EEVengers/ts_hardware_archive/Altium/Thunderscope_E/Schematics/FPGA.jpg

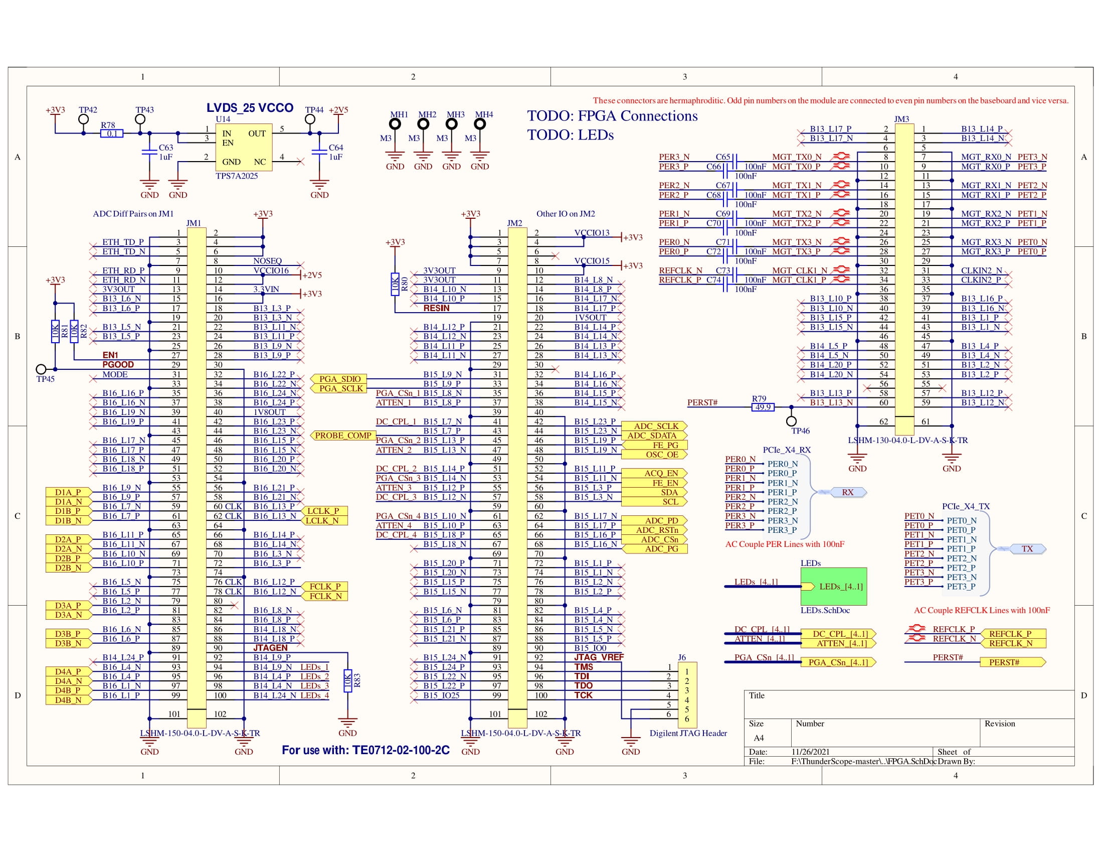
Altium/Thunderscope_E/Schematics/FPGA.jpg
