EEVengers/ts_hardware_archive/README.md

# ts_hardware_archive
Archived Hardware for ThunderScope 

All the hardware for this project is licensed under CERN-OHL-P-2.0
