EEVengers/ts_hardware_archive/Altium/Thunderscope_E/Schematics/ADC.jpg

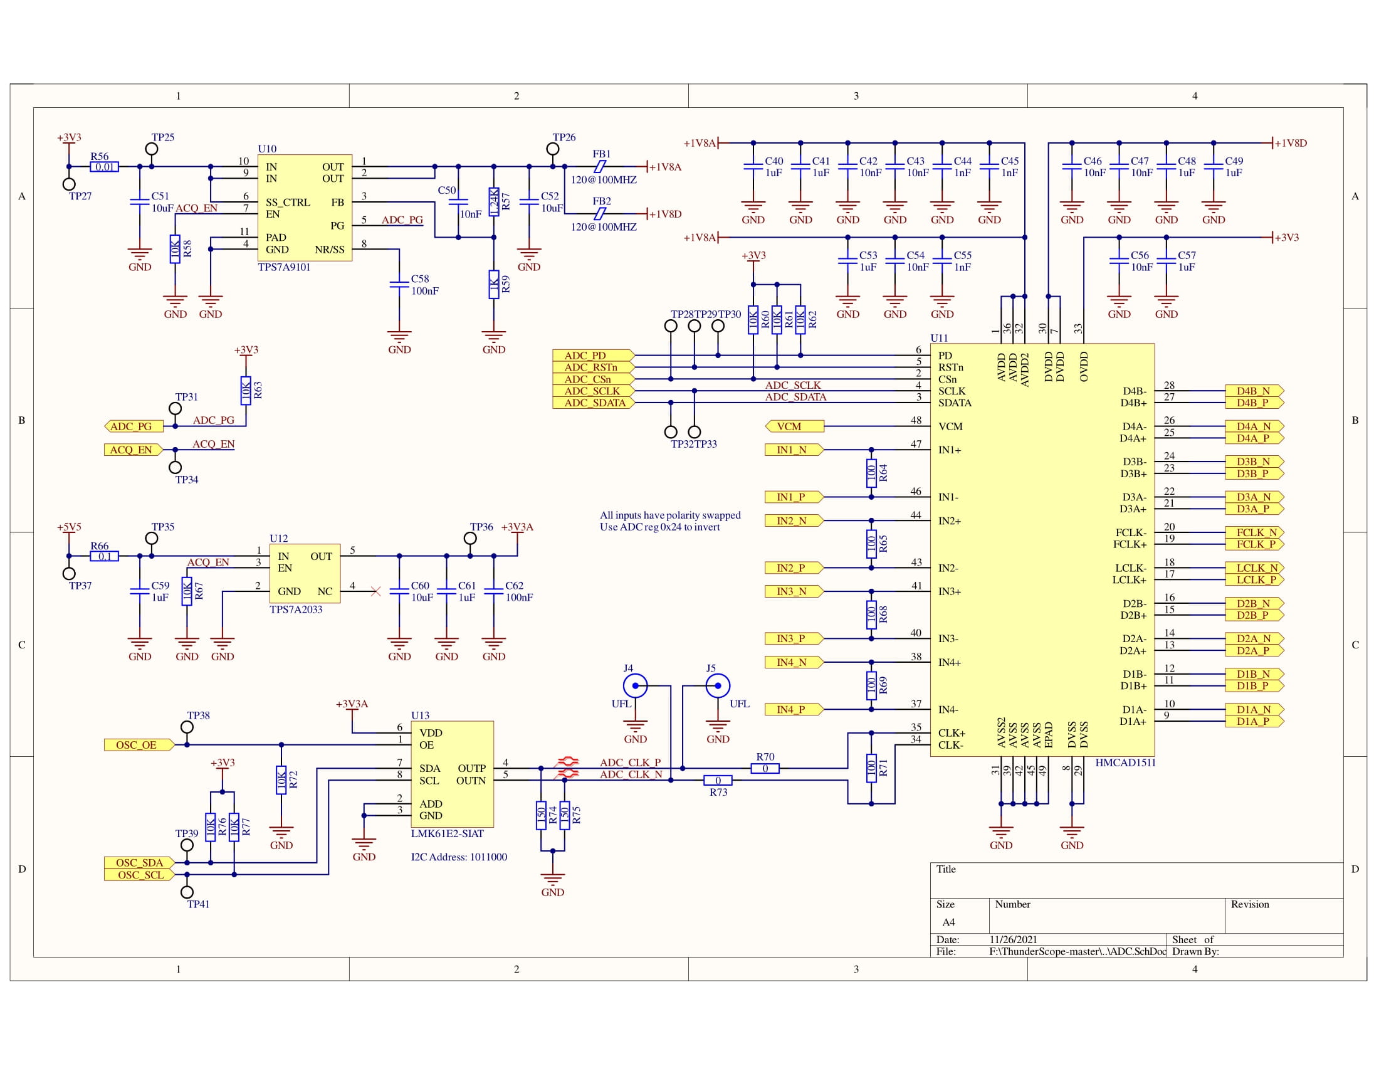
Altium/Thunderscope_E/Schematics/ADC.jpg
