EEVengers/ts_hardware_archive/Altium/Thunderscope_E/Schematics/Buffer.jpg

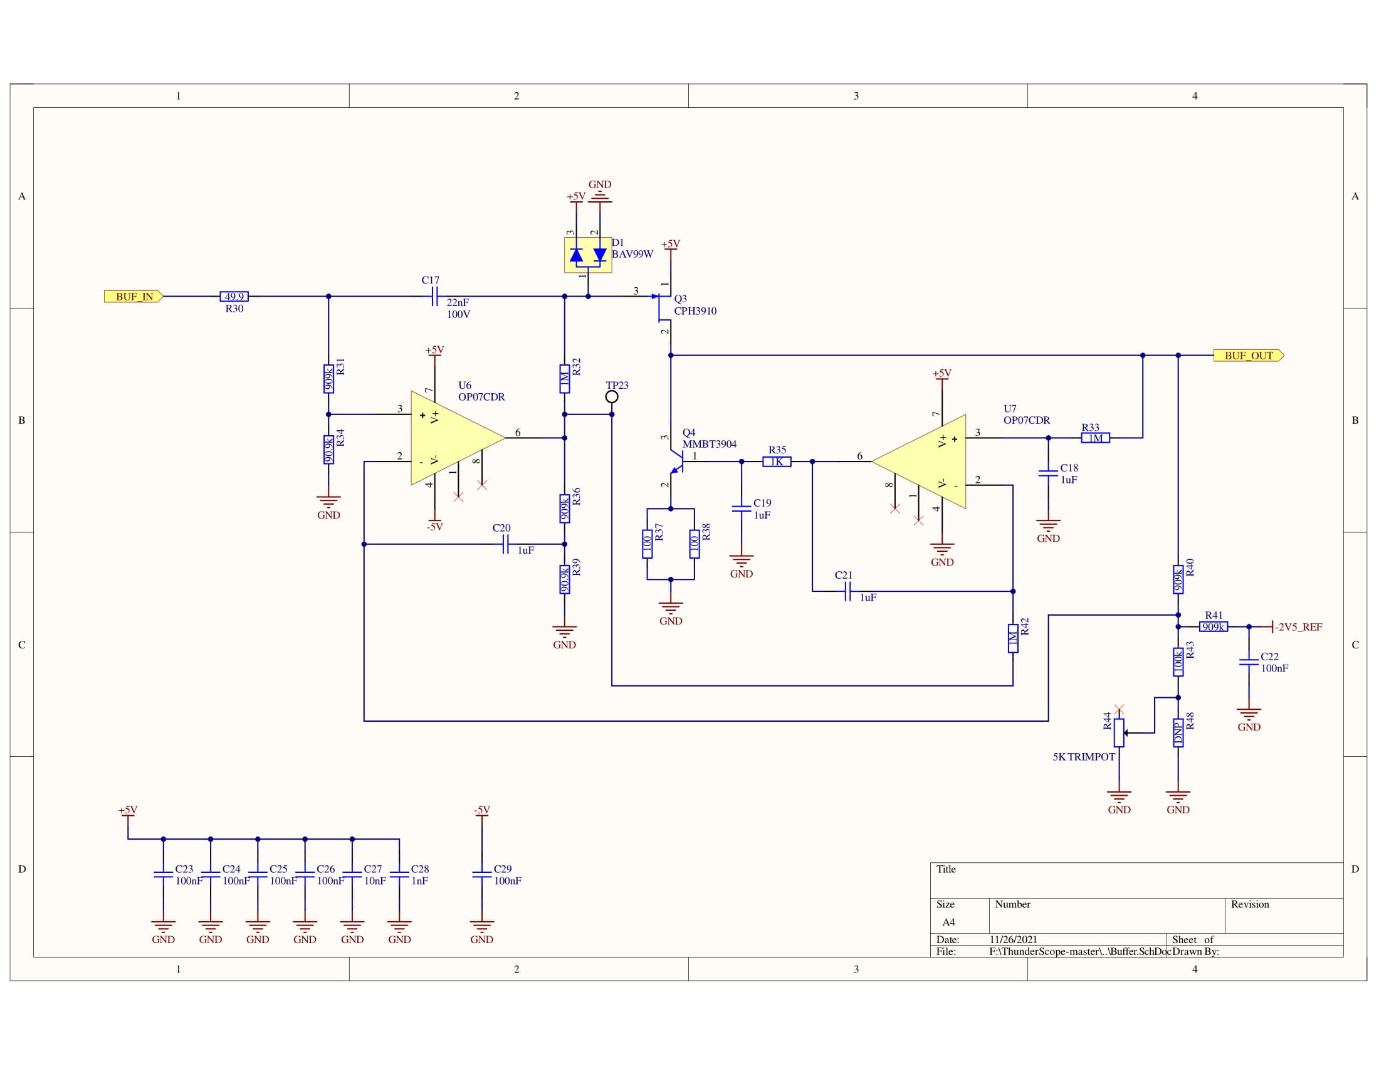
Altium/Thunderscope_E/Schematics/Buffer.jpg
