EEVengers/ts_hardware_archive/Altium/Thunderscope_E/Schematics/FE.jpg

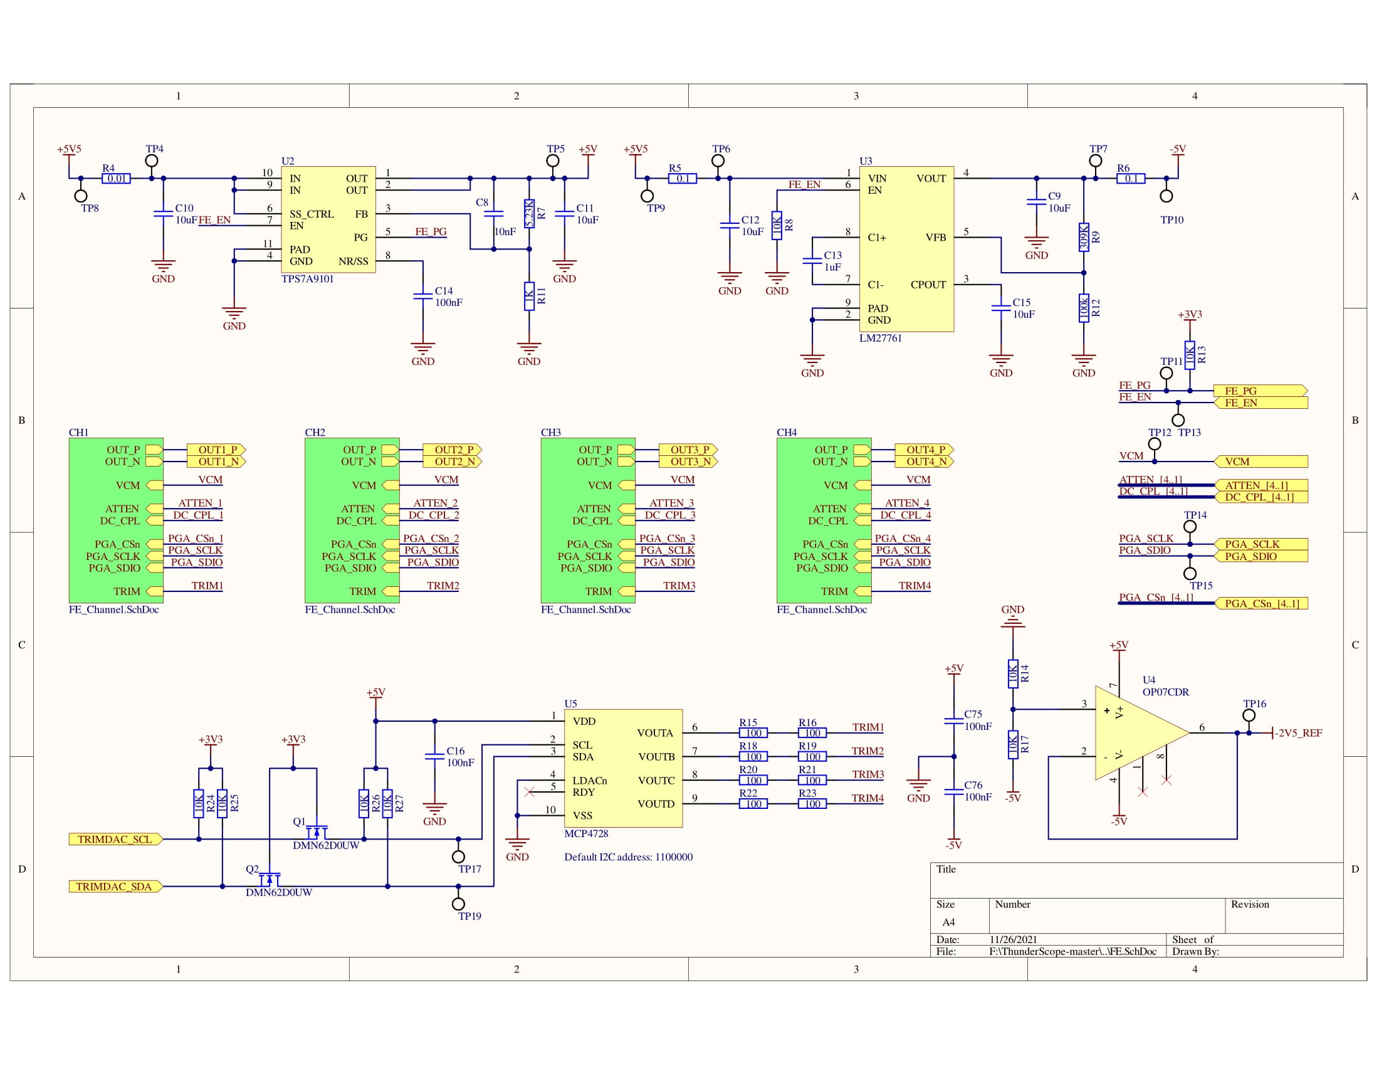
Altium/Thunderscope_E/Schematics/FE.jpg
