EEVengers/ts_hardware_archive/Altium/Thunderscope_E/Schematics/FE_Channel.jpg

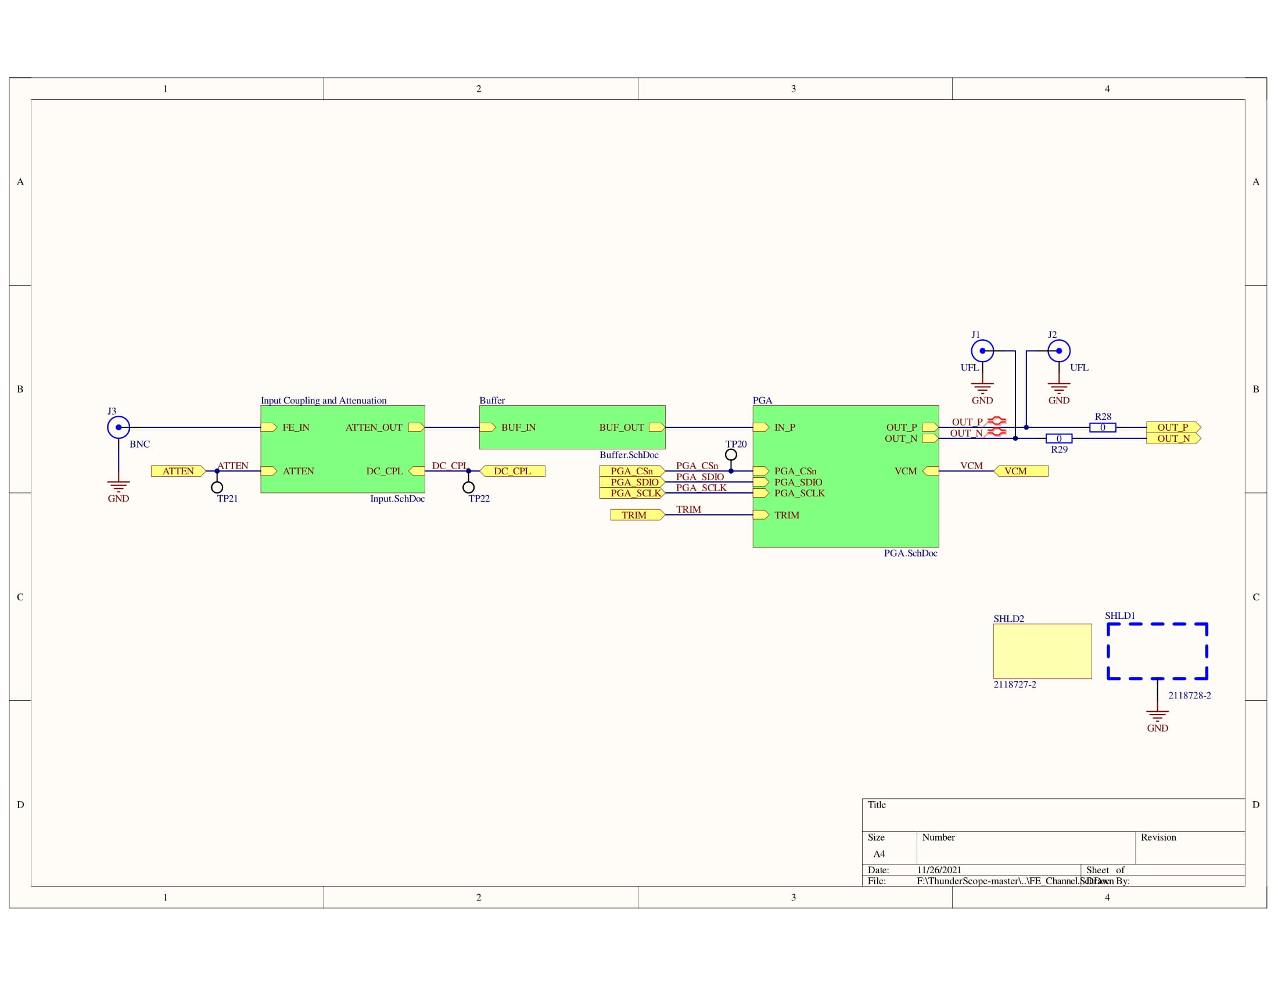
Altium/Thunderscope_E/Schematics/FE_Channel.jpg
