EEVengers/ts_hardware_archive/Altium/Thunderscope_E/Schematics/Input.jpg

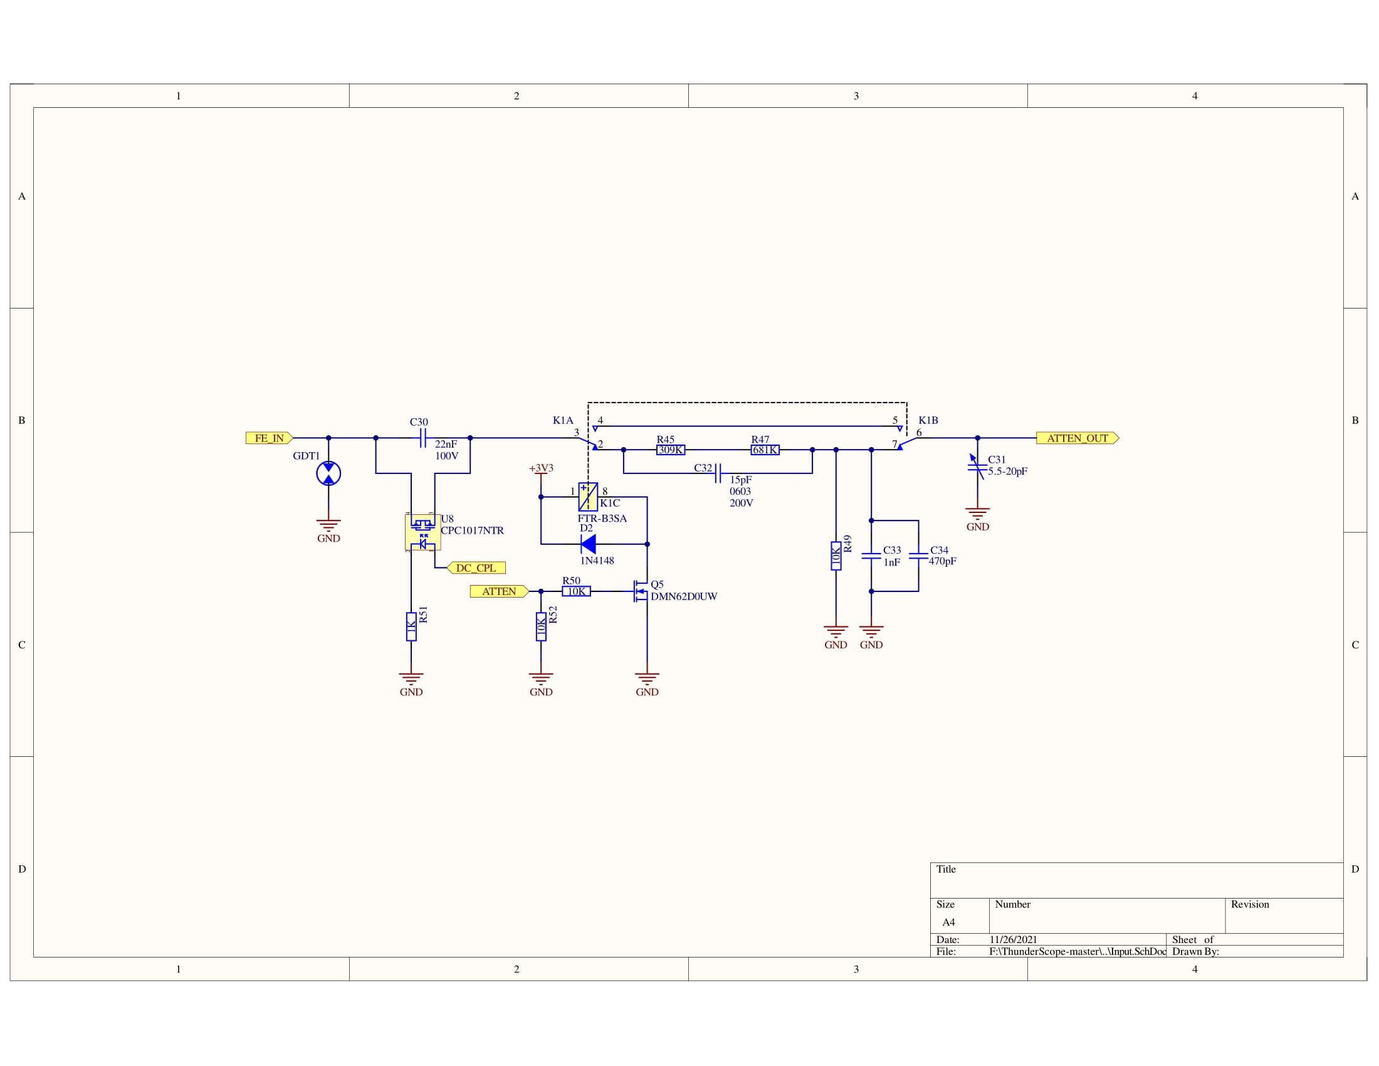
Altium/Thunderscope_E/Schematics/Input.jpg
