EEVengers/ts_hardware_archive/Altium/Thunderscope_E/Schematics/LEDs.jpg

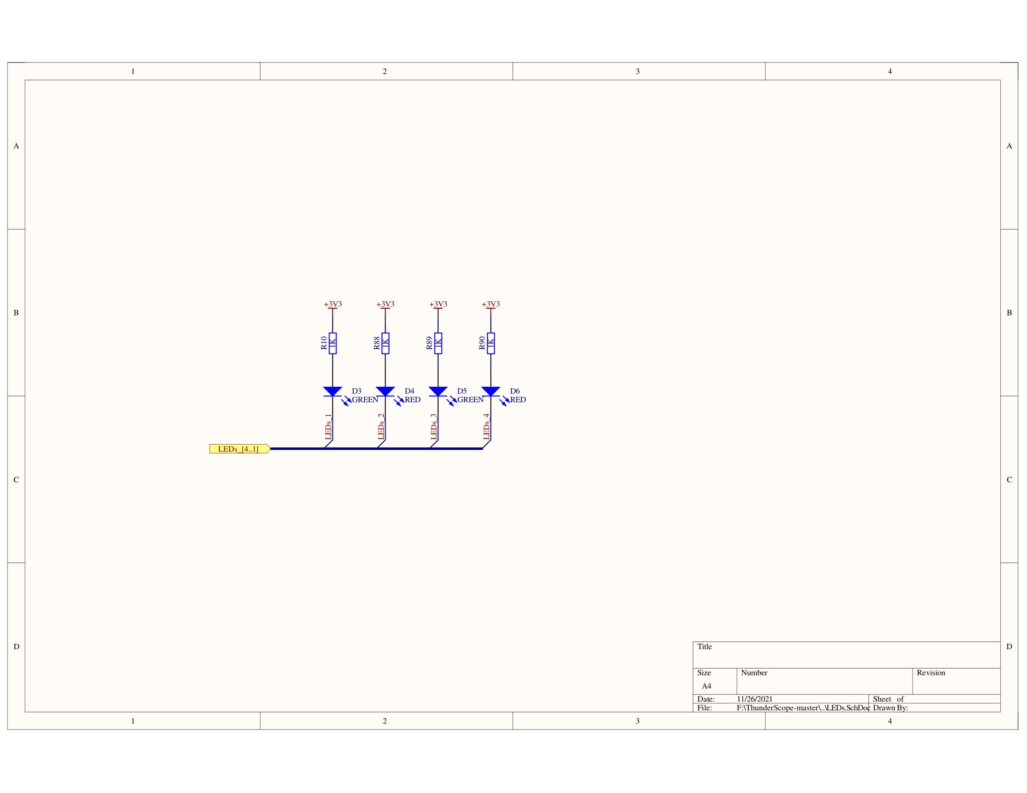
Altium/Thunderscope_E/Schematics/LEDs.jpg
