EEVengers/ts_hardware_archive/Altium/Thunderscope_E/Schematics/Main.jpg

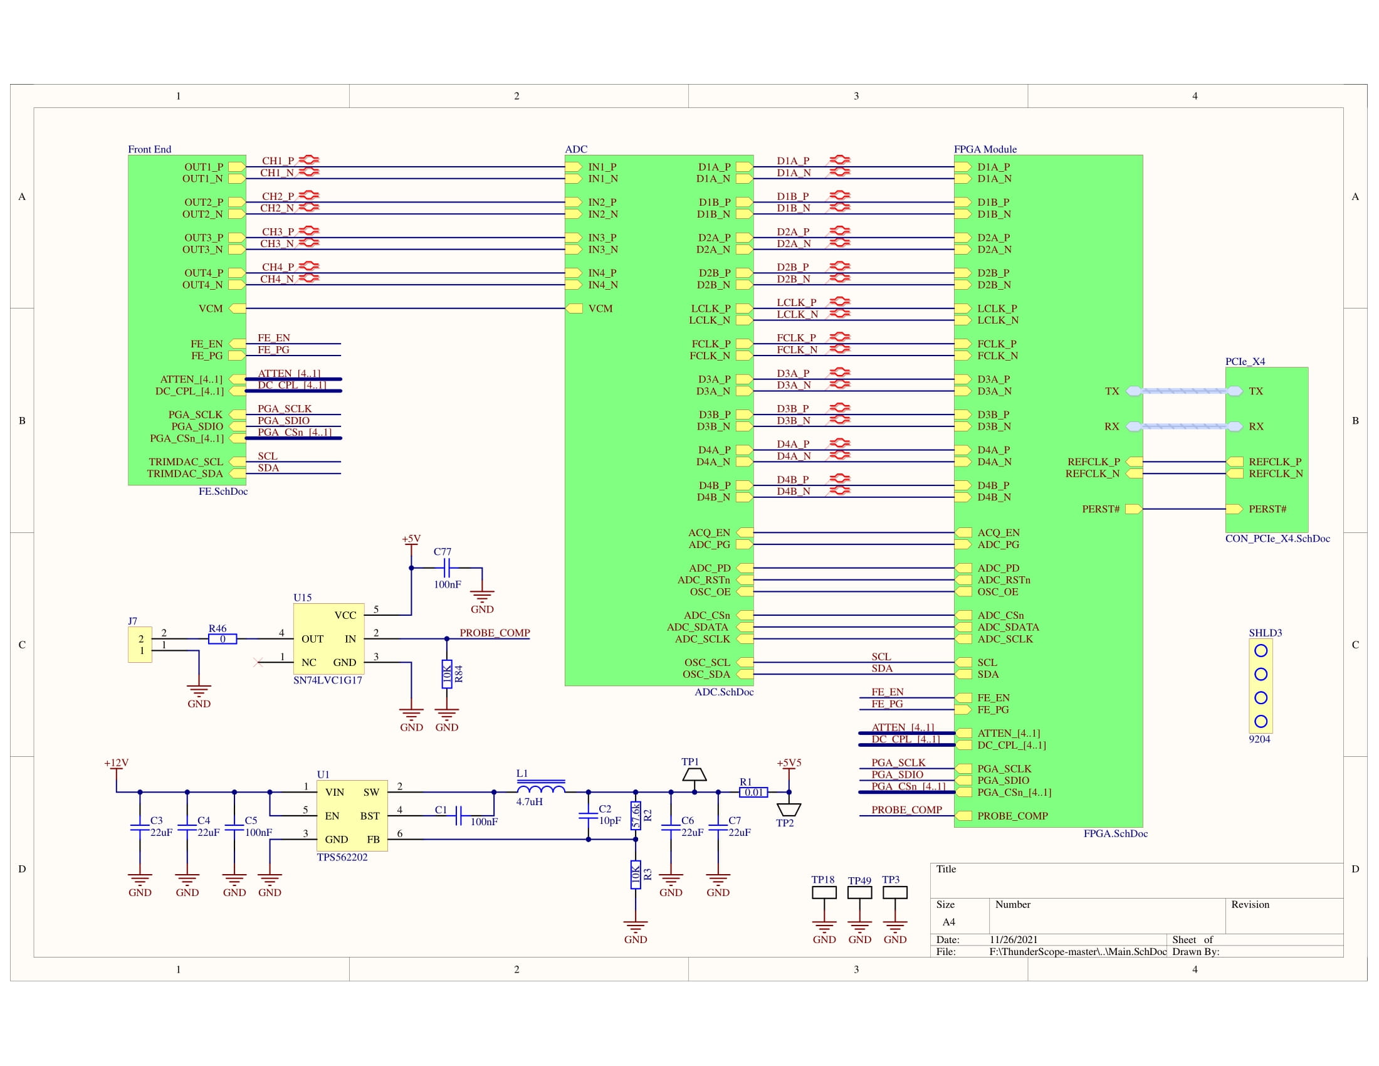
Altium/Thunderscope_E/Schematics/Main.jpg
