EEVengers/ts_hardware_archive/Altium/Thunderscope_E/Schematics/PGA.jpg

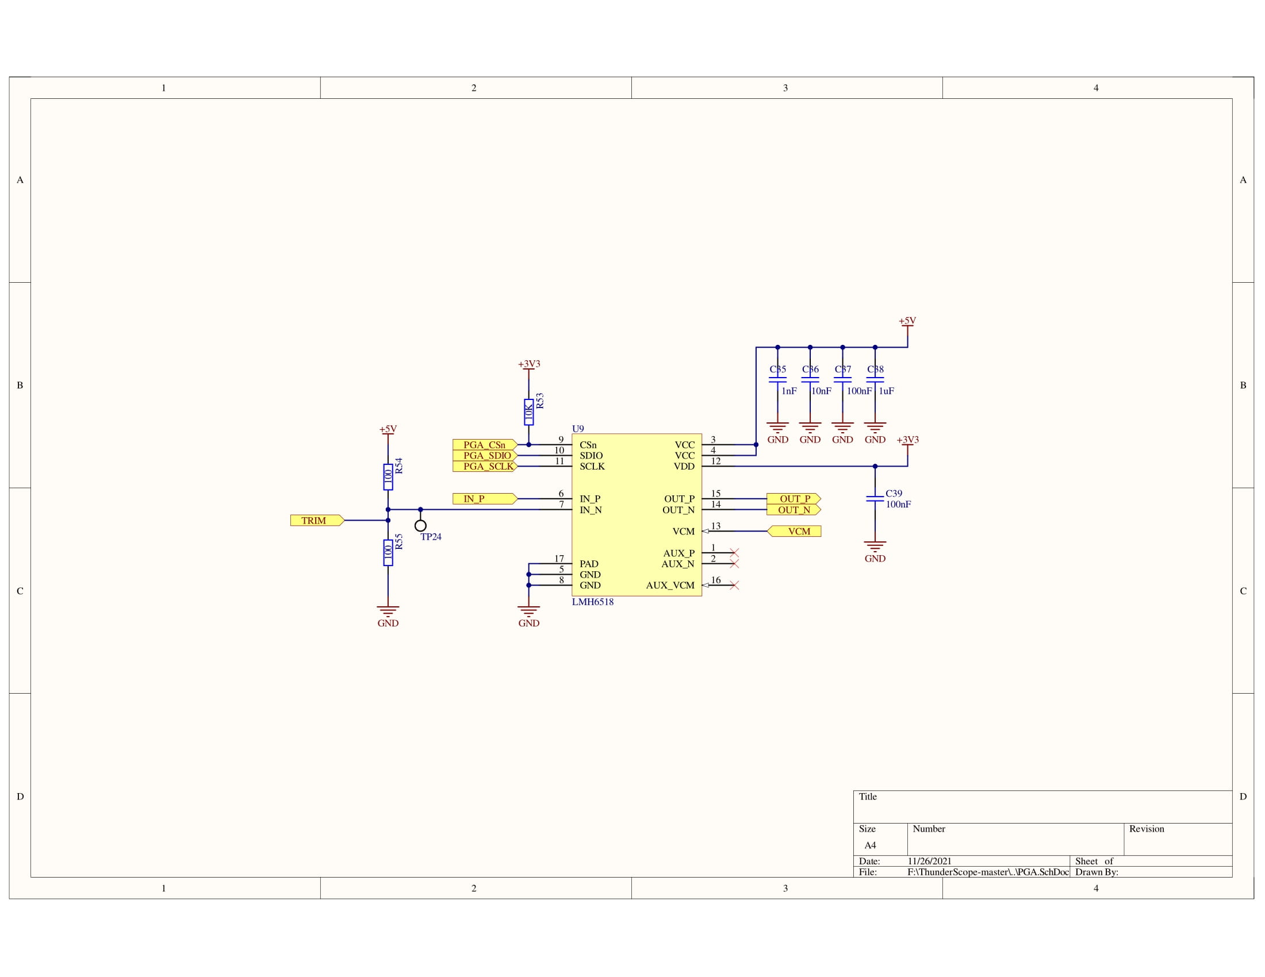
Altium/Thunderscope_E/Schematics/PGA.jpg
