EEVengers/ts_hardware_archive/Altium/FPGA_Module_Rev2/Project Outputs for FPGA_Module/BOM/Bill of Materials-FPGA_Module.xlsx

Comment | Designator | Footprint | LibRef | Quantity | Supplier Part Number 1
100nF | C1, C2, C3, C72, C78, C84 | GEN_C_0402 | CAP 100nF 16V X7R 0402 | 6 | 490-4759-1-ND
10nF | C4, C5, C16, C17 | GEN_C_0402 | CAP 10nF 50V X7R 0402 | 4 | 490-6351-1-ND
4.7uF | C6, C11, C18, C23, C28, C30, C31, C40, C41, C43, C44, C55, C56, C59, C60, C65, C70, C77, C85 | GEN_C_0402 | CAP 4.7uF 6.3V X5R 0402 | 19 | 490-5915-1-ND
470nF | C7, C8, C9, C10, C12, C13, C14, C15, C19, C20, C21, C22, C24, C25, C26, C27, C32, C33, C34, C35, C36, C37, C38, C39, C45, C46, C47, C48, C51, C52, C53, C54, C61, C62, C63, C64 | GEN_C_0201 | CAP 470nF 6.3V X5R 0201 | 36 | 490-10409-1-ND
47uF | C29, C42, C49, C50, C58 | GEN_C_0805 | CAP 47uF 6.3V X5R 0805 | 5 | 1276-1852-1-ND
100uF | C57 | GEN_C_1210 | CAP 100uF 6.3V X5R 1210 | 1 | 1276-1092-1-ND
100nF | C66, C67, C68, C69 | GEN_C_0201 | CAP 100nF 6.3V X5R 0201 | 4 | 490-3167-1-ND
10uF | C71, C79, C80, C83 | GEN_C_0603 | CAP 10uF 10V X5R 0603 | 4 | 490-10474-1-ND
39pF | C73, C81, C86 | GEN_C_0402 | CAP 39pF 50V C0G 0402 | 3 | 399-C0402C390J5GAC7867CT-ND
22uF | C75, C76, C82, C87 | GEN_C_0805 | CAP 22uF 25V X5R 0805 | 4 | 490-10749-1-ND
120@100MHZ | FB1, FB2, FB3 | GEN_R_0402 | FERRITE BEAD 120 OHM 0402 | 3 | 490-9656-1-ND
LSHM-150-04.0-L-DV-A-S-K-TR | JM1, JM2 | SAM_LSHM-150-XX.X-XX-DV-A-S | CONN LSHM-150-04.0-L-DV-A-S-K-TR | 2 | SAM9033CT-ND
LSHM-130-04.0-L-DV-A-S-K-TR | JM3 | SAM_LSHM-130-XX.X-XX-DV-A-S | CONN LSHM-130-04.0-L-DV-A-S-K-TR | 1 | SAM9034CT-ND
1uH | L1, L2, L3 | GEN_L_1210 | IND 1uH 5.5A 32 MOHM 1210 | 3 | 118-SRP3212-1R0MCT-ND
DMN62D0UW | Q1, Q2 | GEN_SOT_323 | NMOS DMN62D0UW | 2 | DMN62D0UW-7DICT-ND
100 | R1, R2, R3, R4, R5, R6, R7, R8, R9, R10, R11, R58, R62 | GEN_R_0201 | RES 100 OHM 1% 1/20W 0201 | 13 | 311-100MCT-ND
4.7K | R12, R13, R14, R15, R16, R59 | GEN_R_0201 | RES 4.7K OHM 1% 1/20W 0201 | 6 | 311-4.70KMTR-ND
240 | R17, R18 | GEN_R_0402 | RES 240 OHM 1% 1/16W 0402 | 2 | 311-240LRTR-ND
33 | R19, R20, R21, R22, R23, R24, R25, R26, R28, R29, R30, R32, R33, R34, R36, R37, R38, R39, R40, R41, R42, R43 | GEN_R_0201 | RES 33 OHM 1% 1/20W 0201 | 22 | RMCF0201FT33R0CT-ND
1K | R27, R35 | GEN_R_0402 | RES 1K OHM 1% 1/10W 0402 | 2 | 311-1.00KLRCT-ND
82 | R31 | GEN_R_0402 | RES 82 OHM 1% 1/16W 0402 | 1 | 311-82LRCT-ND
100k | R44, R45, R47, R48, R50, R52, R61 | GEN_R_0402 | RES 100K OHM 1% 1/10W 0402 | 7 | 311-100KLRCT-ND
66.5k | R46 | GEN_R_0402 | RES 66.5K OHM 1% 1/16W 0402 | 1 | YAG3209CT-ND
124k | R49 | GEN_R_0402 | RES 124K OHM 1% 1/10W 0402 | 1 | 311-124KLRCT-ND
200K | R51 | GEN_R_0402 | RES 200K OHM 1% 1/16W 0402 | 1 | 311-200KLRCT-ND
0.01 | R53, R54, R55, R56, R57 | GEN_R_0603 | RES 0.01 OHM 1% 1/4W 0603 | 5 | 408-1404-1-ND
140k | R60 | GEN_R_0402 | RES 140K OHM 1% 1/10W 0402 | 1 | YAG2978CT-ND
IC FPGA XC7A50T-2CSG325C | U1 | XILINX_XC7A50T-2CSG325C | IC FPGA XC7A50T-2CSG325C | 1
MX25U6432FZNI02 | U2 | MX_WSON8 | IC FLASH MX25U6432FZNI02 | 1 | 1092-MX25U6432FZNI02-ND
TXB0104RUTR | U3 | TI_UQFN_RUT0012A | IC TRNSLTR TXB0104RUTR | 1 | 296-25888-1-ND
IC DDR3 MT41K64M16JT-15E | U4, U5 | MICT-JT-96 | IC DDR3 MT41K64M16JT-15E | 2
SIP32508 | U6 | VISH_TSOT6 | IC SWITCH LOAD SIP32508 | 1 | SIP32508DT-T1-GE3CT-ND
LD57100JR | U7 | ST_FlipChip6 | IC LDO LD57100JR | 1 | 497-LD57100JRCT-ND
TPS62A01 | U8, U10 | TI_SOT563_DRL0006A | IC BUCK TPS62A01 | 2 | 595-TPS62A01DRLR
TPS62A02 | U9 | TI_SOT563_DRL0006A | IC BUCK TPS62A02 | 1 | 595-TPS62A02DRLR
25MHz | Y1 | ECS_TXO-2016 | OSC 25MHz ECS-TXO-2016 | 1 | XC3163CT-ND
