EEVengers/ts_hardware_archive/Altium/Thunderscope_E/Project Outputs for Thunderscope-E/BOM/Thunderscope-E.xlsx

Comment | Designator | Footprint | LibRef | Quantity | Supplier Part Number 1
100nF | C1, C5, C14, C16, C22A, C22B, C22C, C22D, C23A, C23B, C23C, C23D, C24A, C24B, C24C, C24D, C25A, C25B, C25C, C25D, C26A, C26B, C26C, C26D, C29A, C29B, C29C, C29D, C37A, C37B, C37C, C37D, C39A, C39B, C39C, C39D, C58, C62, C65, C66, C67, C68, C69, C70, C71, C72, C73, C74, C75, C76, C77 | GEN_C_0402 | CAP 100nF 16V X7R 0402 | 51 | 490-4759-1-ND
10pF | C2 | GEN_C_0402 | CAP 10pF 50V C0G 0402 | 1 | 1276-1139-1-ND
22uF | C3, C4, C6, C7 | GEN_C_0805 | CAP 22uF 25V X5R 0805 | 4 | 490-10749-1-ND
10nF | C8, C27A, C27B, C27C, C27D, C36A, C36B, C36C, C36D, C42, C43, C46, C47, C50, C54, C56 | GEN_C_0402 | CAP 10nF 50V X7R 0402 | 16 | 490-6351-1-ND
10uF | C9, C10, C11, C12, C15, C51, C52, C60 | GEN_C_0603 | CAP 10uF 10V X5R 0603 | 8 | 490-10474-1-ND
1uF | C13, C18A, C18B, C18C, C18D, C19A, C19B, C19C, C19D, C20A, C20B, C20C, C20D, C21A, C21B, C21C, C21D, C38A, C38B, C38C, C38D, C40, C41, C48, C49, C53, C57, C59, C61, C63, C64 | GEN_C_0402 | CAP 1uF 25V X5R 0402 | 31 | 490-10017-1-ND
22nF | C17A, C17B, C17C, C17D, C30A, C30B, C30C, C30D | GEN_C_0603 | CAP 22nF 100V X7R 0603 | 8 | 490-4782-1-ND
1nF | C28A, C28B, C28C, C28D, C33A, C33B, C33C, C33D, C35A, C35B, C35C, C35D, C44, C45, C55 | GEN_C_0402 | CAP 1nF 50V C0G 0402 | 15 | 490-6189-1-ND
5.5-20pF | C31A, C31B, C31C, C31D | EW_TRIMCAP | CAP TRIMMER 5.5-20PF 500V | 4 | 2447-SGC3S200NMCT-ND
15pF | C32A, C32B, C32C, C32D | GEN_C_0603 | CAP 15pF 200V C0G 0603 | 4 | 478-10254-1-ND
470pF | C34A, C34B, C34C, C34D | GEN_C_0402 | CAP 470pF 50V C0G 0402 | 4 | 490-8207-1-ND
BAV99W | D1A, D1B, D1C, D1D | GEN_SOT_323 | DIODE ARRAY BAV99W | 4 | BAV99W-FDICT-ND
1N4148 | D2A, D2B, D2C, D2D | GEN_SOD_323 | DIODE 1N4148 | 4 | 1N4148WS-FDICT-ND
GREEN | D3, D5 | LED_0603_APT1608 | LED GREEN 0603 APT1608 | 2 | 754-1934-1-ND
RED | D4, D6 | LED_0603_APT1608 | LED RED 0603 APT1608 | 2 | 754-1930-1-ND
120@100MHZ | FB1, FB2 | GEN_R_0402 | FERRITE BEAD 120 OHM 0402 | 2 | 490-9656-1-ND
GDT | GDT1A, GDT1B, GDT1C, GDT1D | BOU_2051 | GDT 90V | 4 | 2051-09-SM-RPLFCT-ND
UFL | J1A, J1B, J1C, J1D, J2A, J2B, J2C, J2D, J4, J5 | TE_2334884-1 | UFL Jack SMD | 10 | A145155CT-ND
BNC | J3A, J3B, J3C, J3D | MOL_0731000105 | BNC JACK R/A | 4 | WM5524-ND
2.54mm 6 Pin TH | J6 | GEN_2.54mm_6_Pin_TH_RA | CONN 2.54mm 6 Pin TH RA | 1 | 732-5339-ND
TSW-101-08-F-D-RA | J7 | GEN_2.54mm_1x2_Pin_TH_RA | CONN 2.54mm 2 Pin TH RA | 1 | SAM12296-ND
LSHM-150-04.0-L-DV-A-S-K-TR | JM1, JM2 | SAM_LSHM-150-XX.X-XX-DV-A-S | CONN LSHM-150-04.0-L-DV-A-S-K-TR | 2 | SAM9033CT-ND
LSHM-130-04.0-L-DV-A-S-K-TR | JM3 | SAM_LSHM-130-XX.X-XX-DV-A-S | CONN LSHM-130-04.0-L-DV-A-S-K-TR | 1 | SAM9034CT-ND
FTR-B3SA | K1A, K1B, K1C, K1D | FUJ_FTR-B3SA | RELAY DPDT-NO FTR-B3SA | 4 | 817-FTR-B3SA003Z
4.7uH | L1 | TY_IND_NRS5030 | IND 4.7uH 2.6A 35 MOHM SMD | 1 | 587-3461-1-ND
DMN62D0UW | Q1, Q2, Q5A, Q5B, Q5C, Q5D | GEN_SOT_323 | NMOS DMN62D0UW | 6 | DMN62D0UW-7DICT-ND
CPH3910 | Q3A, Q3B, Q3C, Q3D | ON_SOT23_CPH3 | NJFET CPH3910 | 4 | CPH3910-TL-EOSCT-ND
MMBT3904 | Q4A, Q4B, Q4C, Q4D | MMC_SOT23 | NPN MMBT3904 | 4 | MMBT3904TPMSCT-ND
0.01 | R1, R4, R56, R86, R87 | GEN_R_0603 | RES 0.01 OHM 1% 1/4W 0603 | 5 | 408-1404-1-ND
57.6k | R2 | GEN_R_0402 | RES 57.6K OHM 1% 1/16W 0402 | 1 | YAG3190CT-ND
10K | R3, R8, R13, R14, R17, R24, R25, R26, R27, R49A, R49B, R49C, R49D, R50A, R50B, R50C, R50D, R52A, R52B, R52C, R52D, R53A, R53B, R53C, R53D, R58, R60, R61, R62, R63, R67, R72, R76, R77, R80, R81, R82, R83, R84 | GEN_R_0402 | RES 10K OHM 1% 1/10W 0402 | 39 | P10.0KLCT-ND
0.1 | R5, R6, R66, R78 | GEN_R_0402 | RES 0.1 OHM 1% 1/6W 0402 | 4 | P.10AKCT-ND
5.23K | R7 | GEN_R_0402 | RES 5.23K OHM 1% 1/16W 0402 | 1 | YAG3195CT-ND
309K | R9, R45A, R45B, R45C, R45D | GEN_R_0402 | RES 309K OHM 1% 1/16W 0402 | 5 | YAG3108CT-ND
1K | R10, R11, R35A, R35B, R35C, R35D, R51A, R51B, R51C, R51D, R59, R88, R89, R90 | GEN_R_0402 | RES 1K OHM 1% 1/10W 0402 | 14 | 311-1.00KLRCT-ND
100k | R12, R43A, R43B, R43C, R43D | GEN_R_0402 | RES 100K OHM 1% 1/10W 0402 | 5 | 311-100KLRCT-ND
100 | R15, R16, R18, R19, R20, R21, R22, R23, R37A, R37B, R37C, R37D, R38A, R38B, R38C, R38D, R54A, R54B, R54C, R54D, R55A, R55B, R55C, R55D, R64, R65, R68, R69, R71 | GEN_R_0402 | RES 100 OHM 1% 1/10W 0402 | 29 | 2019-RK73H1ETTP1000FCT-ND
0 | R28A, R28B, R28C, R28D, R29A, R29B, R29C, R29D, R46, R70, R73, R85 | GEN_R_0402 | RES 0 OHM 1/16W 0402 | 12 | 311-0.0JRCT-ND
49.9 | R30A, R30B, R30C, R30D, R79 | GEN_R_0402 | RES 49.9 OHM 1% 1/10W 0402 | 5 | 311-49.9LRCT-ND
909k | R31A, R31B, R31C, R31D, R36A, R36B, R36C, R36D, R40A, R40B, R40C, R40D, R41A, R41B, R41C, R41D | GEN_R_0402 | RES 909K OHM 1% 1/16W 0402 | 16 | YAG2377CT-ND
1M | R32A, R32B, R32C, R32D, R33A, R33B, R33C, R33D, R42A, R42B, R42C, R42D | GEN_R_0402 | RES 1M OHM 1% 1/10W 0402 | 12 | P1.00MLCT-ND
90.9k | R34A, R34B, R34C, R34D, R39A, R39B, R39C, R39D | GEN_R_0402 | RES 90.9K OHM 1% 1/16W 0402 | 8 | 311-90.9KLRCT-ND
5K TRIMPOT | R44A, R44B, R44C, R44D | BOU_3mm_POT | TRIMMER 5K OHM 0.1W J LEAD TOP | 4 | TC33X-502ECT-ND
681K | R47A, R47B, R47C, R47D | GEN_R_0402 | RES 681K OHM 1% 1/16W 0402 | 4 | YAG3212CT-ND
1.24K | R57 | GEN_R_0402 | RES 1.24K OHM 1% 1/16W 0402 | 1 | 311-1.24KLRCT-ND
150 | R74, R75 | GEN_R_0402 | RES 150 OHM 1% 1/16W 0402 | 2 | 311-150LRCT-ND
2118728-2 | SHLD1A, SHLD1B, SHLD1C, SHLD1D | TE_2118728-2 | SHIELD 2118728-2 | 4 | A126158CT-ND
2118727-2 | SHLD2A, SHLD2B, SHLD2C, SHLD2D |  | SHIELD 2118727-2 | 4 | A126132-ND
9204 | SHLD3 |  | PCIe IO Shield | 1 | 534-9204
5015 | TP1, TP2, TP47, TP48, TP50, TP51 | KEY_5015 | TP KEYSTONE 5015 | 6 | 36-5015CT-ND
5019 | TP3, TP18, TP49 | KEY_5019 | TP KEYSTONE 5019 | 3 | 36-5019CT-ND
TPS562202 | U1 | TI_SOT563_DRL0006A | IC BUCK TPS562202 | 1 | 296-TPS562202DRLRCT-ND
TPS7A9101 | U2, U10 | TI_WSON10_DSK0010A | IC LDO TPS7A9101 | 2 | 296-45298-1-ND
LM27761 | U3 | TI_WSON8_DSG0008A | IC CPUMP LM27761 | 1 | 296-44379-1-ND
OP07CDR | U4, U6A, U6B, U6C, U6D, U7A, U7B, U7C, U7D | TI_SOIC8_D0008A | IC OPAMP OP07CDR | 9 | 296-14626-1-ND
MCP4728 | U5 | MC_MSOP10_UN | IC DAC QUAD MCP4728 | 1 | MCP4728A1T-E/UNCT-ND
CPC1017NTR | U8A, U8B, U8C, U8D | IXY_CPC1017 | SSR CPC1017NTR | 4 | CLA233CT-ND
LMH6518 | U9A, U9B, U9C, U9D | TI_WQFN_RGH0016A | IC PGA LMH6518 | 4 | LMH6518SQE/NOPBCT-ND
HMCAD1511 | U11 | AD_QFN48_LP7 | IC ADC HMCAD1511 | 1 | 1127-1648-ND
TPS7A2033 | U12 | GEN_SOT23_5_950_2900X1600X1450 | IC LDO TPS7A2033 | 1 | 296-TPS7A2033PDBVRCT-ND
LMK61E2-SIAT | U13 | TI_QFM8_SIA0008B | IC PROG OSC LMK61E2-SIAT | 1 | 296-43212-1-ND
TPS7A2025 | U14 | GEN_SOT23_5_950_2900X1600X1450 | IC LDO TPS7A2025 | 1 | 296-TPS7A2025PDBVRCT-ND
SN74LVC1G17 | U15 | GEN_SC-70-5 | IC BUFFER SN74LVC1G17 | 1 | 296-11934-1-ND
