EEVengers/ts_hardware_archive/Mechanical/Thunderscope Assembly.FCStd

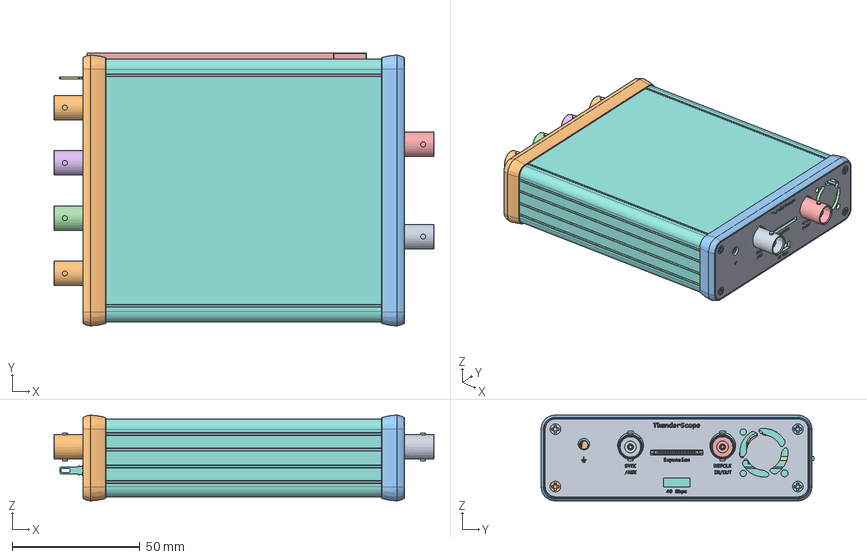
[picture p10: CAD file, 2026-06-19]
Mechanical/Thunderscope Assembly.FCStd
148.9 x 106.9 x 33.6 mm
kicad_embedded_9252BFF21049B2AECF2D3FAEF6000444
Thunderscope_Rev5_Mech_Model 1.4.1
Thunderscope_Rev5_Mech_Model 1.4.002
Thunderscope_Rev5_Mech_Model 1.4.003
Thunderscope_Rev5_Mech_Model 1.4.004
Thunderscope_Rev5_Mech_Model 1.4.005
Thunderscope_Rev5_Mech_Model 1.4.006
Thunderscope_Rev5_Mech_Model 1.4.007
Thunderscope_Rev5_Mech_Model 1.4.008
Thunderscope_Rev5_Mech_Model 1.4.009
Thunderscope_Rev5_Mech_Model 1.4.010
Thunderscope_Rev5_Mech_Model 1.4.011
Thunderscope_Rev5_Mech_Model 1.4.012
Thunderscope_Rev5_Mech_Model 1.4.013
Thunderscope_Rev5_Mech_Model 1.4.014
Thunderscope_Rev5_Mech_Model 1.4.015
Thunderscope_Rev5_Mech_Model 1.4.016
Thunderscope_Rev5_Mech_Model 1.4.017
Thunderscope_Rev5_Mech_Model 1.4.018
Thunderscope_Rev5_Mech_Model 1.4.019
Thunderscope_Rev5_Mech_Model 1.4.020
Thunderscope_Rev5_Mech_Model 1.4.021
Thunderscope_Rev5_Mech_Model 1.4.022
Thunderscope_Rev5_Mech_Model 1.4.023
Thunderscope_Rev5_Mech_Model 1.4.024
Thunderscope_Rev5_Mech_Model 1.4.025
Thunderscope_Rev5_Mech_Model 1.4.026
Thunderscope_Rev5_Mech_Model 1.4.027
Thunderscope_Rev5_Mech_Model 1.4.028
Thunderscope_Rev5_Mech_Model 1.4.029
Thunderscope_Rev5_Mech_Model 1.4.030
Thunderscope_Rev5_Mech_Model 1.4.031
00-9155-002-852-00X-STP-BM
Mid_Body
Mark
Mid_Body001
Mark001
00-9155-002-852-00X-STP-BM001
Mid_Body002
Mark002
APFA3010LSEEZGKQBKC--3DModel-STEP-56544
APFA3010LSEEZGKQBKC--3DModel-STEP-56545
APFA3010LSEEZGKQBKC--3DModel-STEP-56546
APFA3010LSEEZGKQBKC--3DModel-STEP-56547
APFA3010LSEEZGKQBKC--3DModel-STEP-56548
APFA3010LSEEZGKQBKC--3DModel-STEP-56549
APFA3010LSEEZGKQBKC--3DModel-STEP-56550
APFA3010LSEEZGKQBKC--3DModel-STEP-56551
APFA3010LSEEZGKQBKC--3DModel-STEP-56552
00-9155-002-852-00X-STP-BM002
kicad_embedded_C74989BB418CD5CD326C81C3A882AC06
6130xx11021_PIN
6130xx11021_PIN001
6130xx11021_PIN002
6130xx11021_PIN003
6130xx11021_PIN004
6130xx11021_PIN005
Thunderscope_Rev5_Mech_Model_silkscreen
Thunderscope_Rev5_Mech_Model_silkscreen001
Thunderscope_Rev5_Mech_Model_silkscreen002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
