EEVengers/ts_hardware_archive/Altium/M.2_Interposer/Adaptor_Board.step

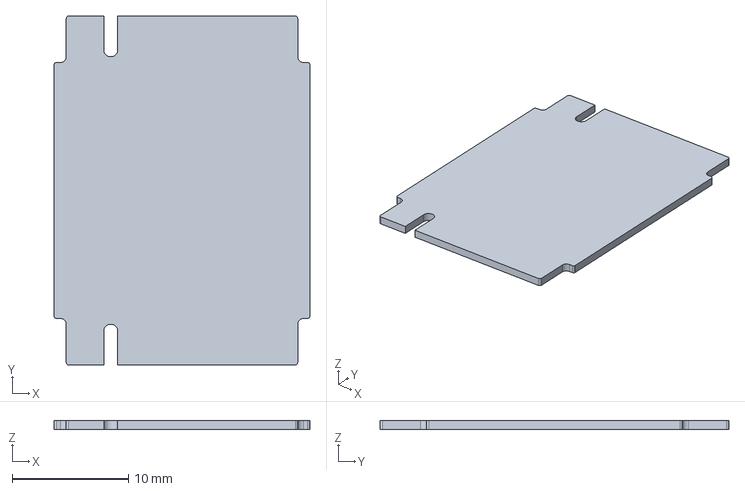
[picture p11: CAD file, 2026-06-19]
Altium/M.2_Interposer/Adaptor_Board.step
22.0 x 30.0 x 0.781 mm
