EEVengers/ts_hardware_archive/Mechanical/TB_Board.step

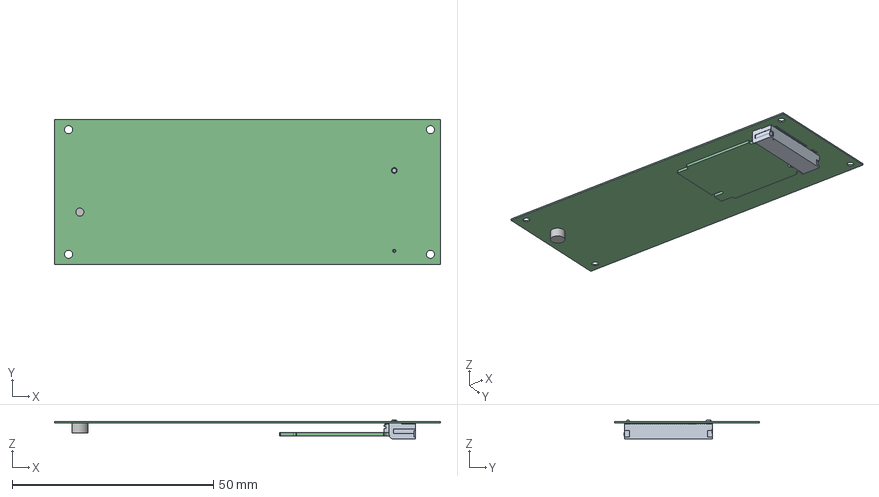
[picture p12: CAD file, 2026-06-19]
Mechanical/TB_Board.step
96.0 x 36.0 x 4.70 mm
Open_CASCADE_STEP_translator_6.8_3.1.1
c-1-2199230-5-b3-3d
