EEVengers/ts_hardware_archive/Mechanical/TS_Front_Endcap.step

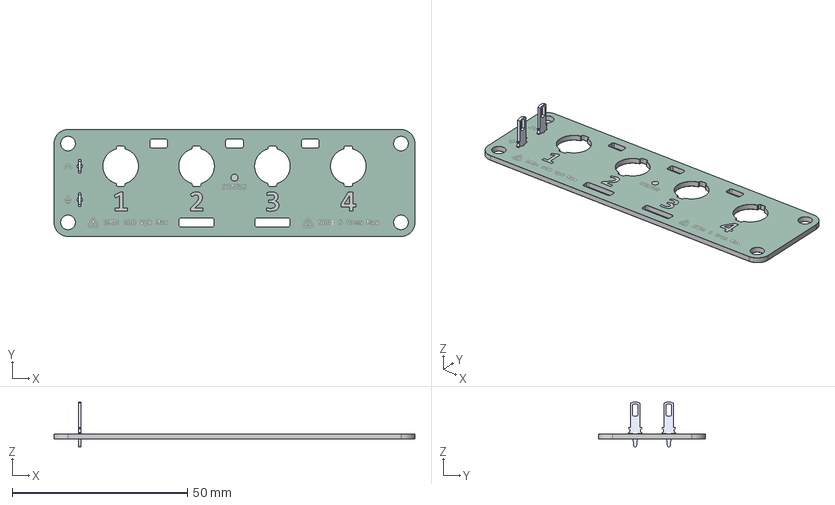
[picture p13: CAD file, 2026-06-19]
Mechanical/TS_Front_Endcap.step
103.0 x 30.5 x 12.8 mm
keystone-PN1046 x 2
TS_Front_Endcap_silkscreen
TS_Front_Endcap_soldermask
TS_Front_Endcap_PCB
