EEVengers/ts_hardware_archive/Mechanical/TS_Back_Endcap.step

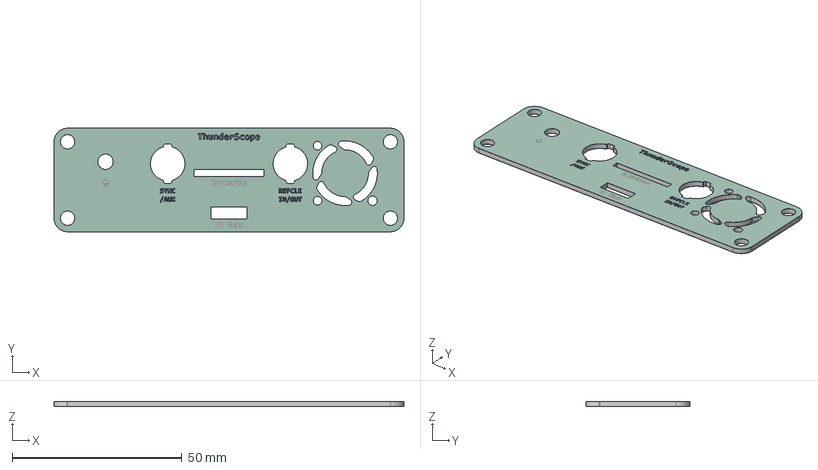
[picture p14: CAD file, 2026-06-19]
Mechanical/TS_Back_Endcap.step
103.0 x 30.5 x 1.66 mm
TS_Back_Endcap_silkscreen
TS_Back_Endcap_soldermask
TS_Back_Endcap_PCB
