EEVengers/ts_hardware_archive/Mechanical/Interposer_Board_JoneyTech.step

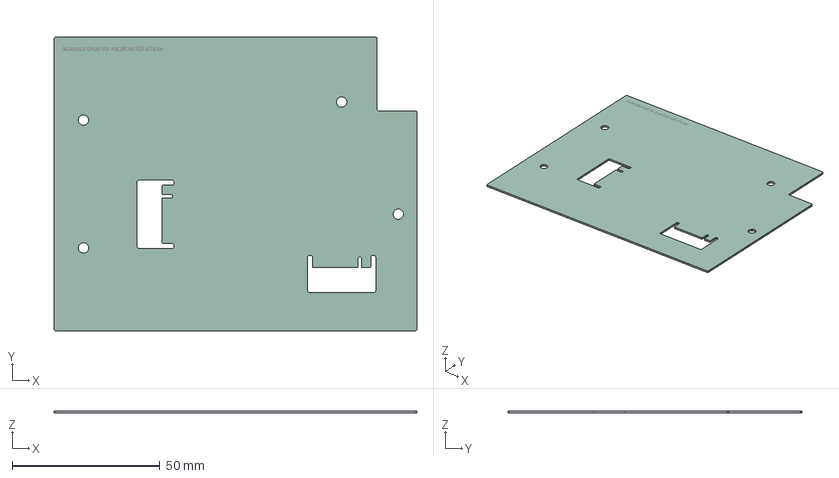
[picture p15: CAD file, 2026-06-19]
Mechanical/Interposer_Board_JoneyTech.step
123.0 x 99.5 x 0.816 mm
Interposer_Board_JoneyTech_silkscreen
Interposer_Board_JoneyTech_soldermask
Interposer_Board_JoneyTech_PCB
