EEVengers/ts_hardware_archive/Mechanical/TS PCIe Bracket.step

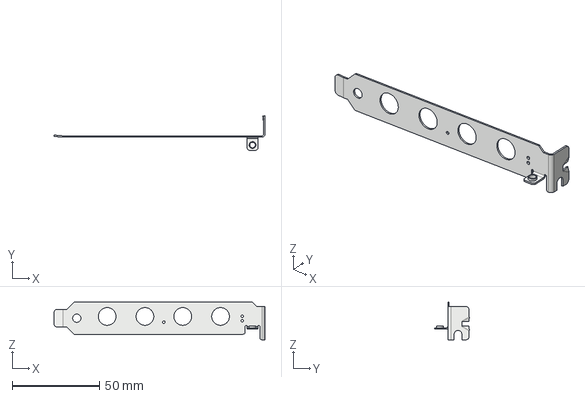
[picture p16: CAD file, 2026-06-19]
Mechanical/TS PCIe Bracket.step
120.9 x 19.8 x 21.6 mm
