EEVengers/ts_hardware_archive/Mechanical/Hammond-1455L1201BK.step

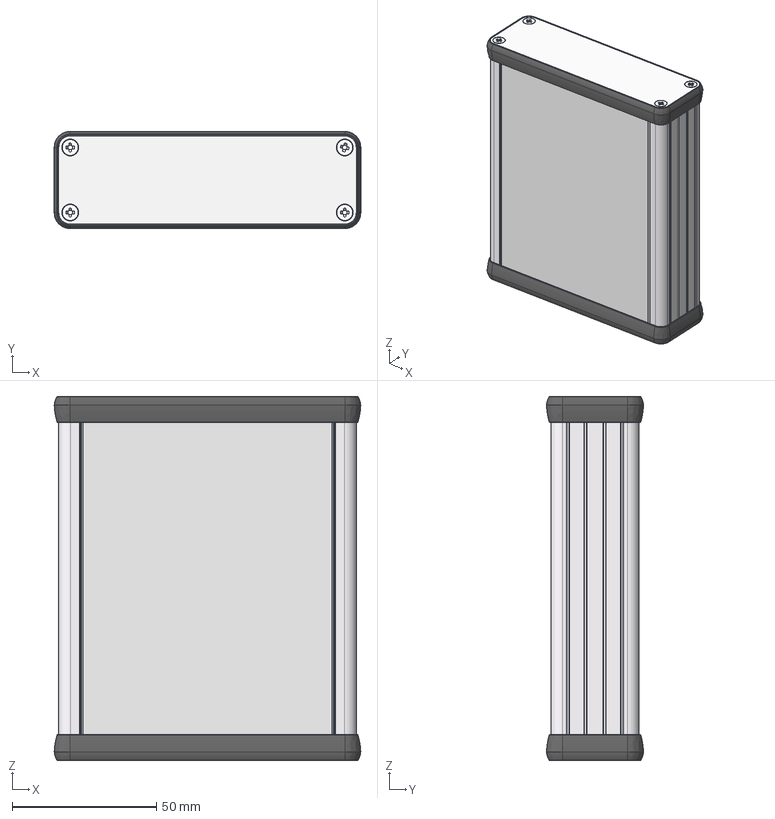
[picture p17: CAD file, 2026-06-19]
Mechanical/Hammond-1455L1201BK.step
106.1 x 33.6 x 126.0 mm
L Extrusion 120mm
L Cap Extrusion 120mm
N Bezel x 2
N1 End Panel x 2
1455 screw x 8
