EEVengers/ts_hardware_archive/Altium/Rev5_FE_Test_V2/Rev5_FE_Test_V2.pdf

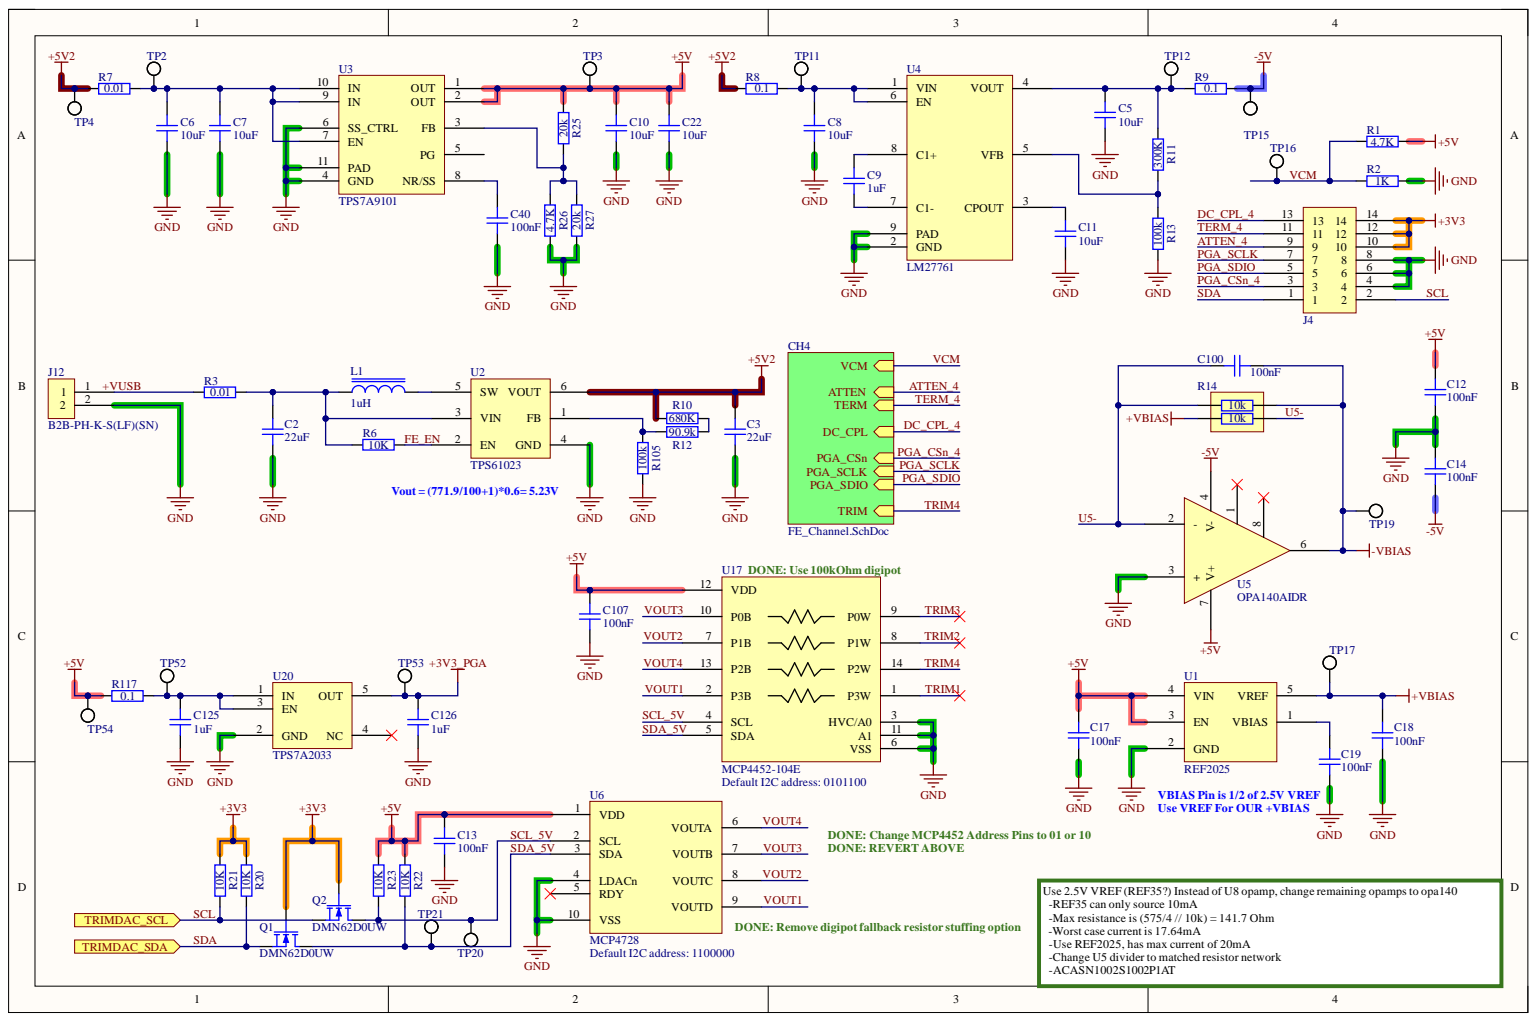
[picture p22: page 1]

VBIAS Pin is 1/2 of 2.5V VREF

DONE: Change MCP4452 Address Pins to 01 or 10
DONE: REVERT ABOVE

Title
Use 2.5V VREF (REF35?) Instead of U8 opamp, change remaining opamps to opa140
ThunderScope 1000E
-REF35 can only source 10mA
-Max resistance is (575/4 // 10k) = 141.7 Ohm
-Worst case current is 17.64mA
-Use REF2025, has max current of 20mA
-Change U5 divider to matched resistor network

DONE: Remove digipot fallback resistor stuffing option

Date: 11-09-2024 -ACASN1002S1002P1AT | Sheet of
File: C:\Users\..\FE.SchDoc | Drawn By: Aleksa Bjelogrlic

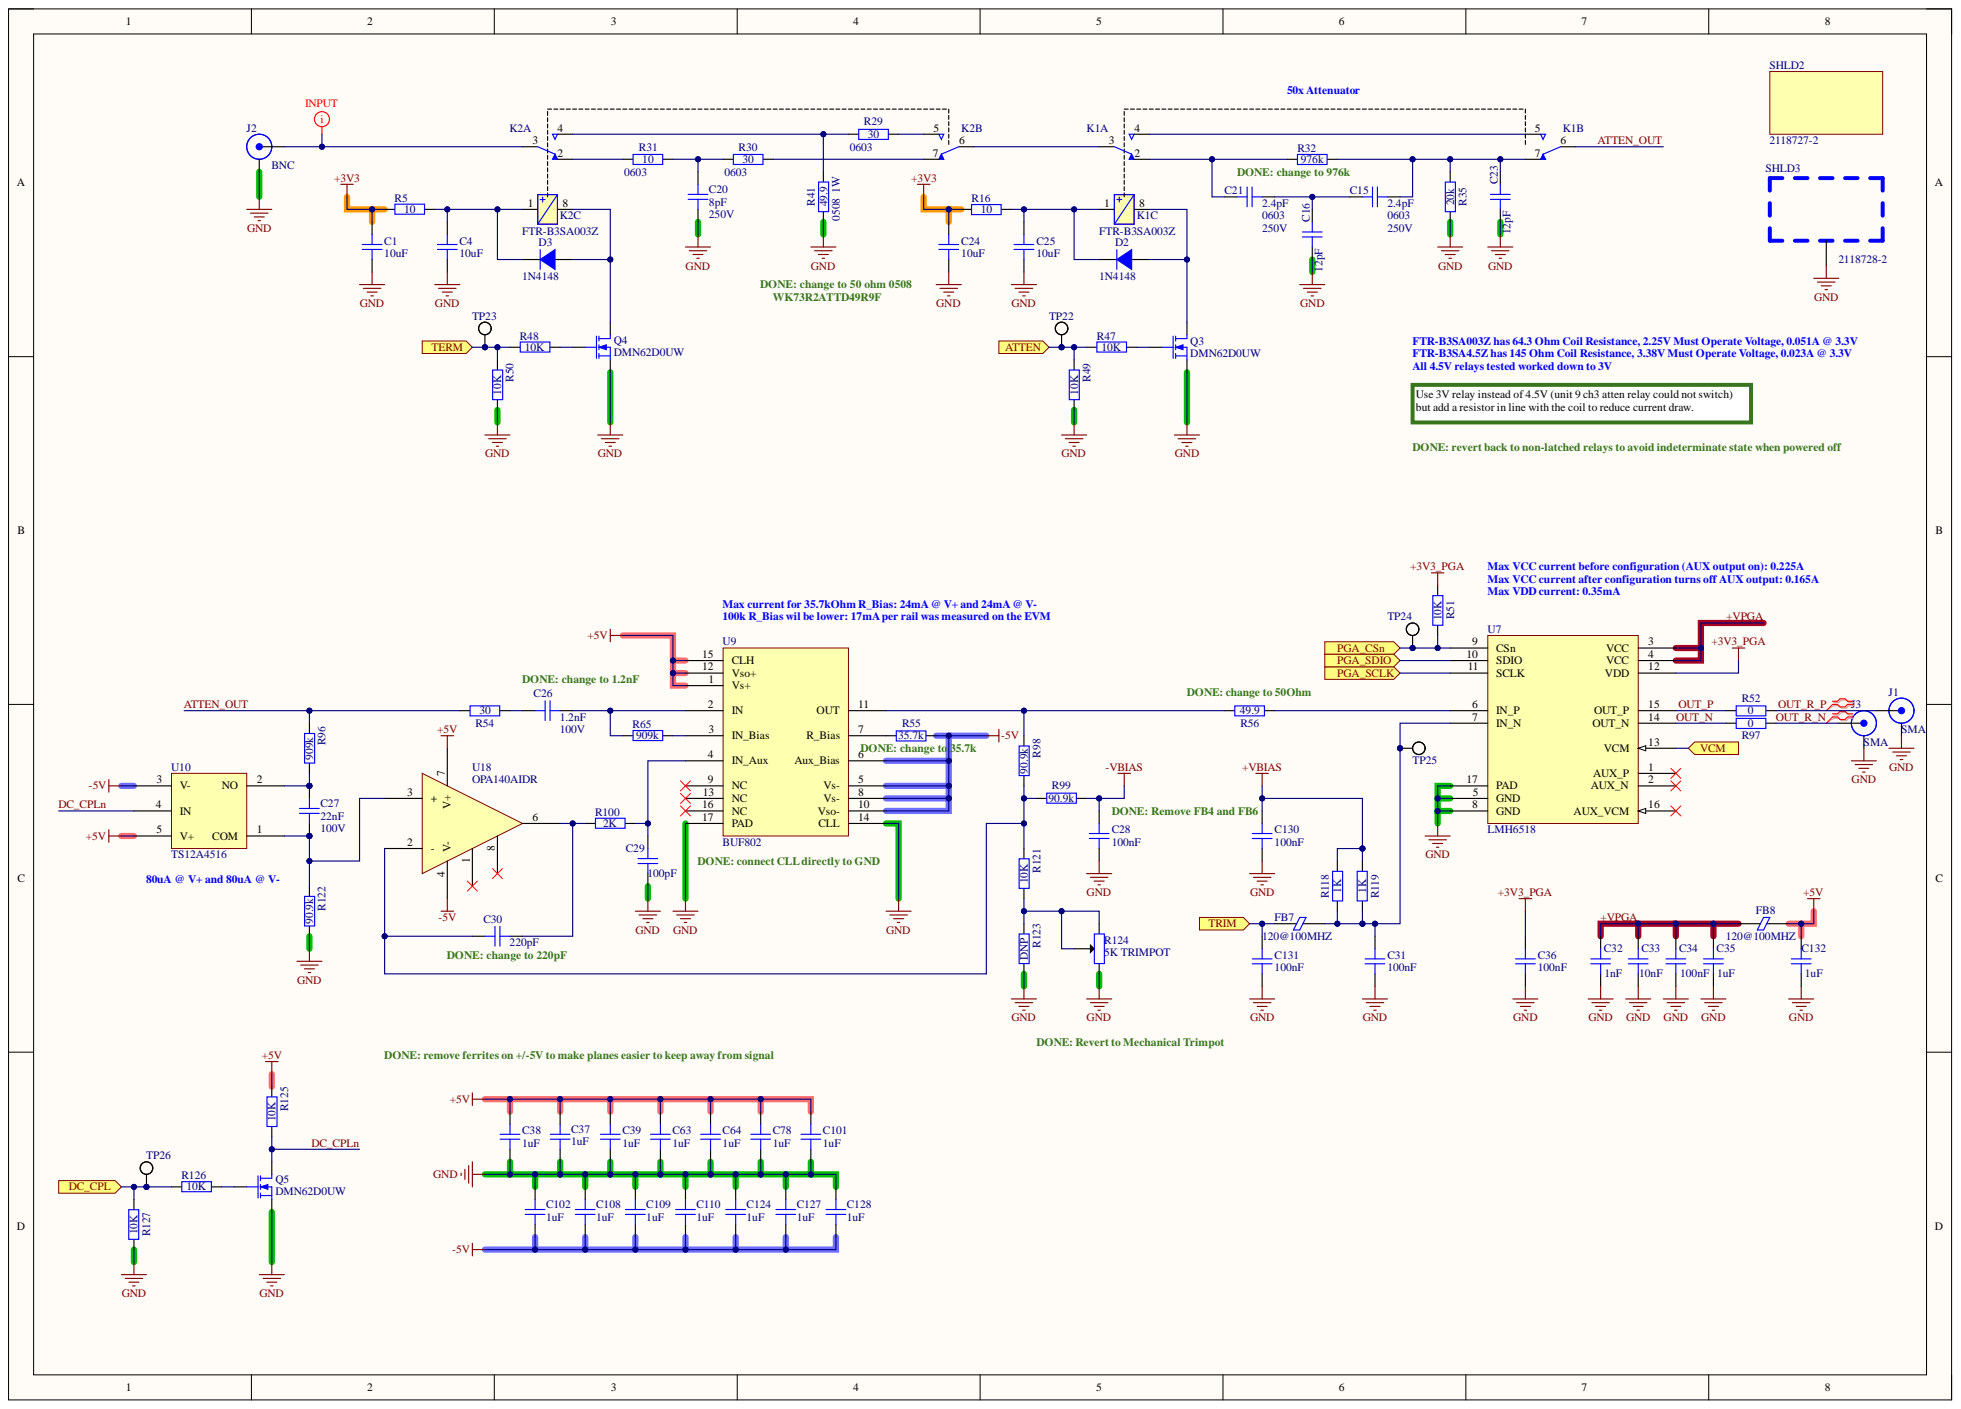
[picture p23: page 2]

DONE: change to 50 ohm 0508
WK73R2ATTD49R9F

FTR-B3SA003Z has 64.3 Ohm Coil Resistance, 2.25V Must Operate Voltage, 0.051A @ 3.3V
FTR-B3SA4.5Z has 145 Ohm Coil Resistance, 3.38V Must Operate Voltage, 0.023A @ 3.3V
All 4.5V relays tested worked down to 3V

Use 3V relay instead of 4.5V (unit 9 ch3 atten relay could not switch)
but add a resistor in line with the coil to reduce current draw.

DONE: revert back to non-latched relays to avoid indeterminate state when powered off

Max VCC current before configuration (AUX output on): 0.225A
Max VCC current after configuration turns off AUX output: 0.165A
Max VDD current: 0.35mA

Max current for 35.7kOhm R_Bias: 24mA@ V+ and 24mA@ V-
100k R_Bias wil be lower: 17mAper rail was measured on the EVM

30 | R65 | IN_Bias 3 | R55 | 49.9 | IN_N 7 | OUT_N | 0

909k | IN_Aux 4 | 35.7k

BUF802
DONE: connect CLLdirectly to GND

DONE: remove ferrites on +/-5V to make planes easier to keep away from signal

DONE: Revert to Mechanical Trimpot
