EEVengers/ts_hardware_archive/Altium/FPGA_Module_Rev2/FPGA_Module.pdf

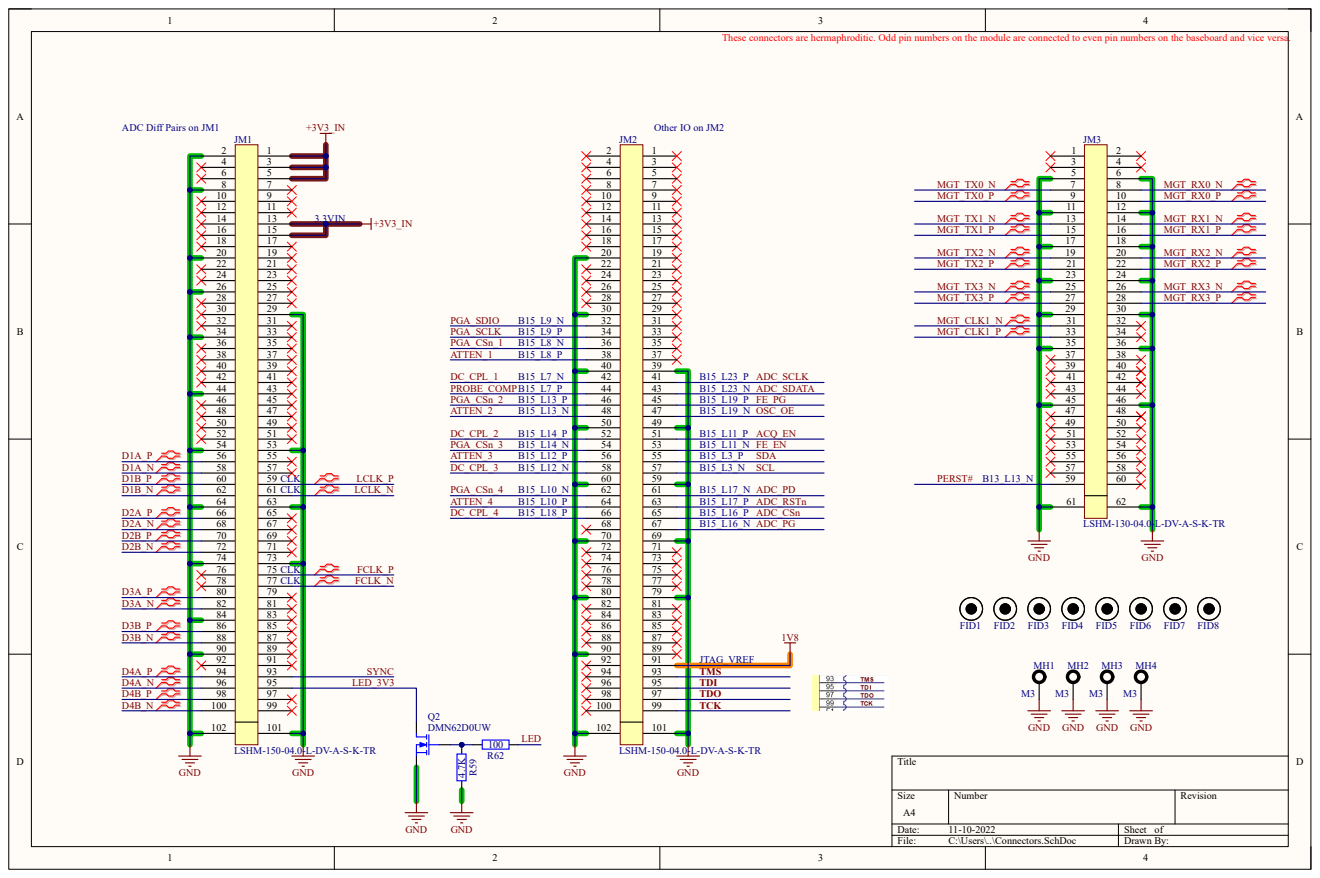
[picture p24: page 1]
Title; Size; Number; Revision; Date:; Sheet of; File:; C:\Users\..\Connectors.SchDoc; Drawn By:; GND; ADC Diff Pairs on JM1; Other IO on JM2 +3V3_IN; 3.3VIN; CLK CLK; TCK; TDO; TDI; TMS; MGT_TX0_N; MGT_TX1_N; MGT_TX2_N; MGT_TX3_N; MGT_TX0_P; MGT_TX1_P; MGT_TX2_P; MGT_TX3_P; MGT_CLK1_N MGT_CLK1_P; PGA_CSn_1; ATTEN_1; DC_CPL_1; PGA_CSn_2 ATTEN_2; DC_CPL_2 PGA_CSn_3 ATTEN_3 DC_CPL_3; PGA_CSn_4 ATTEN_4 DC_CPL_4; SYNC; MGT_RX0_N MGT_RX0_P; MGT_RX1_N MGT_RX1_P; MGT_RX2_N MGT_RX2_P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

These connectors are hermaphroditic. Odd pin numbers on the module are connected to even pin numbers on the baseboard and vice versa.

LSHM-130-04.0-L-DV-A-S-K-TR

GND GND

LSHM-150-04.0-L-DV-A-S-K-TR

# IO_25_34 R6 BANK ³⁴

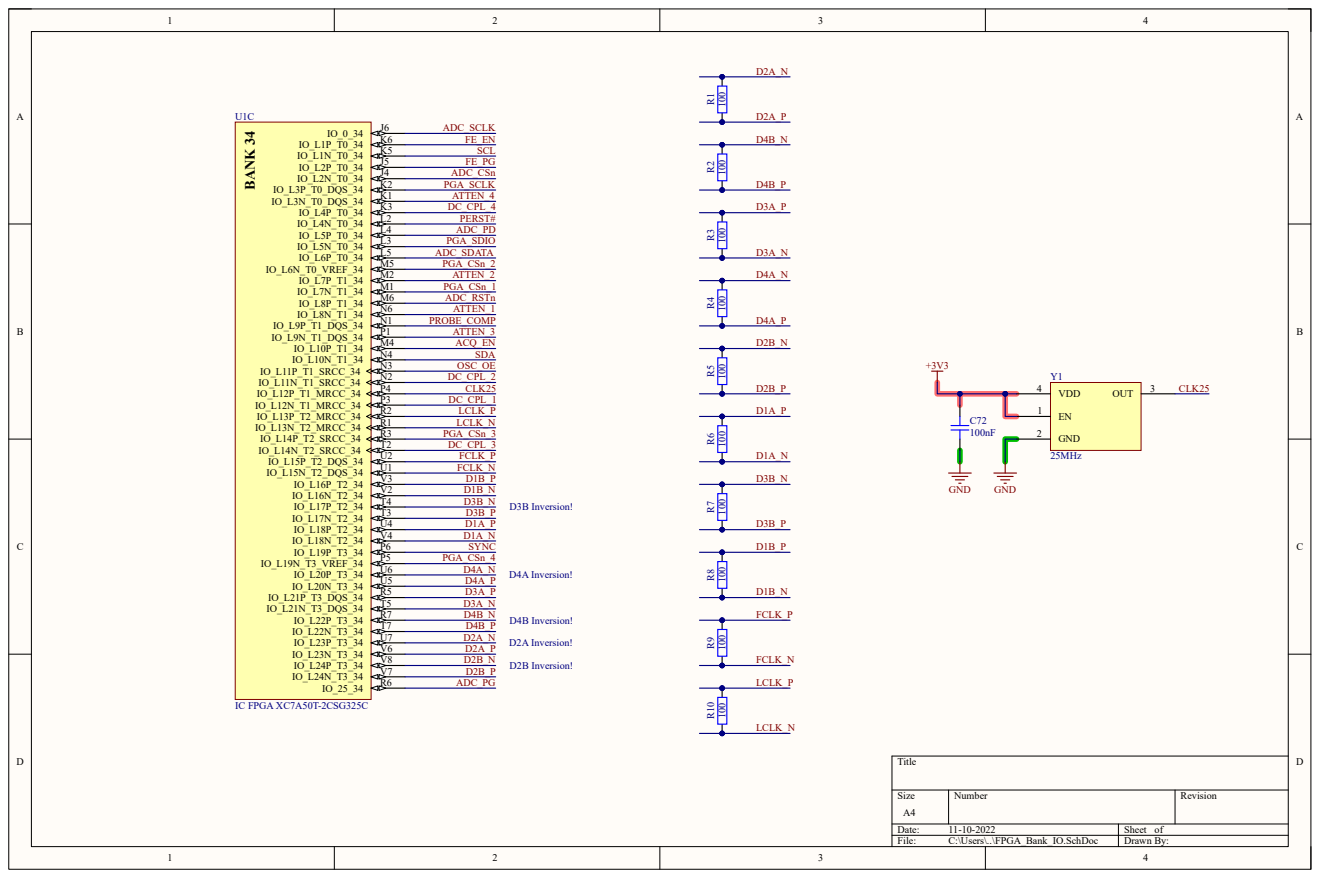
[picture p25: page 2]

IO_25_14 | U10 BANK ¹⁴
IO_25_15 | H14 BANK ¹⁵

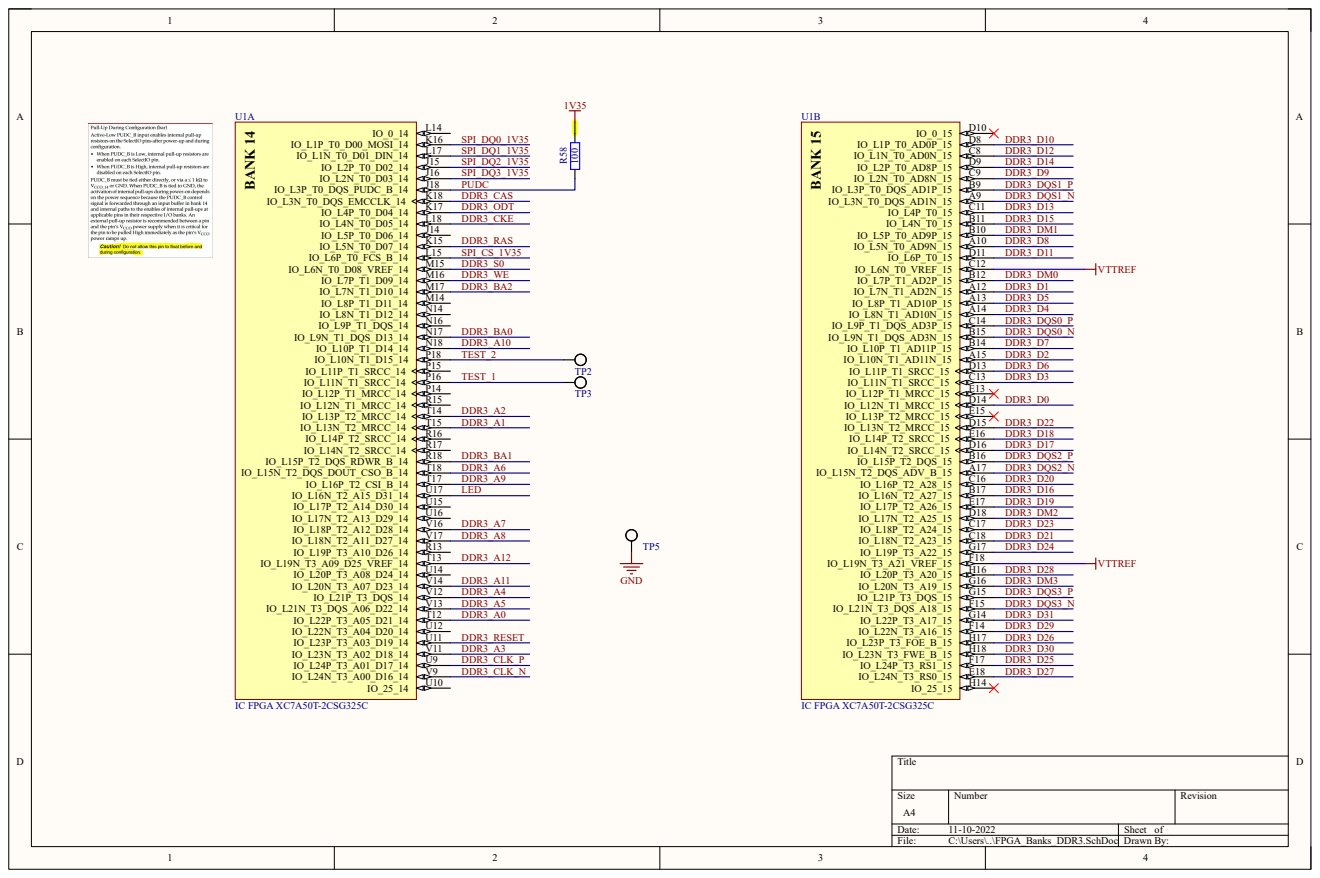
[picture p26: page 3]

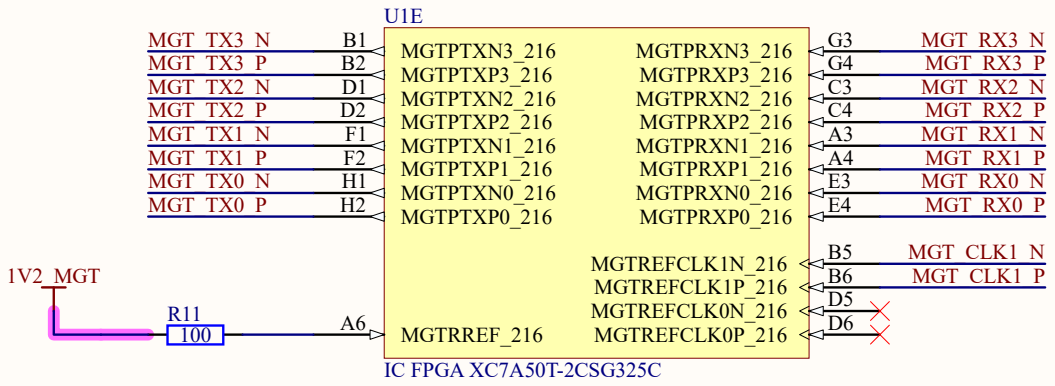
[picture p27: page 4]

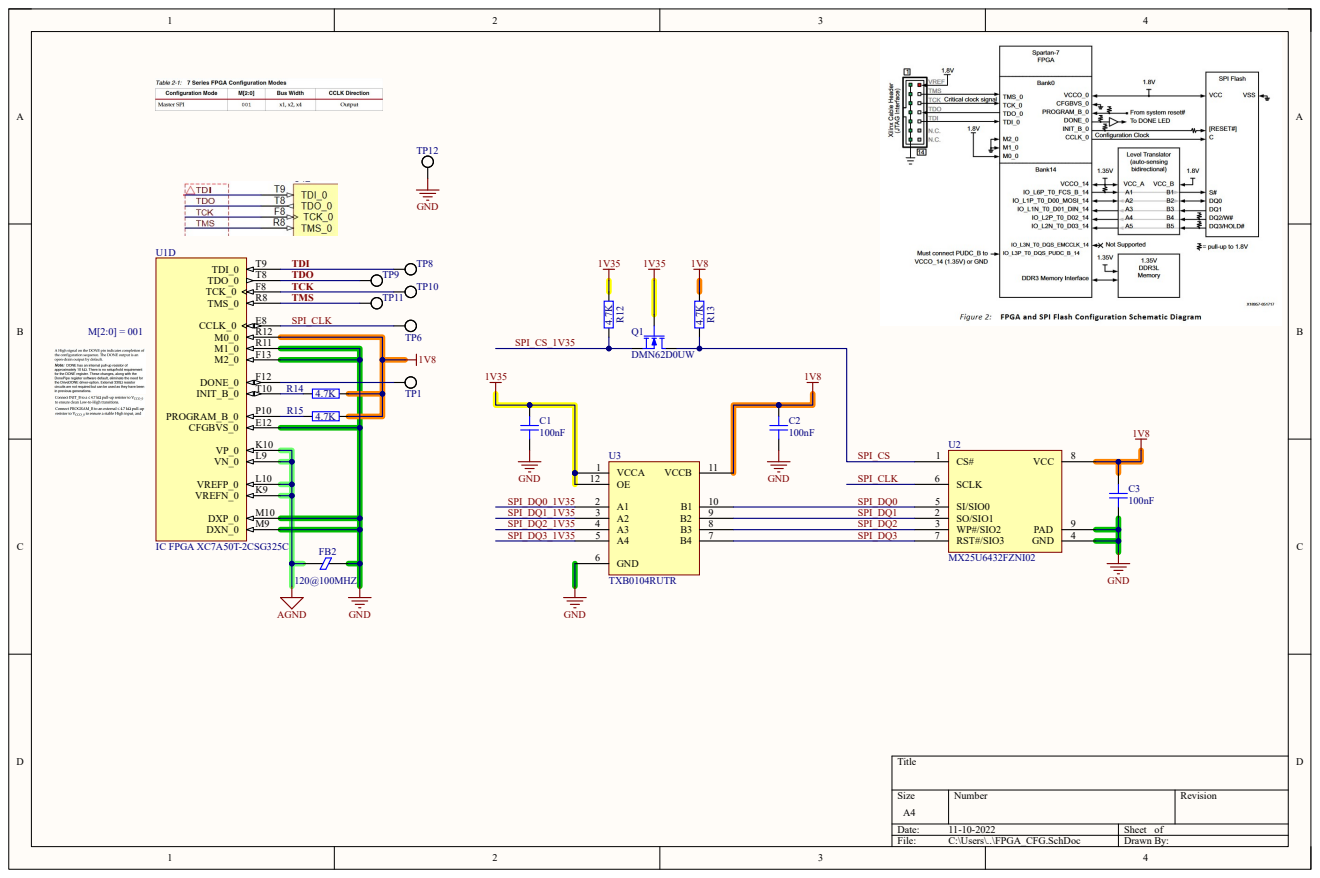
[picture p28: page 5]

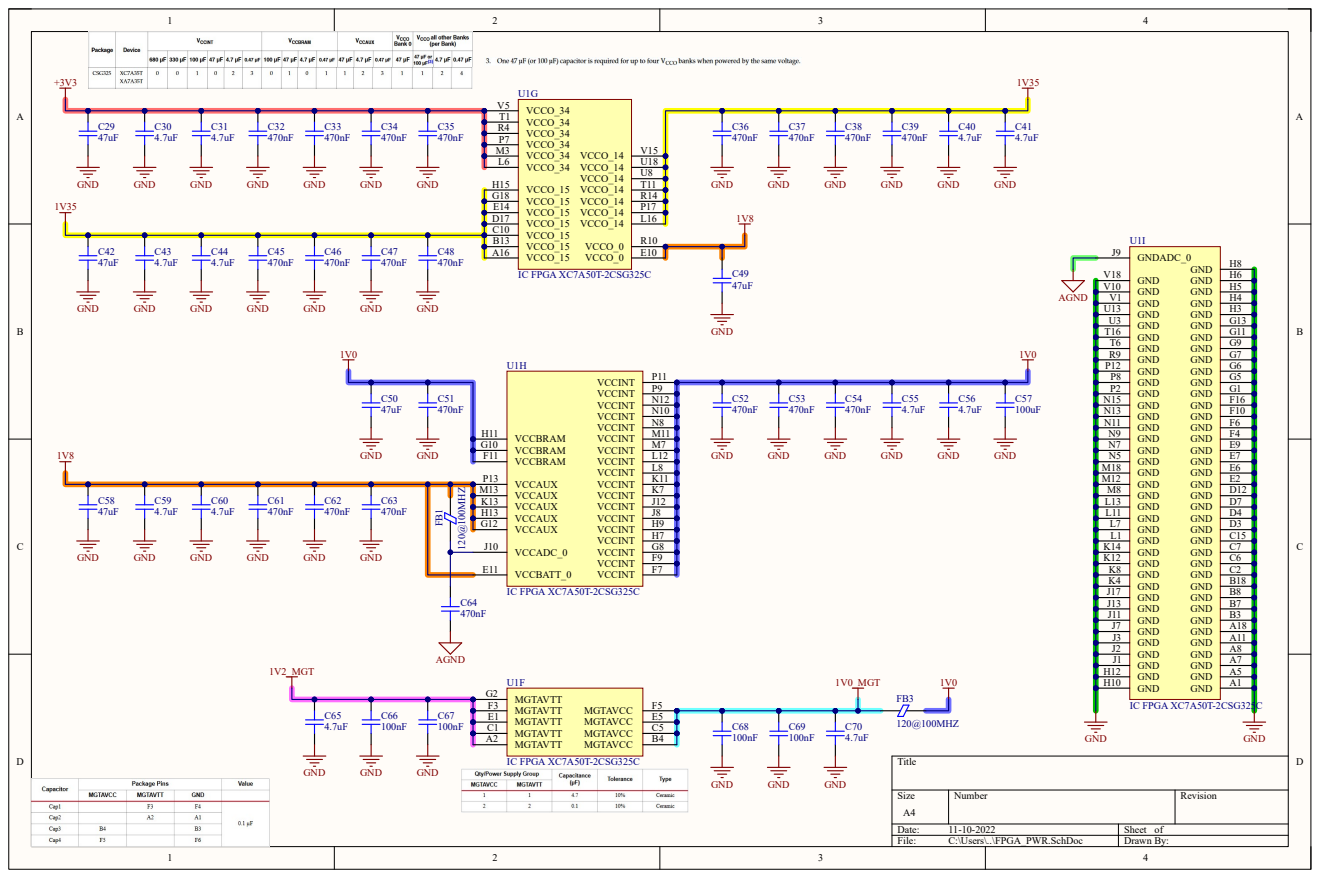
[picture p29: page 6]

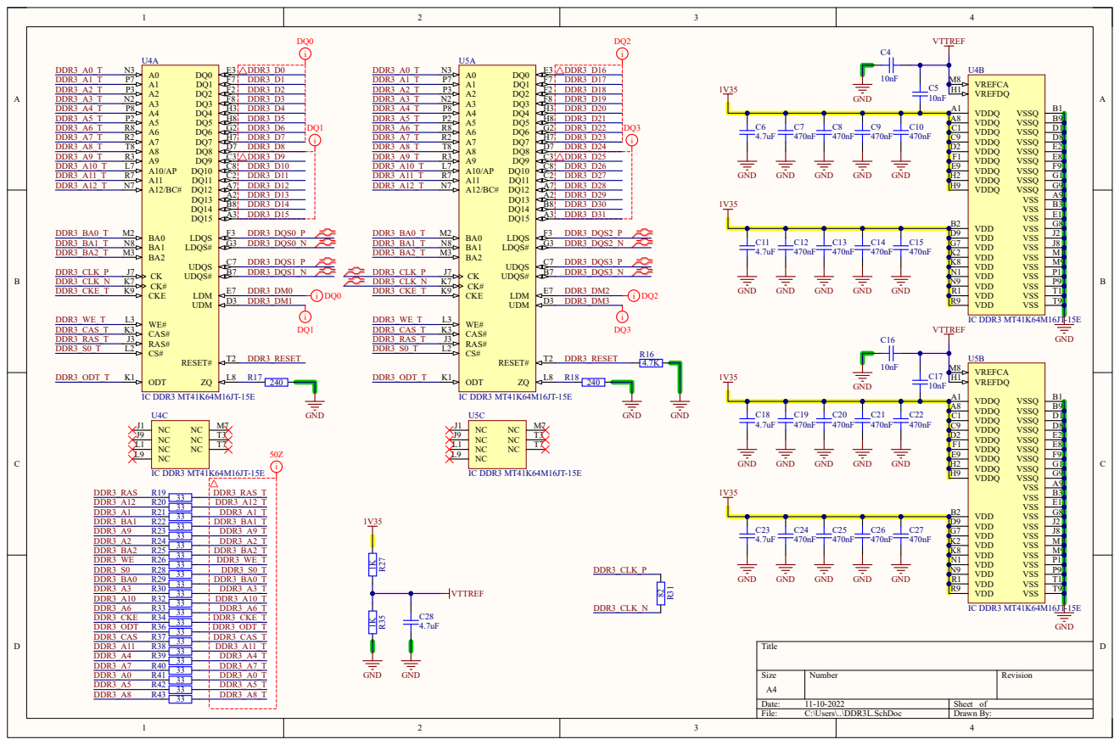
[picture p30: page 7]

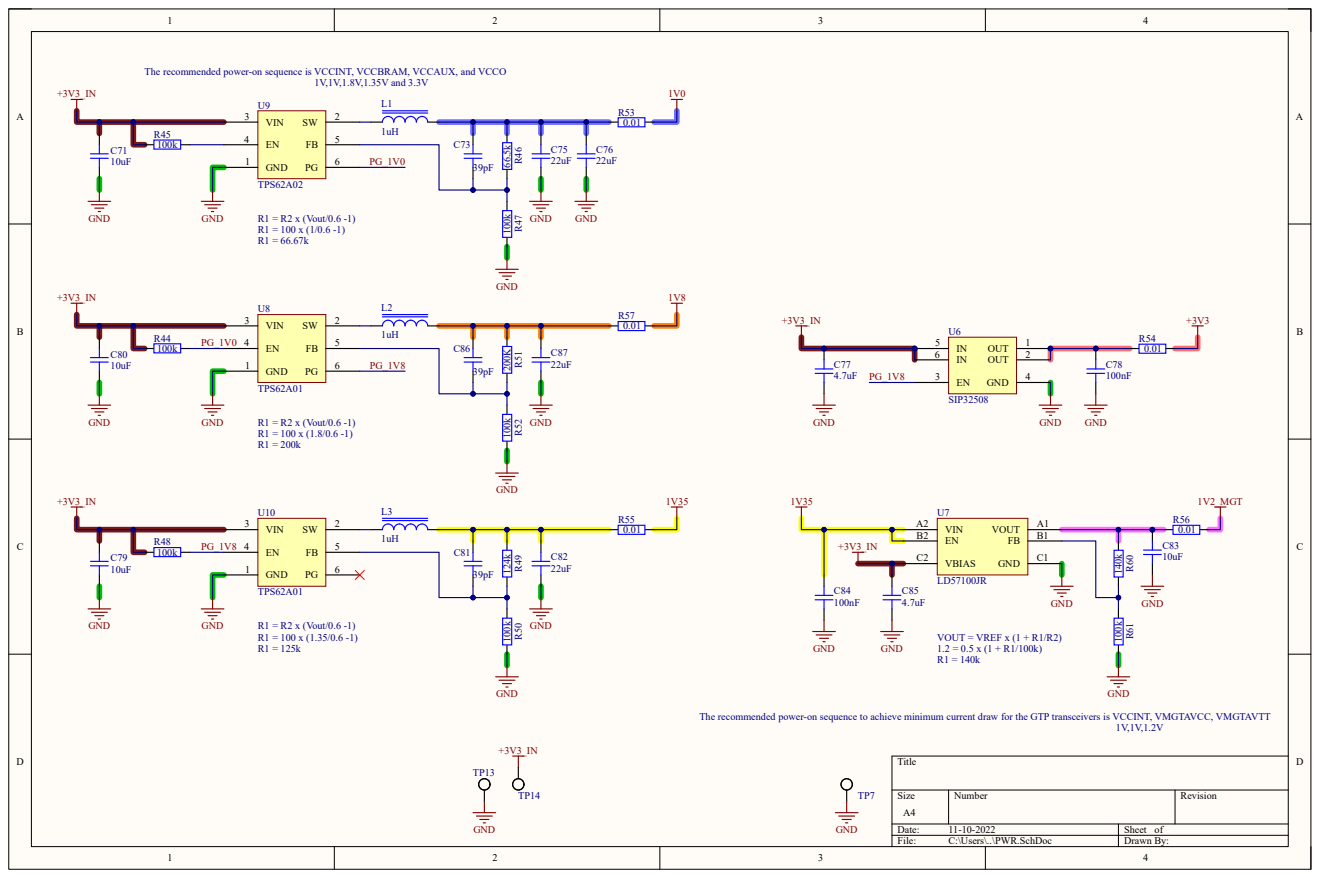
[picture p31: page 8]

The recommended power-on sequence is VCCINT, VCCBRAM, VCCAUX, and VCCO

The recommended power-on sequence to achieve minimum current draw for the GTP transceivers is VCCINT, VMGTAVCC, VMGTAVTT
