EEVengers/ts_hardware_archive/Altium/Thunderscope_E/Thunderscope-E.pdf

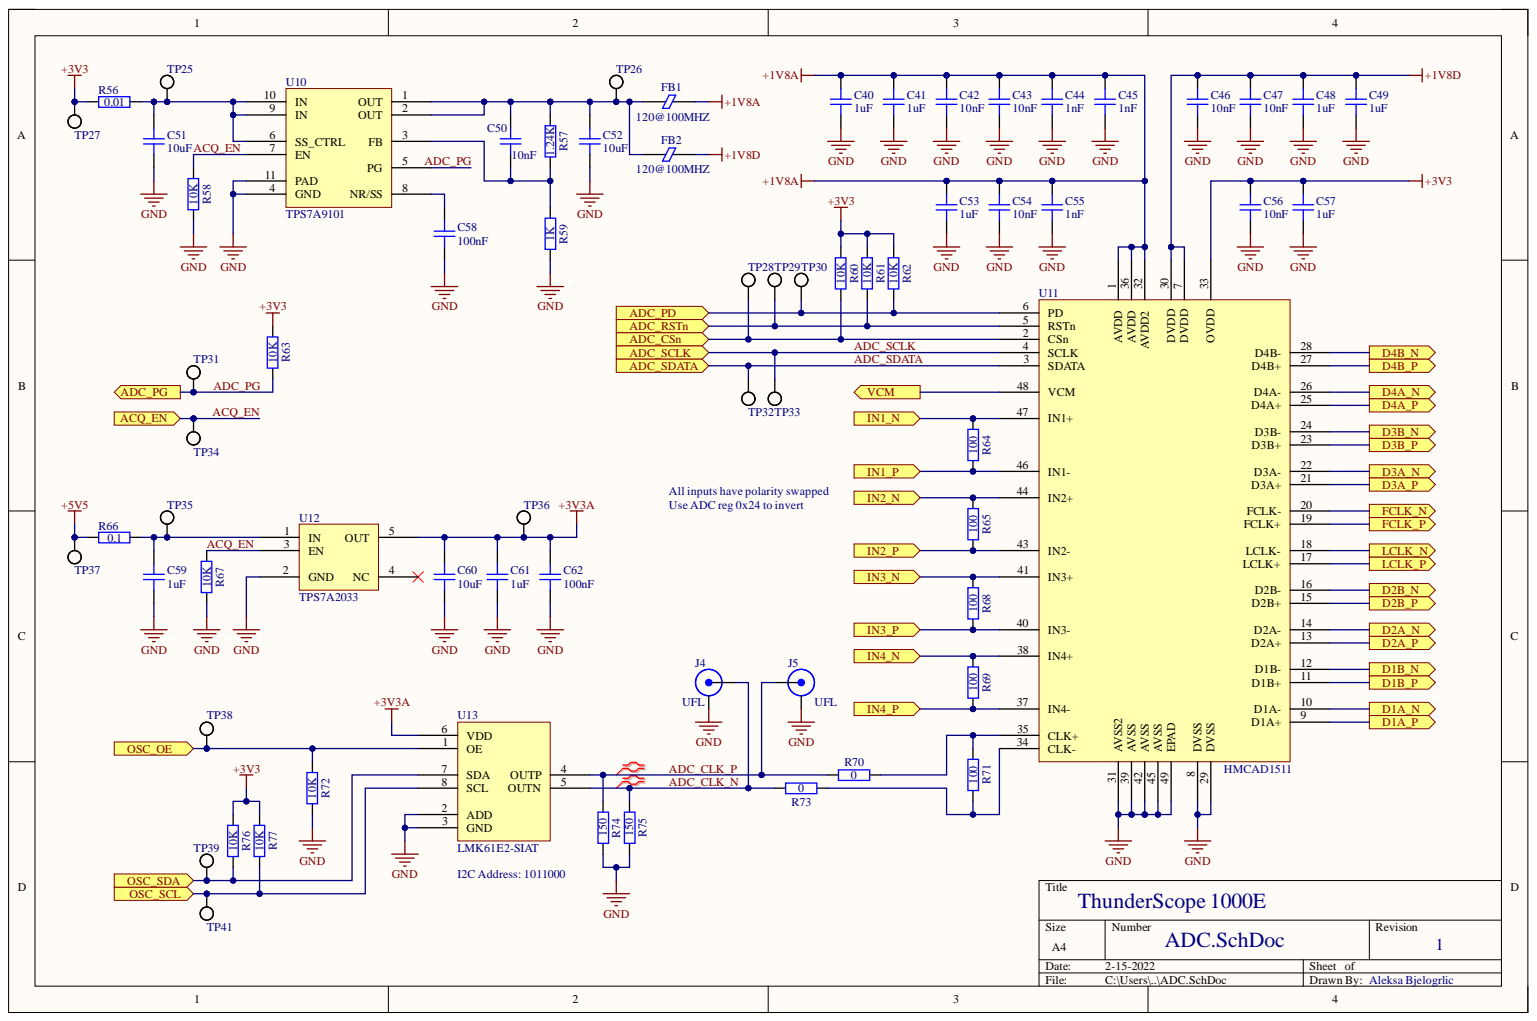
[picture p32: page 1]

8 | 5 | A DC_CL K_N

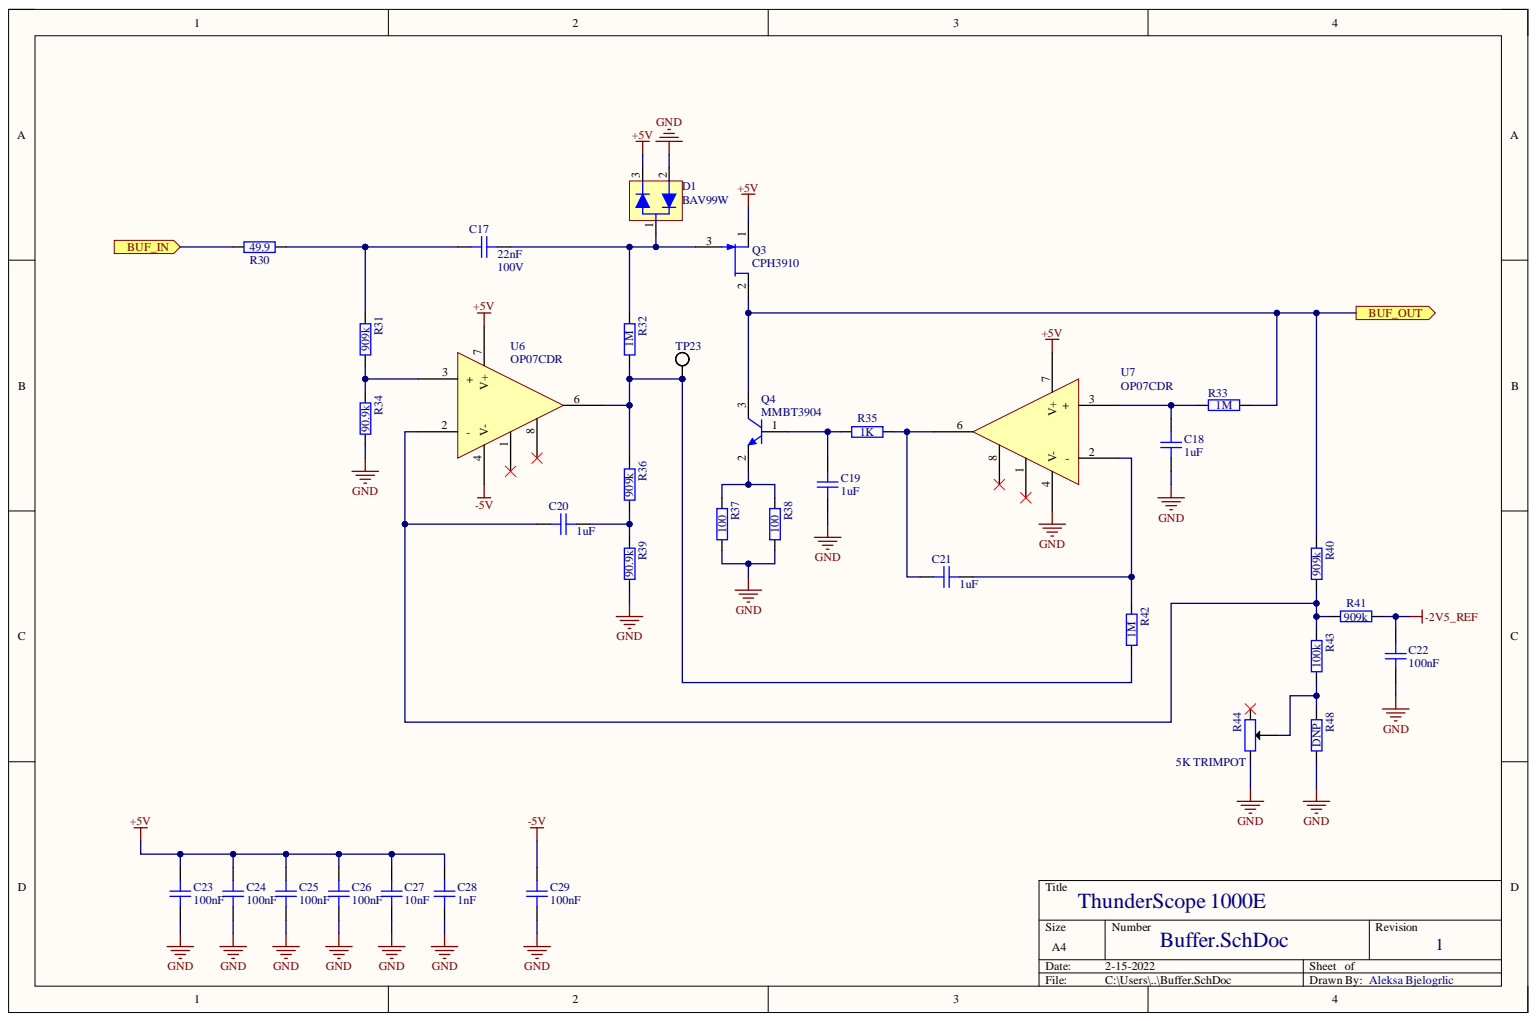
[picture p33: page 2]

GND

GND C21

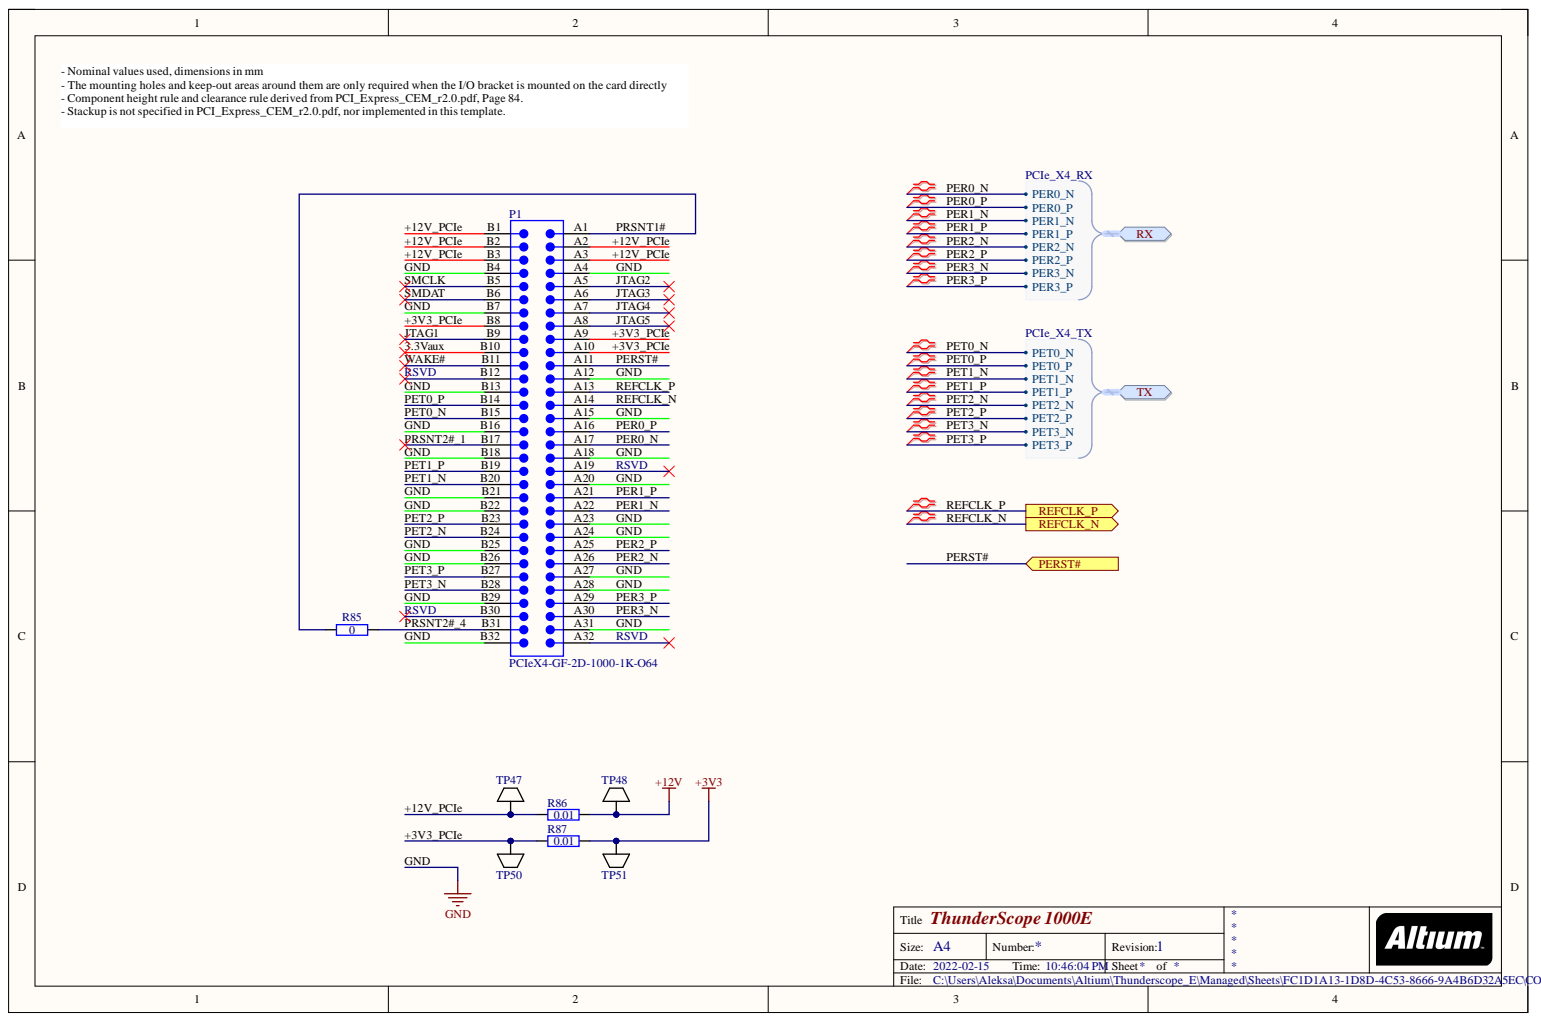
[picture p34: page 3]

- Nominal values used, dimensions in mm
- The mounting holes and keep-out areas around them are only required when the I/O bracket is mounted on the card directly
- Component height rule and clearance rule derived from PCI_Express_CEM_r2.0.pdf, Page 84.
- Stackup is not specified in PCI_Express_CEM_r2.0.pdf, nor implemented in this template.

C:\Users\Aleksa\Documents\Altium\Thunderscope_E\Managed\Sheets\FC1D1A13-1D8D-4C53-8666-9A4B6D32A5EC\CON_PCIe_X4.SchDoc

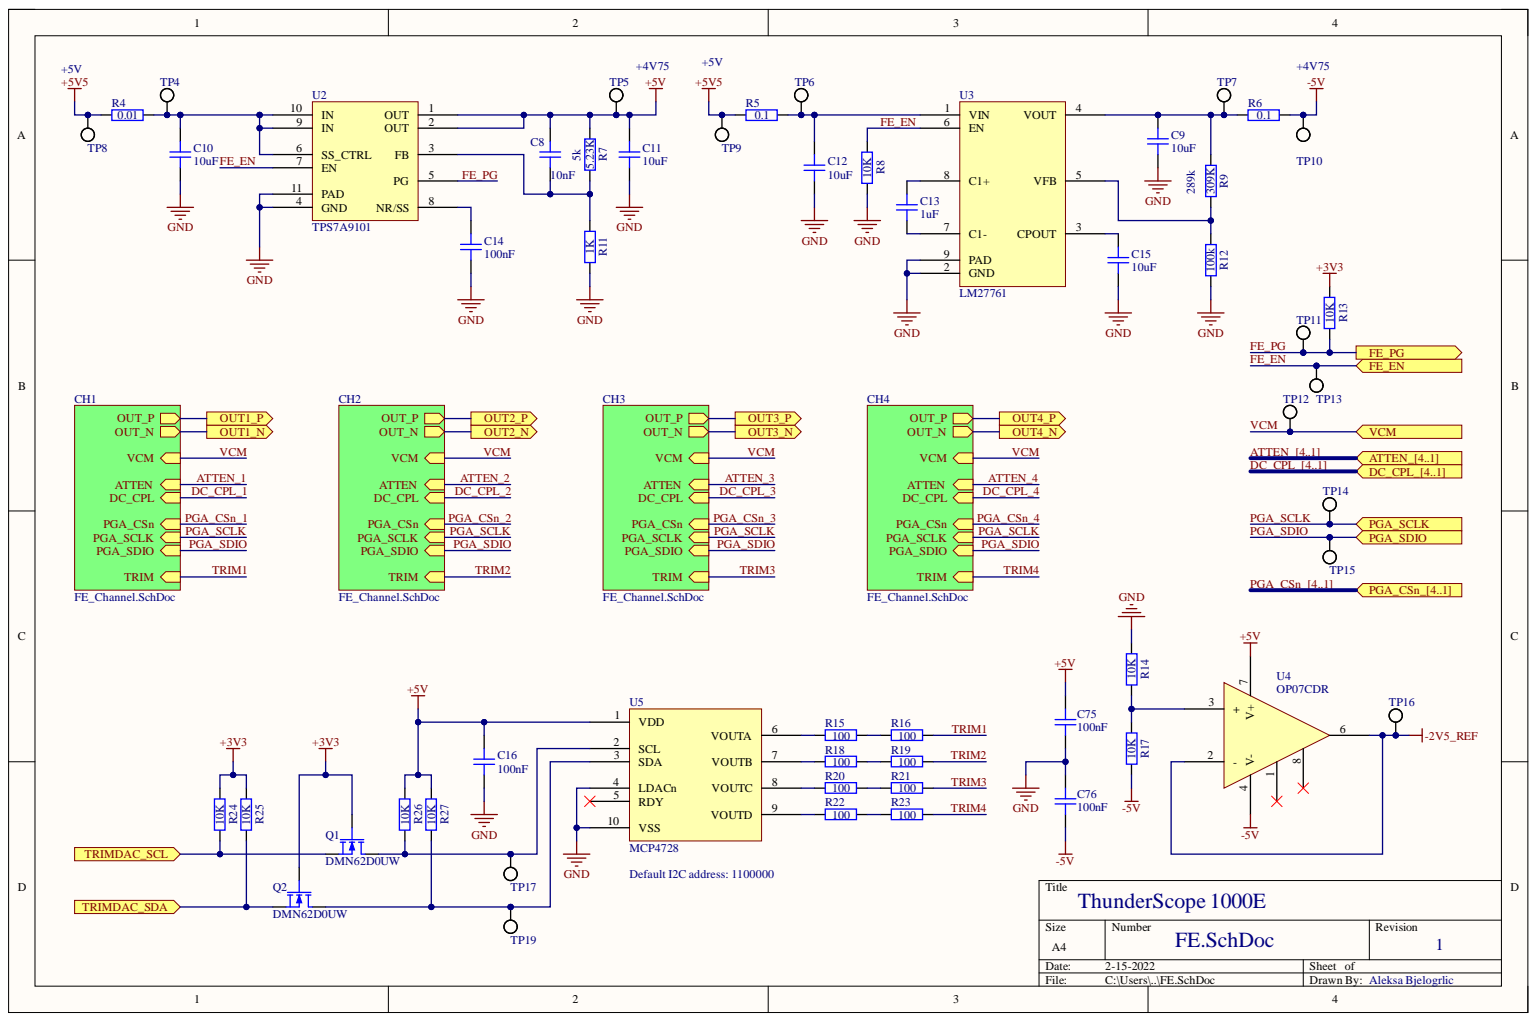
[picture p35: page 4]

SDA 3

RDY 5

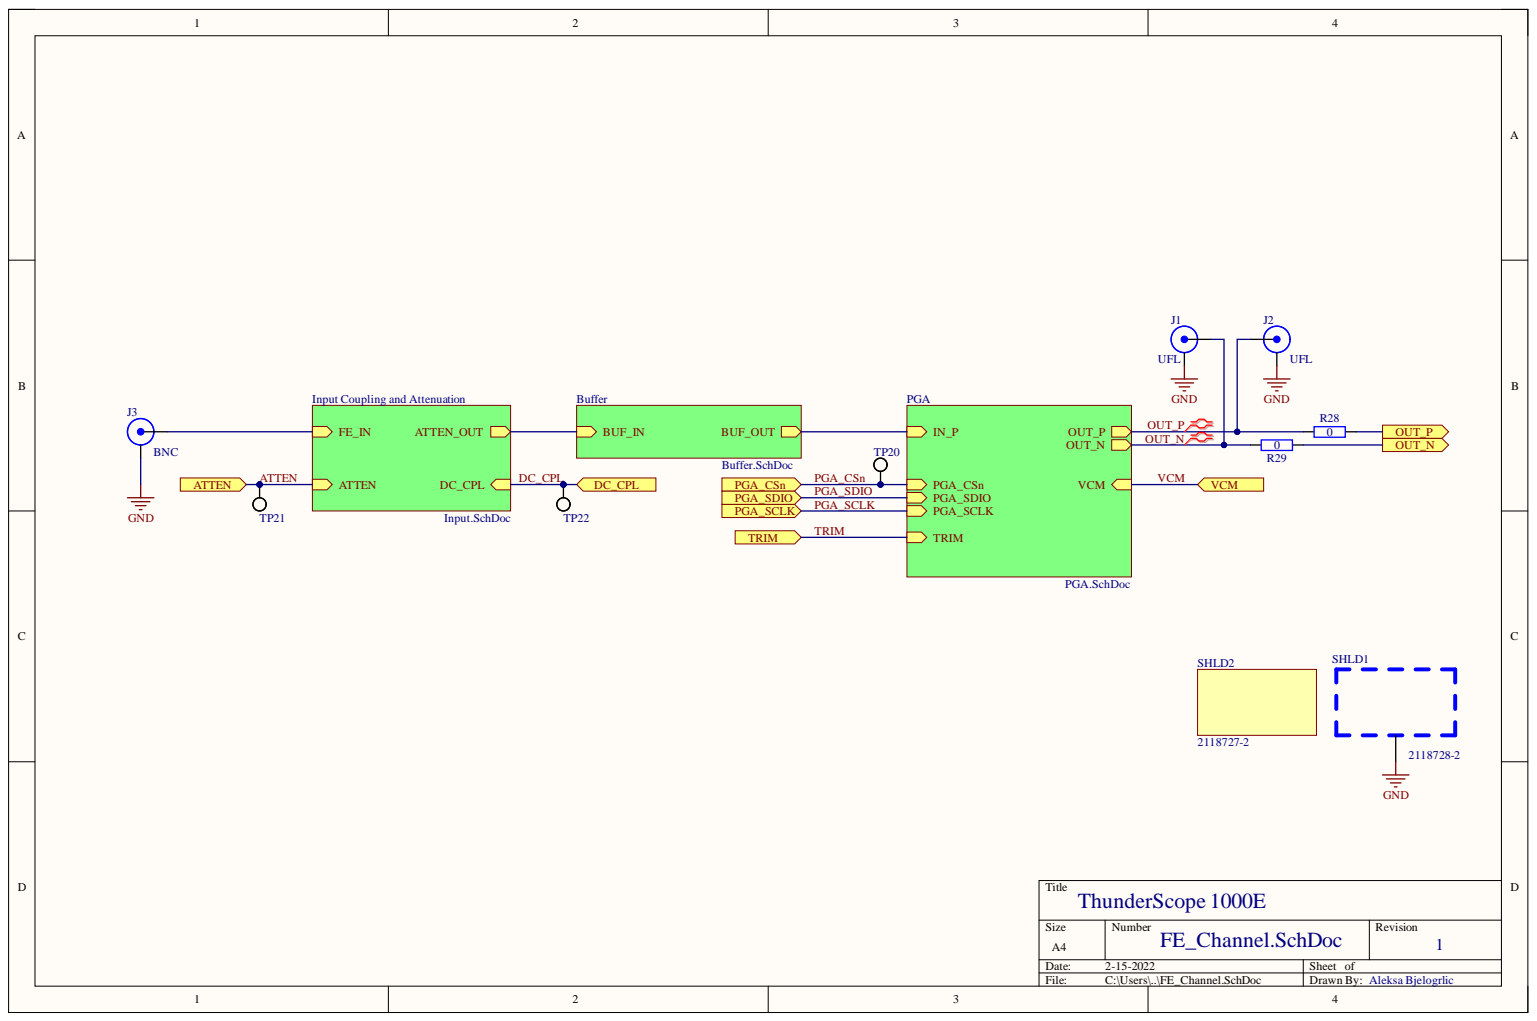
[picture p36: page 5]

Input Coupling and Attenuation

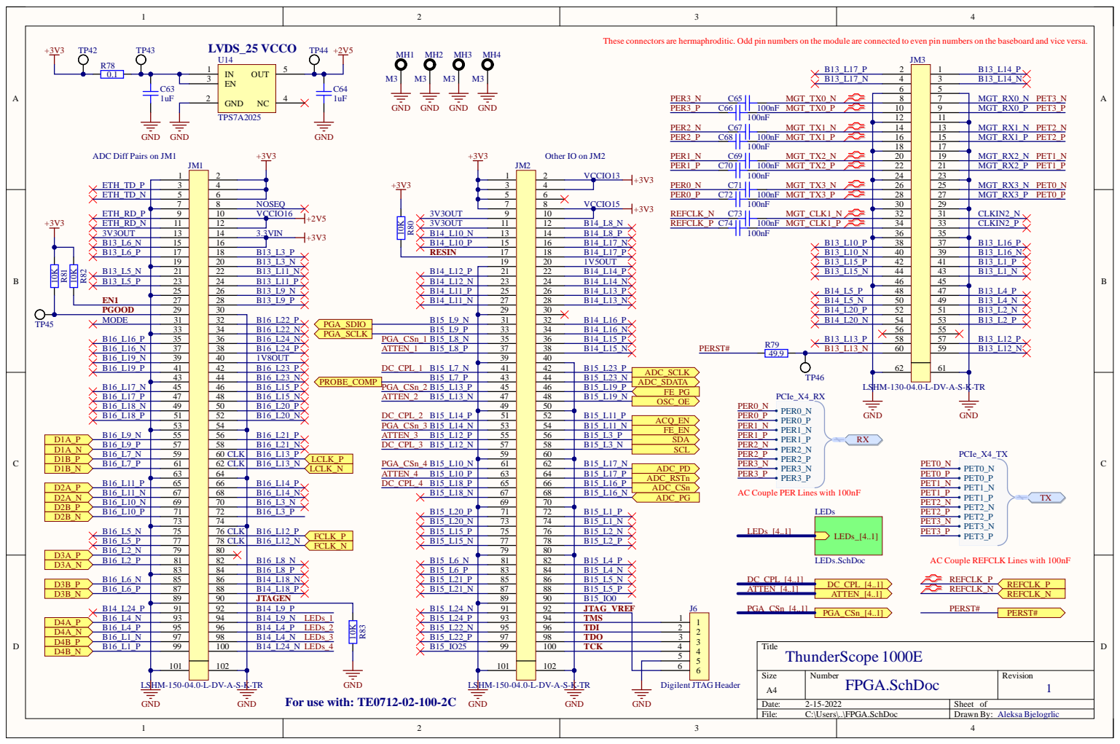
[picture p37: page 6]
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

MGT_TX0_P | 10

12
14 | | 13 15 17

MGT_TX1_P | 16

18
20 | | 19 21 23

MGT_TX2_P | 22

AC Couple PER Lines with 100nF

AC Couple REFCLK Lines with 100nF

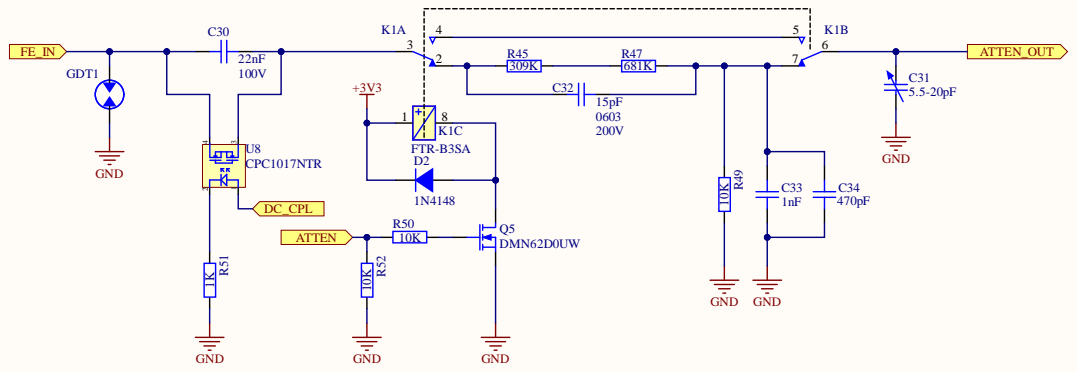
[picture p38: page 7]

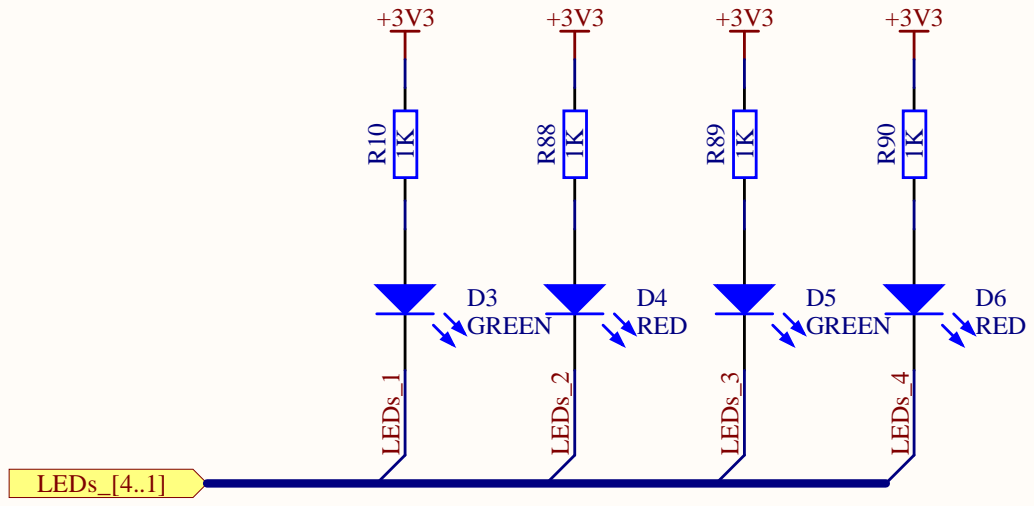
[picture p39: page 8]

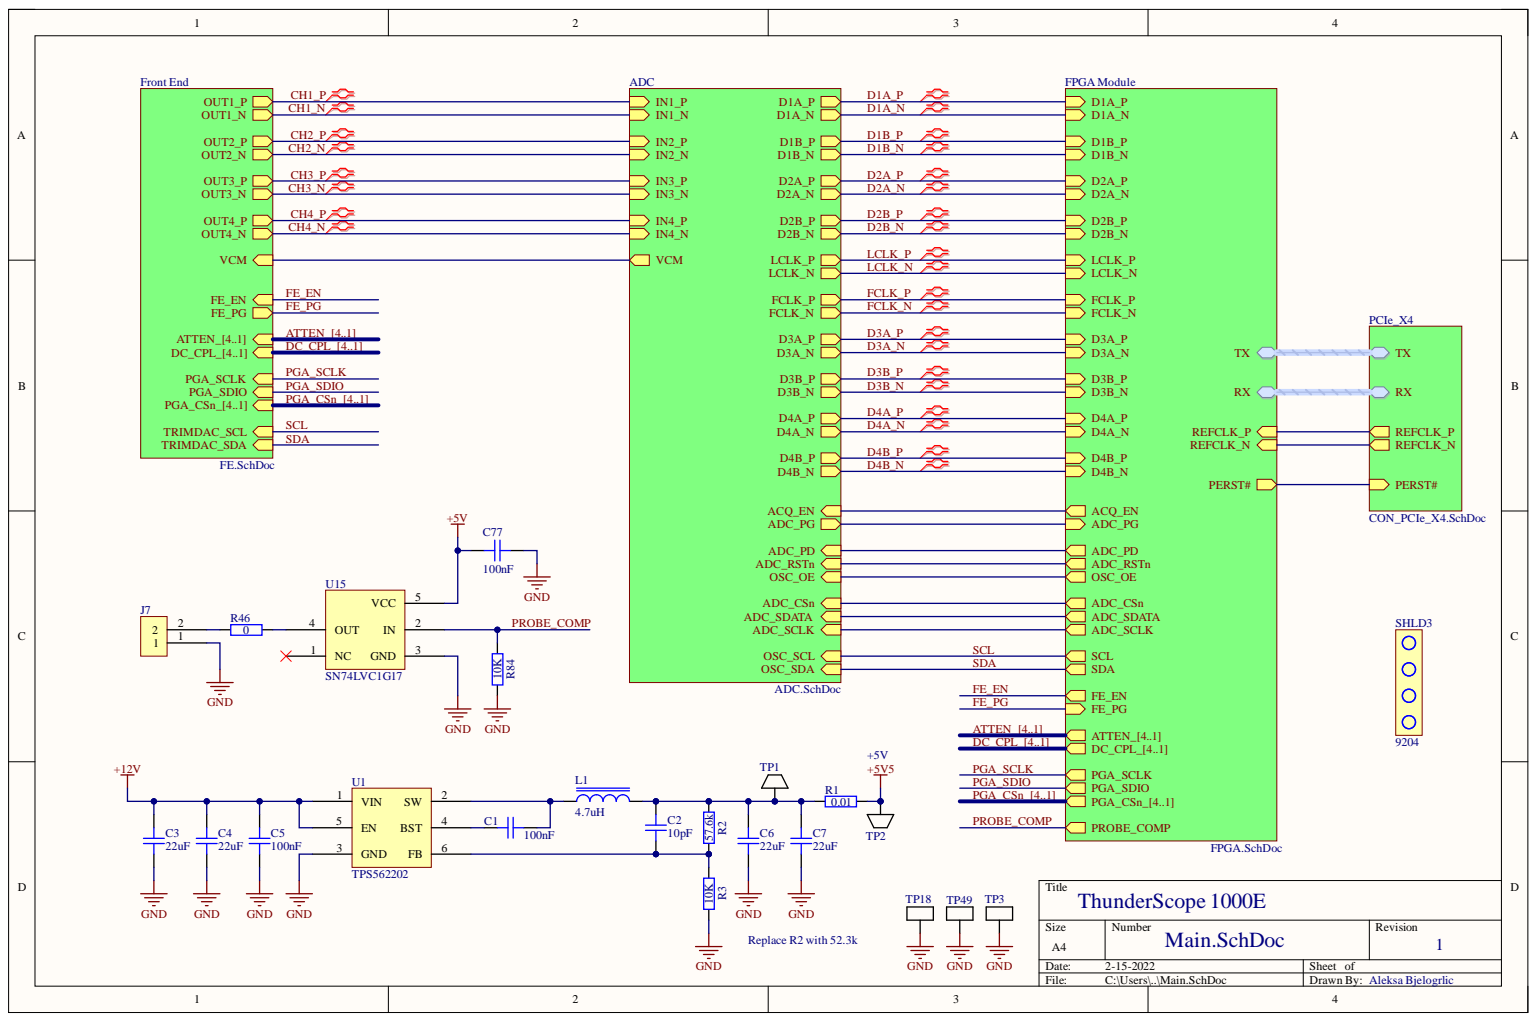
[picture p40: page 9]

CH 2 _P | D 1B_ P
CH 2 _N | D 1 B _N

CH 3 _P | D 2 A_P
CH 3 _N | D 2 A_N

CH 4 _P | D 2B_ P
CH 4 _N | D 2 B _N

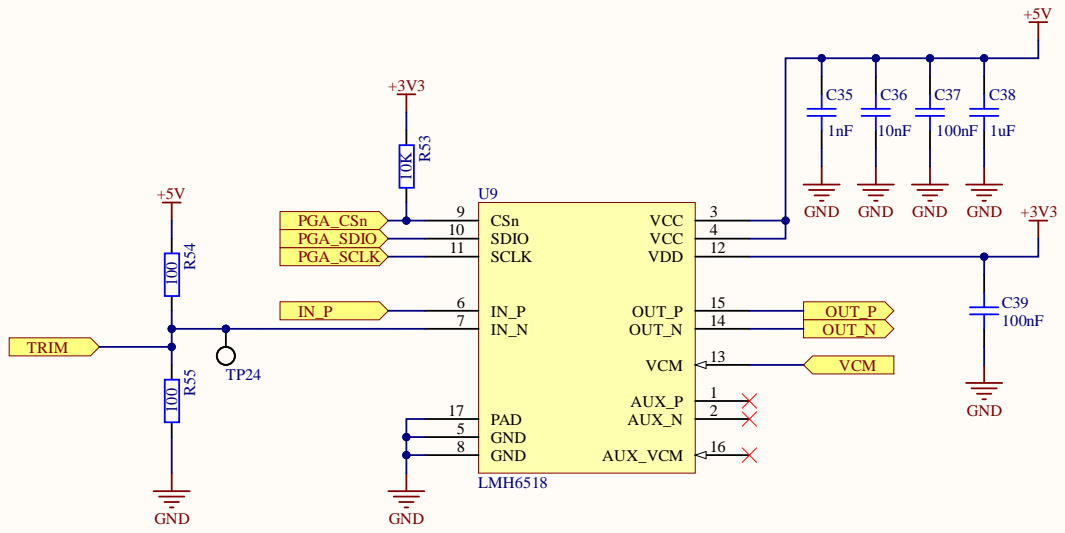
[picture p41: page 10]
