EEVengers/ts_hardware_archive/Altium/Thunderscope_Rev5/Thunderscope_Rev5.pdf

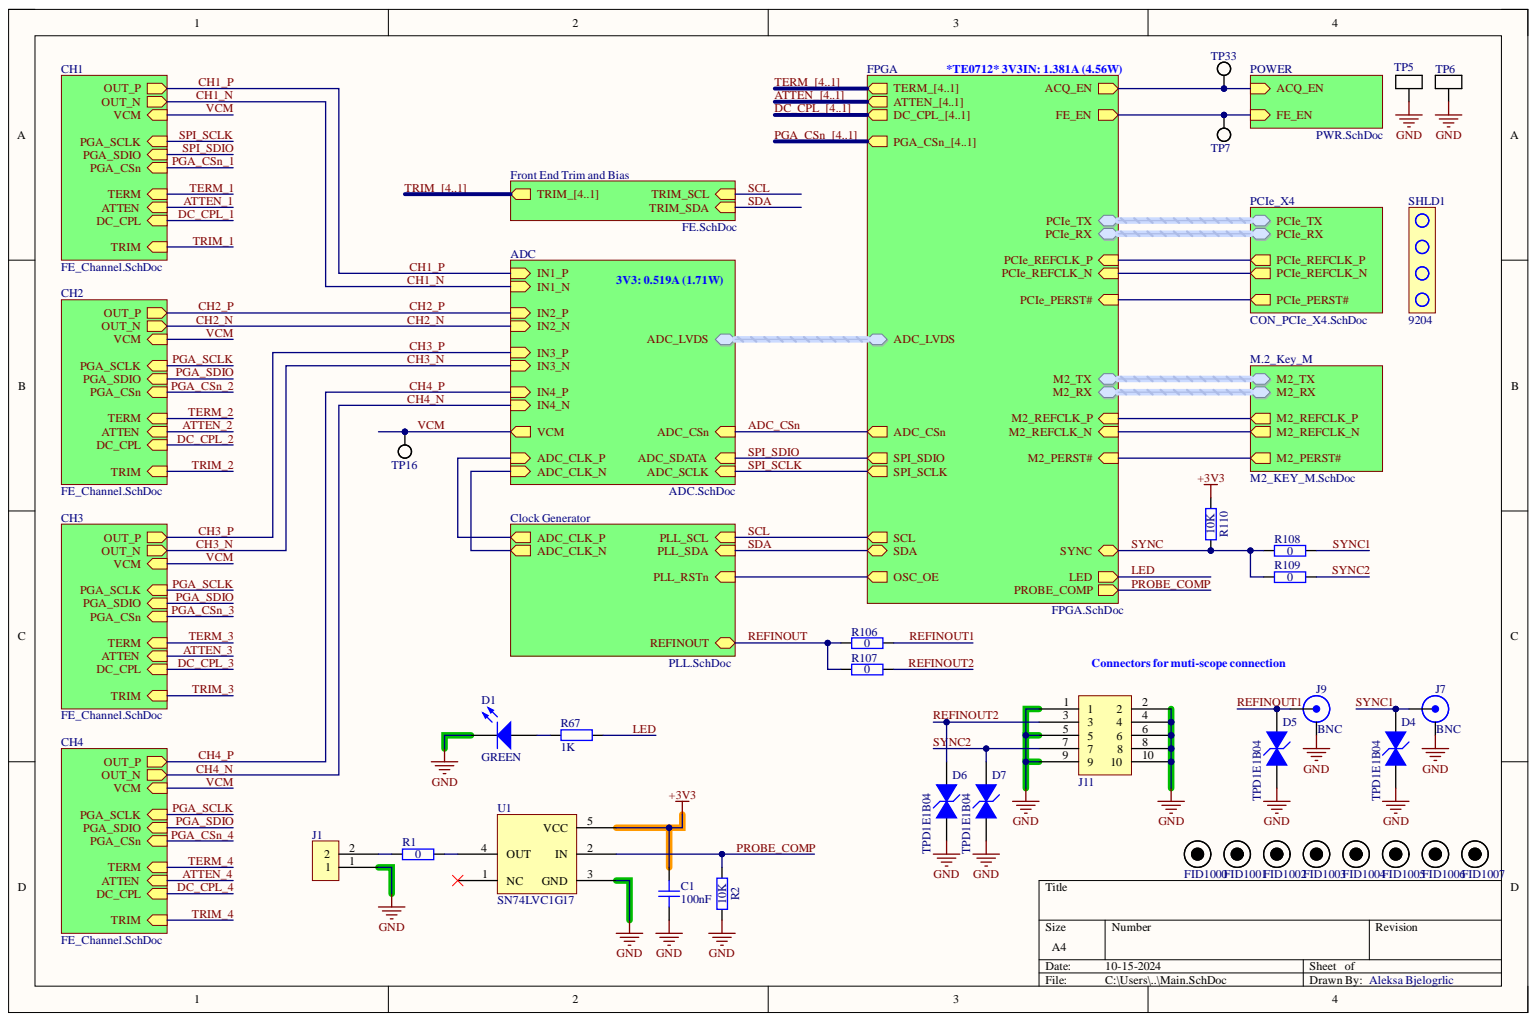
[picture p42: page 1]

Front End Trim and Bias
TRIM_[4..1]

CH3_N | SDA
VCM PGA_SCLK PGA_SDIO PGA_CSn_3 TERM_3 ATTEN_3 DC_CPL_3 TRIM_3 D1 | | LED

Connectors for muti-scope connection

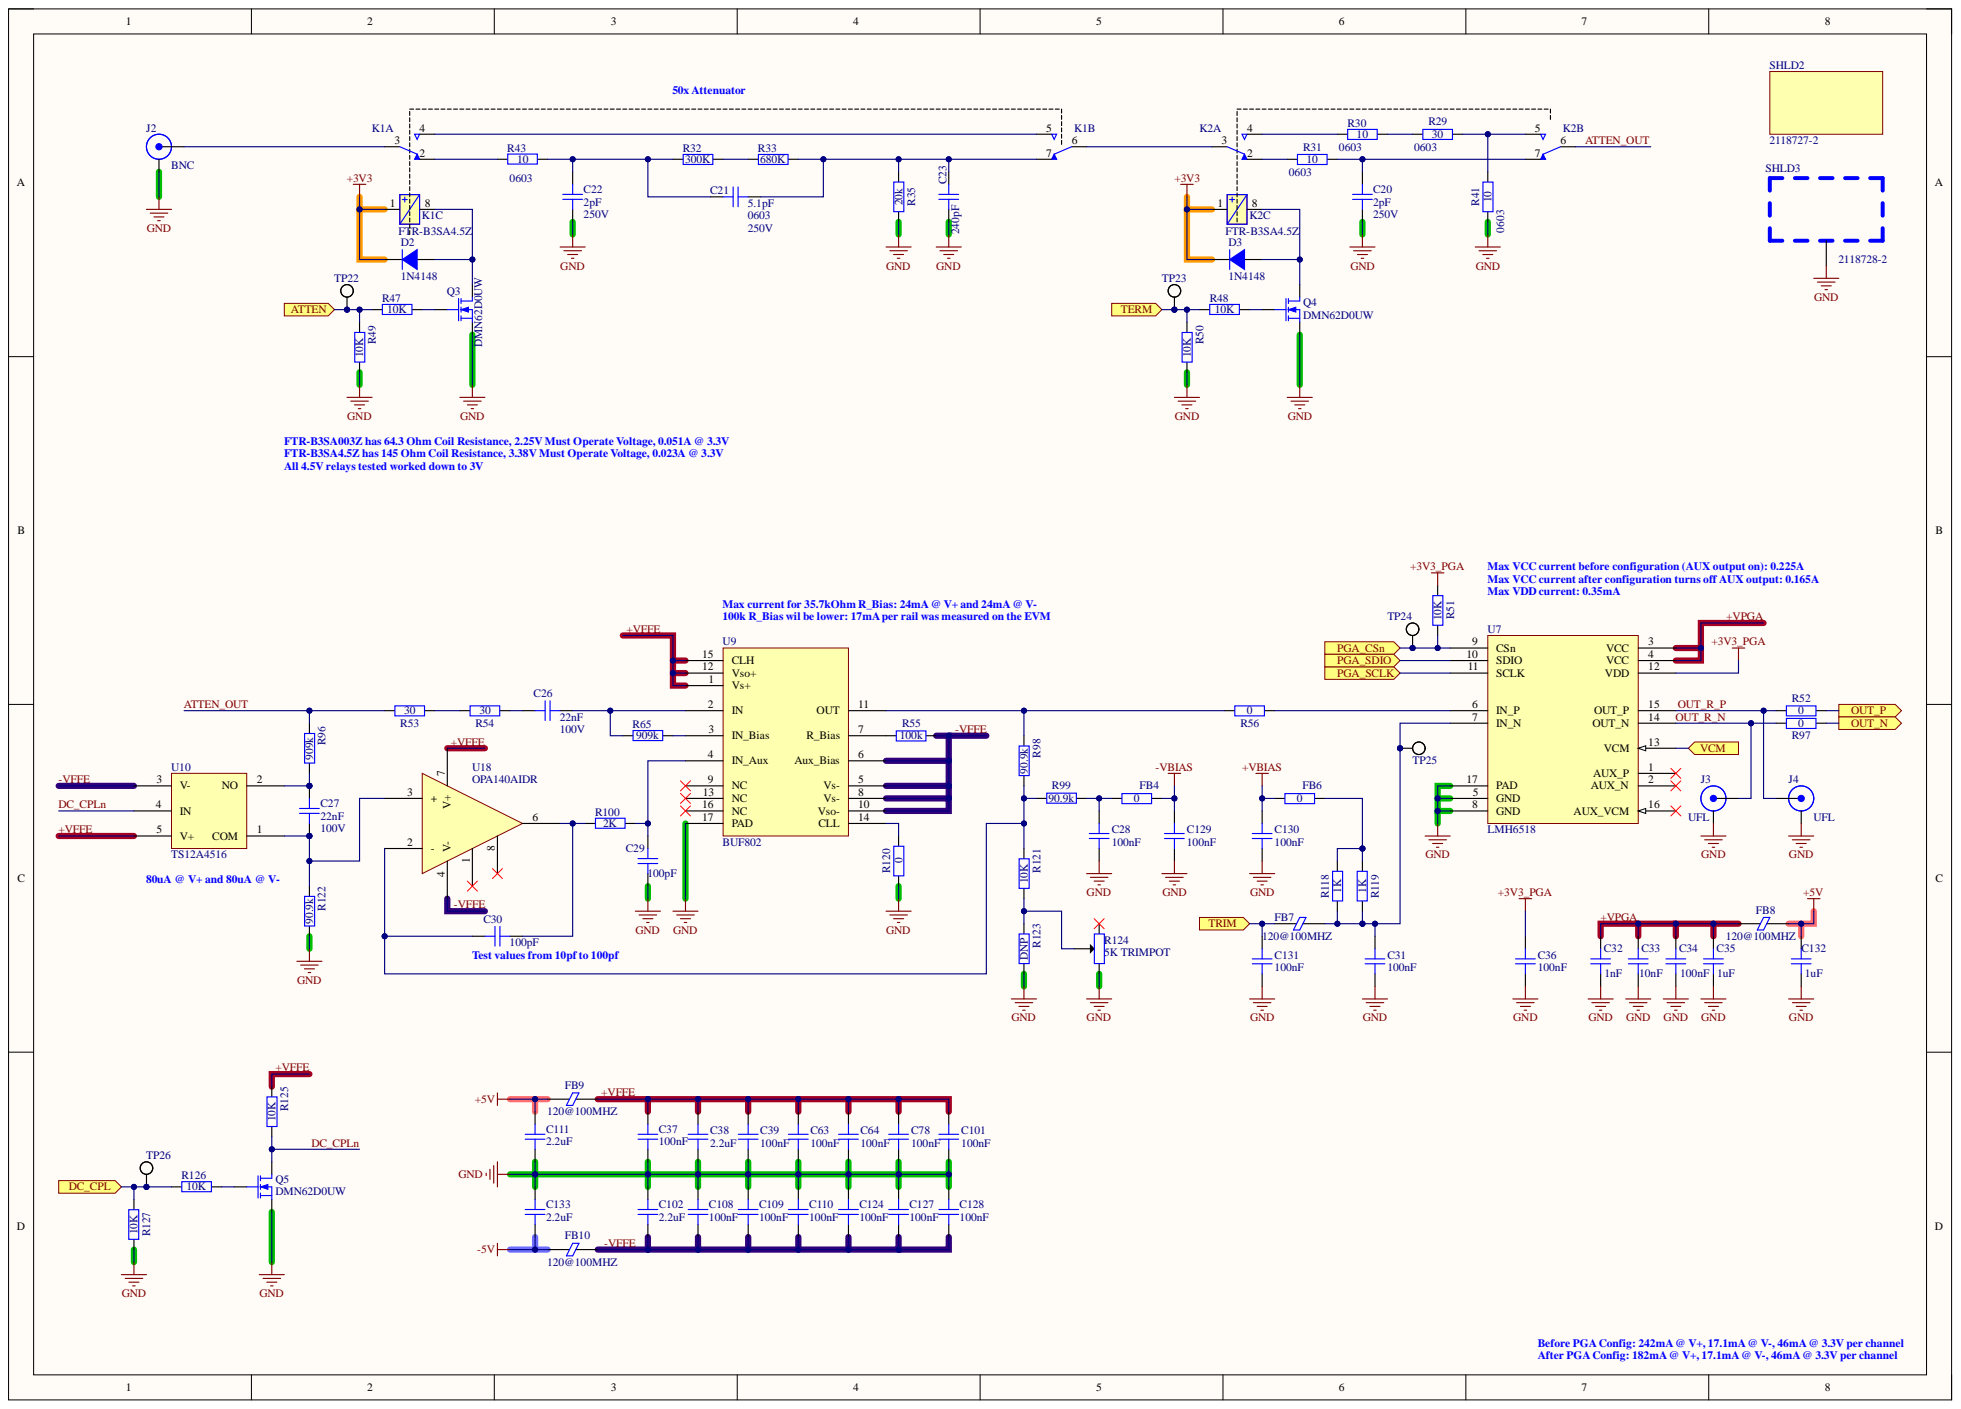
[picture p43: page 2]

FTR-B3SA003Z has 64.3 Ohm Coil Resistance, 2.25V Must Operate Voltage, 0.051A @ 3.3V
FTR-B3SA4.5Z has 145 Ohm Coil Resistance, 3.38V Must Operate Voltage, 0.023A @ 3.3V
All 4.5V relays tested worked down to 3V

Max VCC current before configuration (AUX output on): 0.225A
Max VCC current after configuration turns off AUX output: 0.165A
Max VDD current: 0.35mA

Max current for 35.7kOhm R_Bias: 24mA@ V+ and 24mA@ V-
100k R_Bias wil be lower: 17mAper rail was measured on the EVM

30 | 30 | R65 | IN_Bias 3 | R55 | 0 | IN_N 7 | OUT_R_N | 0

909k | IN_Aux 4 | 100k

Test values from 10pf to 100pf

Before PGAConfig: 242mA@ V+, 17.1mA@ V-, 46mA@ 3.3V per channel
After PGAConfig: 182mA@ V+, 17.1mA@ V-, 46mA@ 3.3V per channel

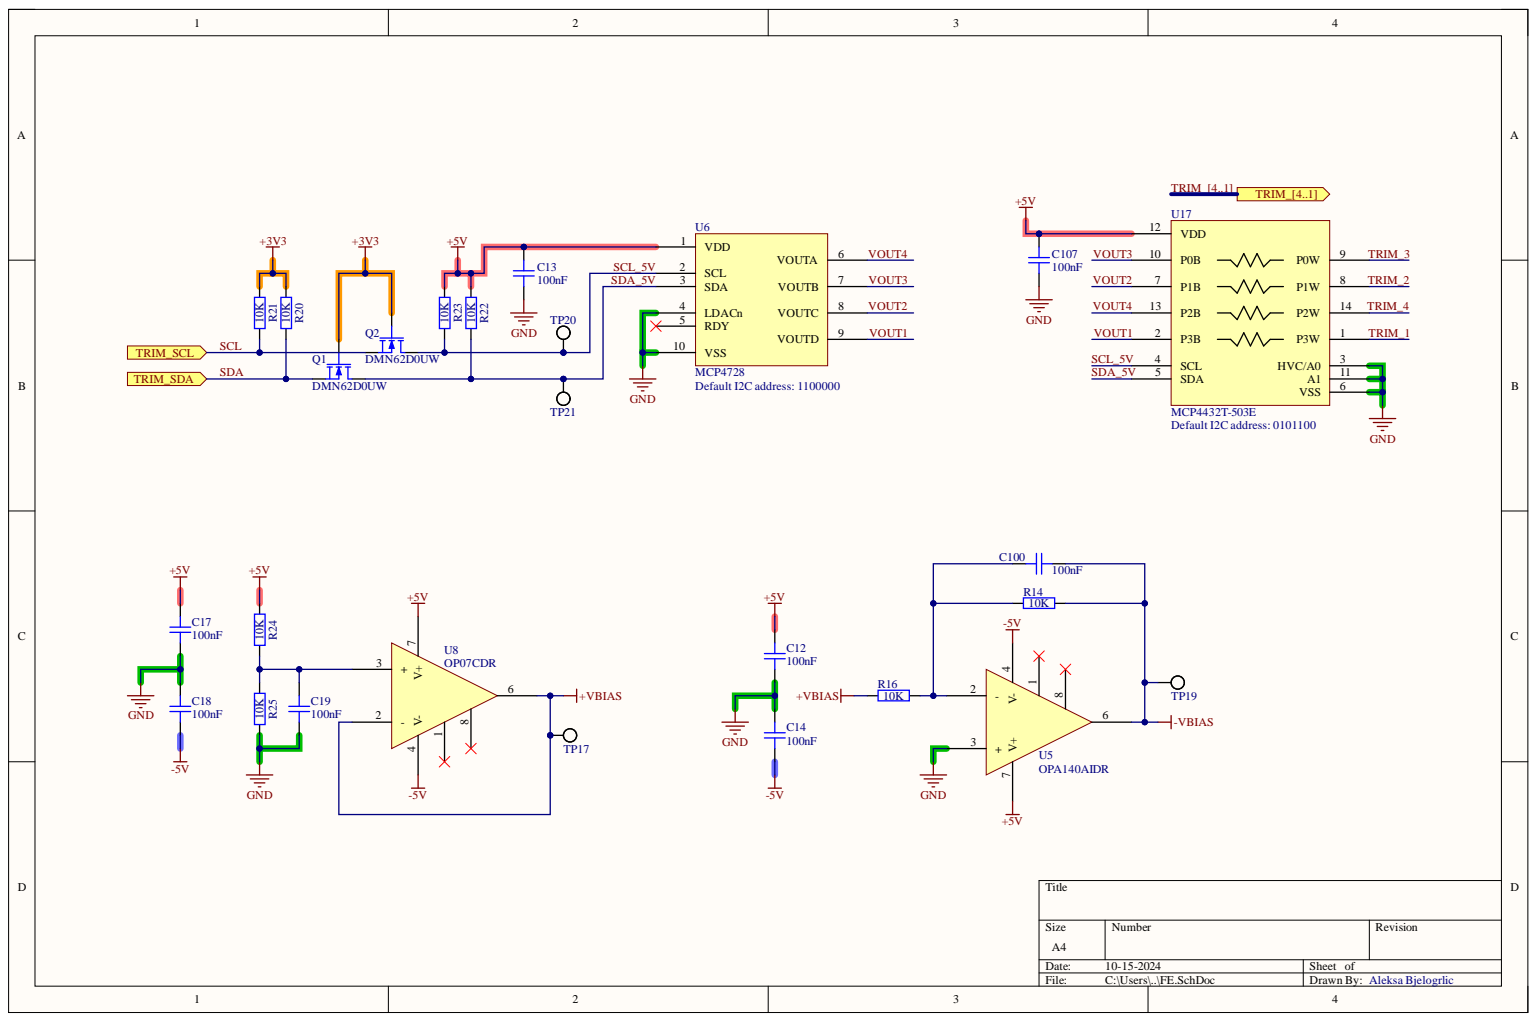
[picture p44: page 3]

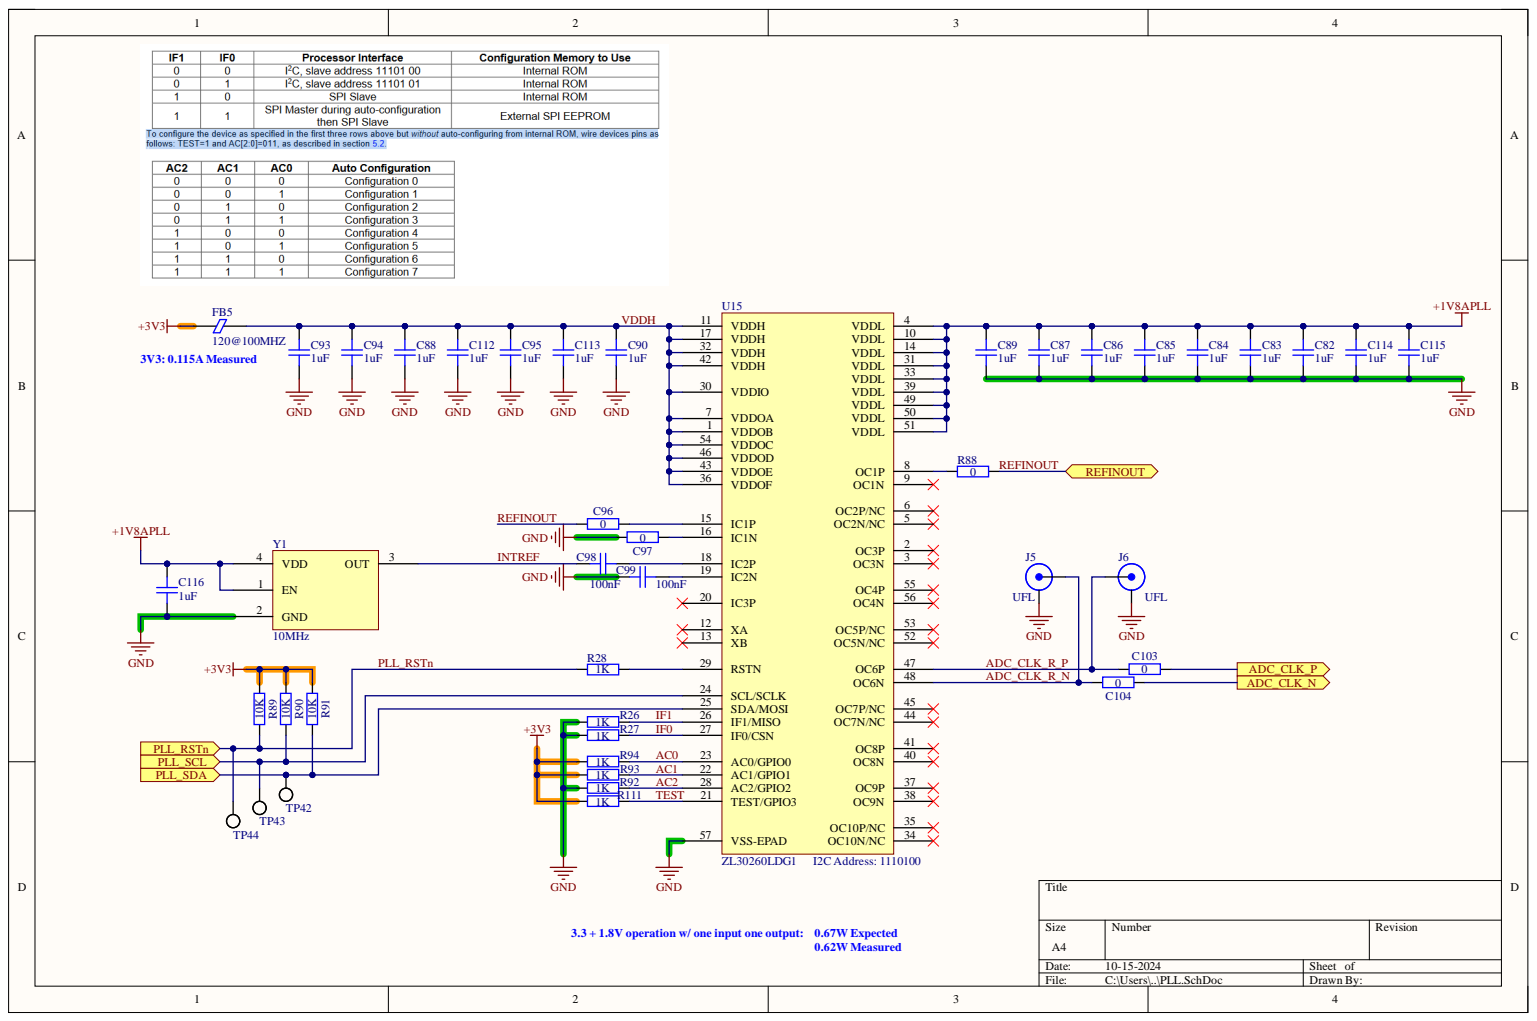
[picture p45: page 4]

3.3 + 1.8V operation w/ one input one output:

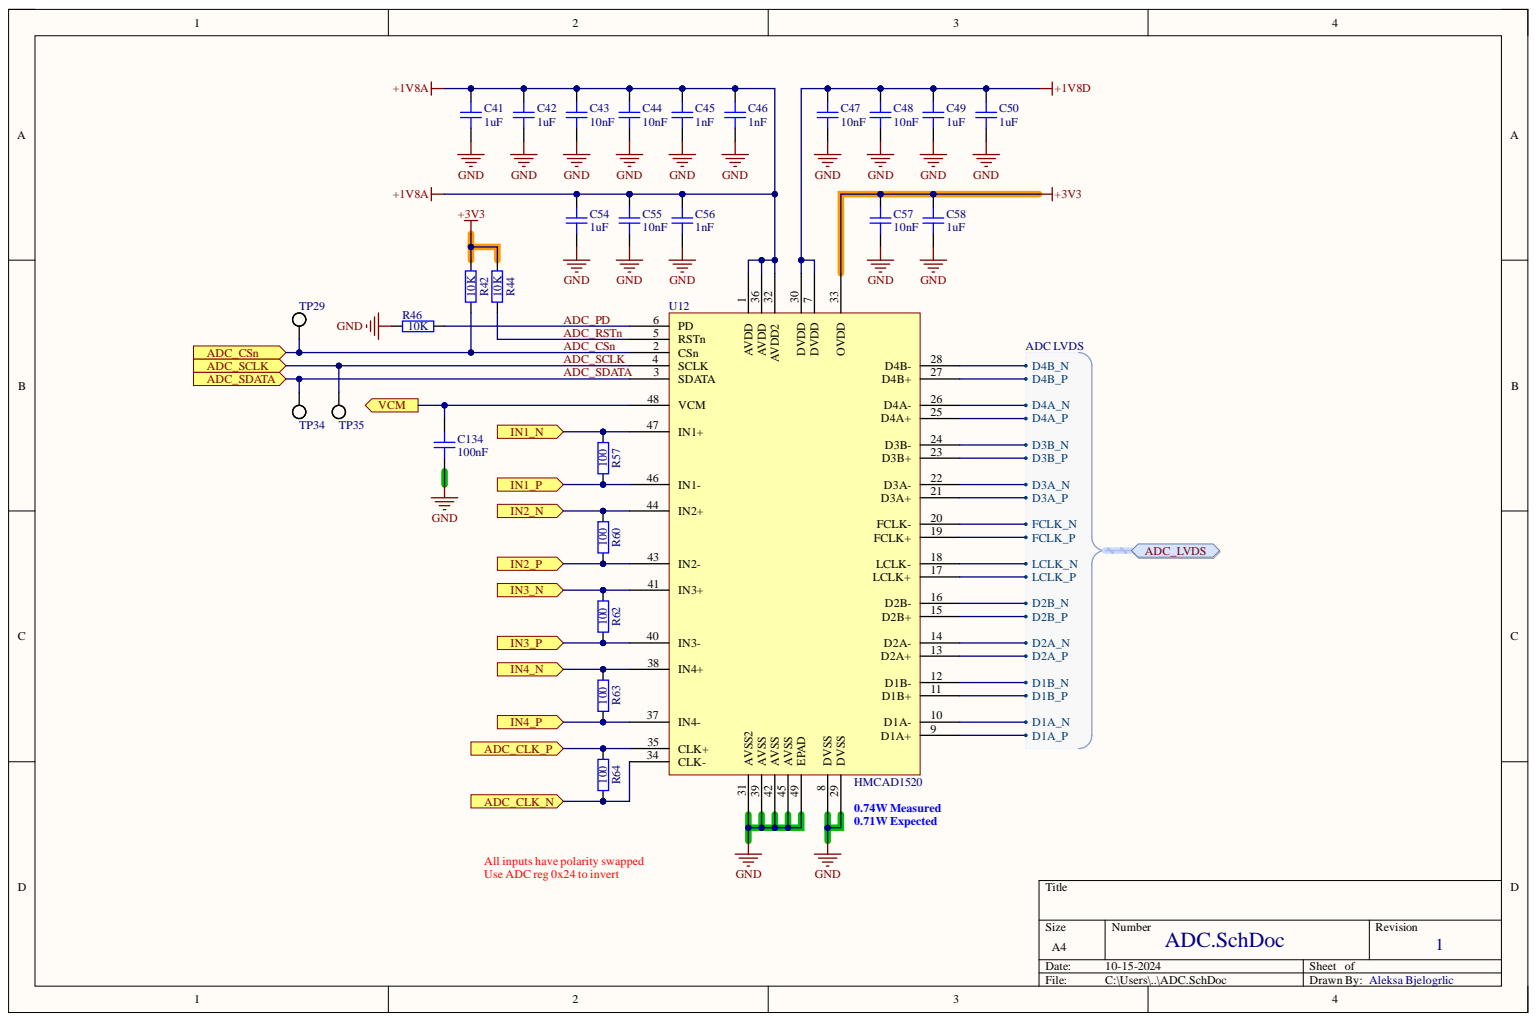
[picture p46: page 5]

10K | ADC_RSTn

All inputs have polarity swapped
Use ADC reg 0x24 to invert

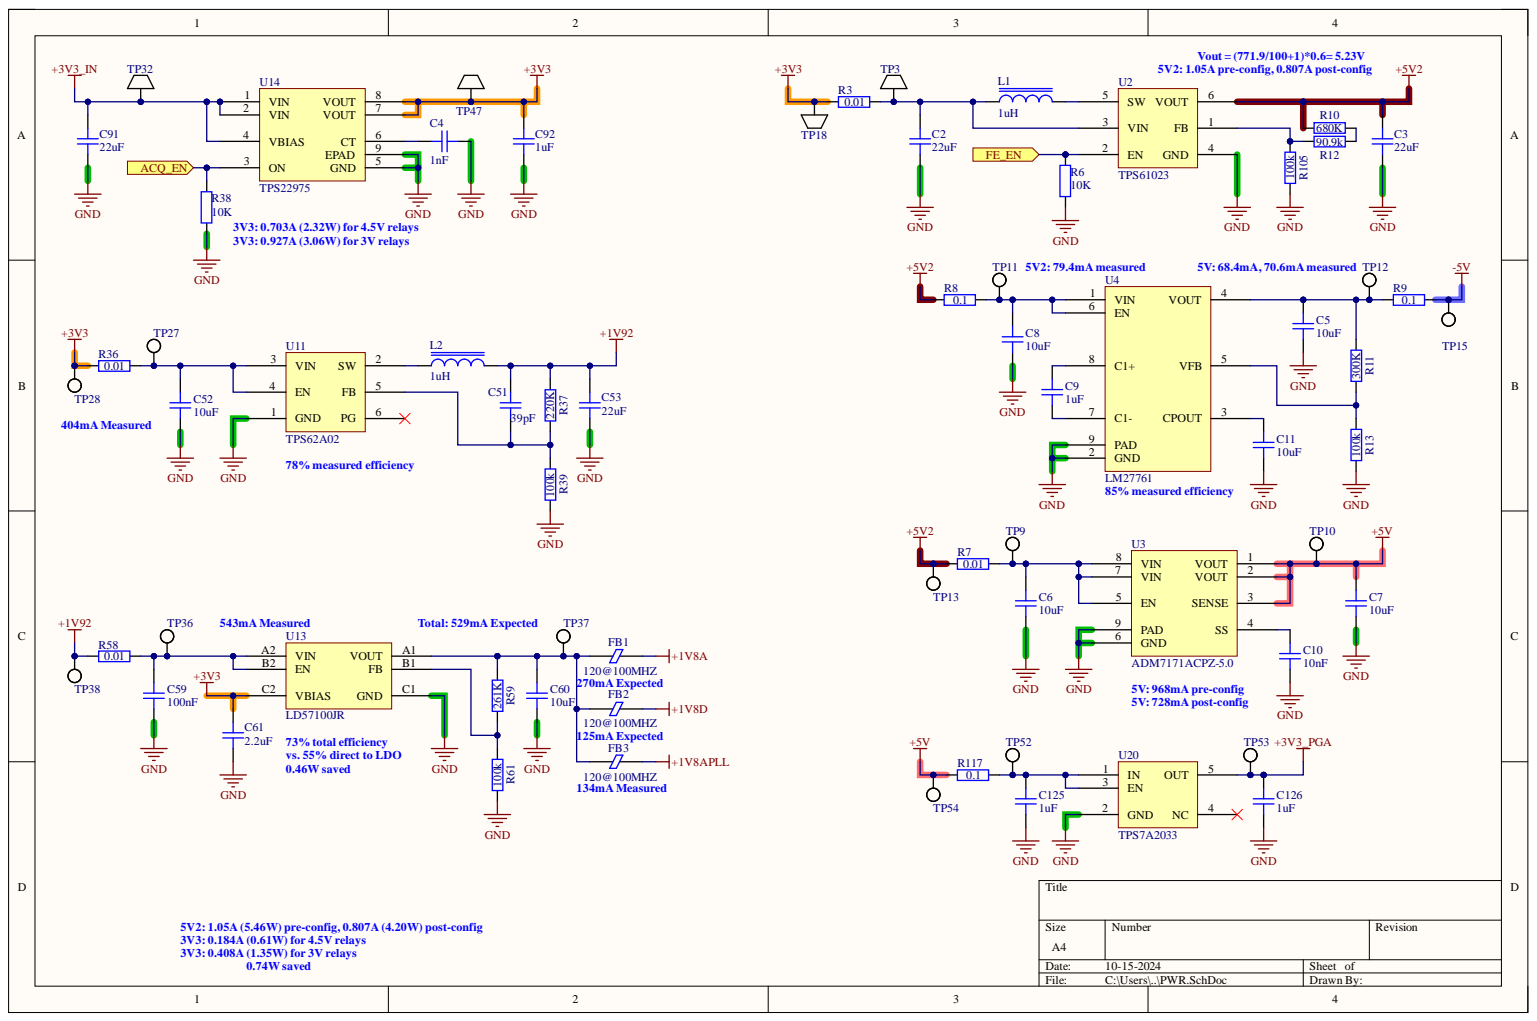
[picture p47: page 6]

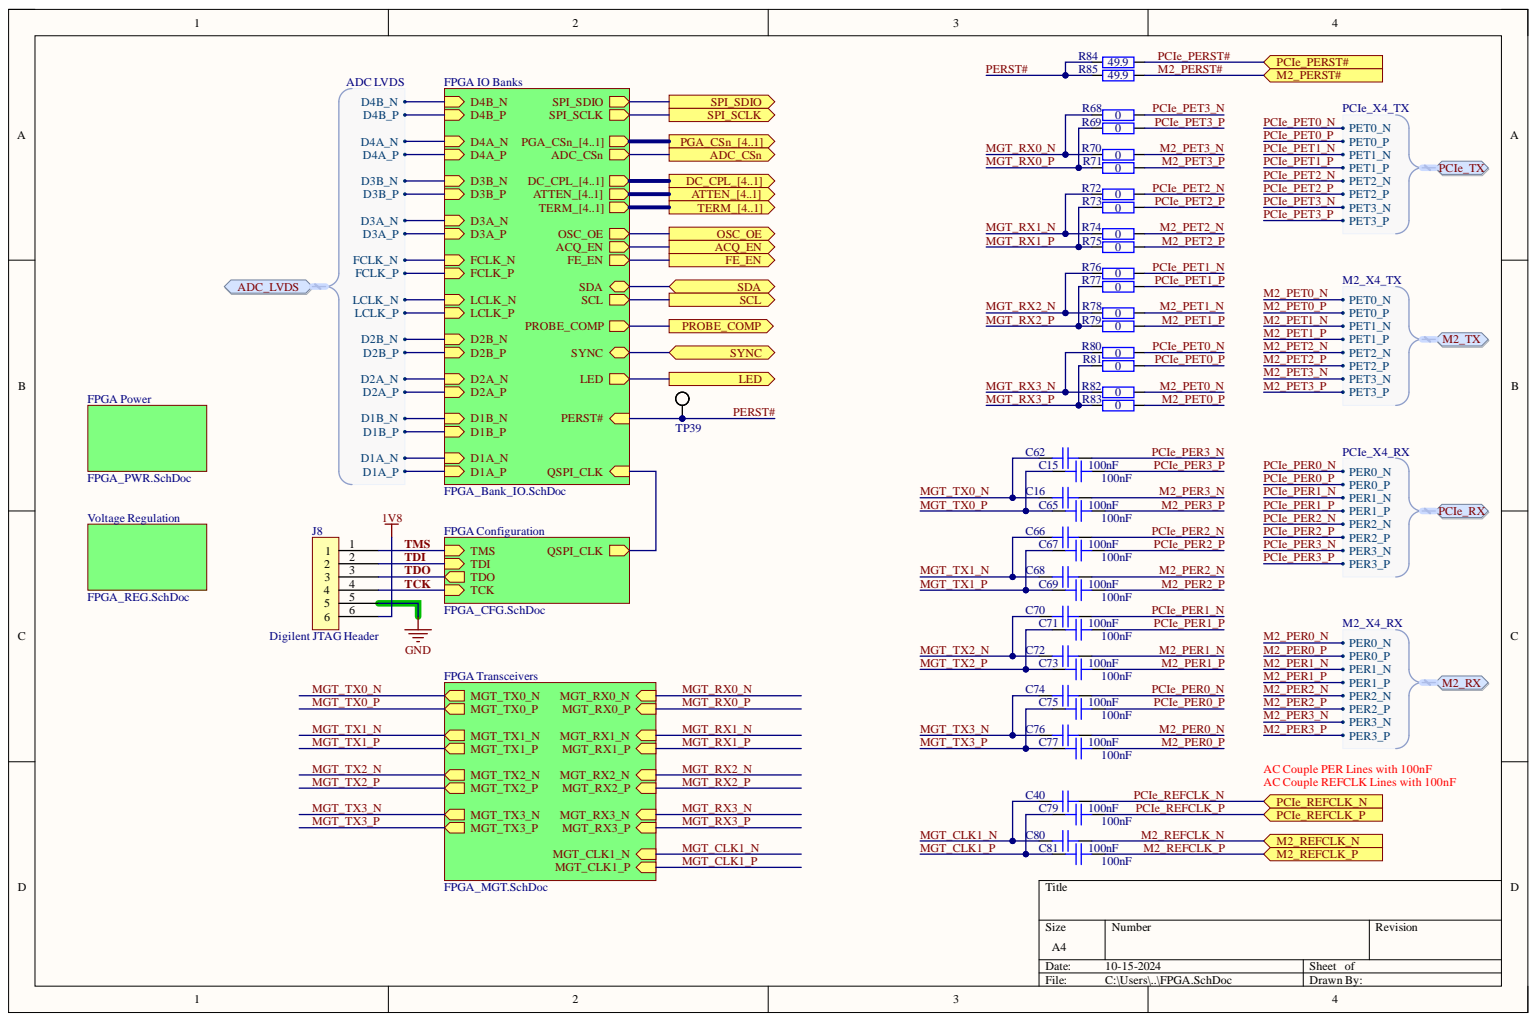
[picture p48: page 7]

2 | TD I
3 | TD O
4 | TC K

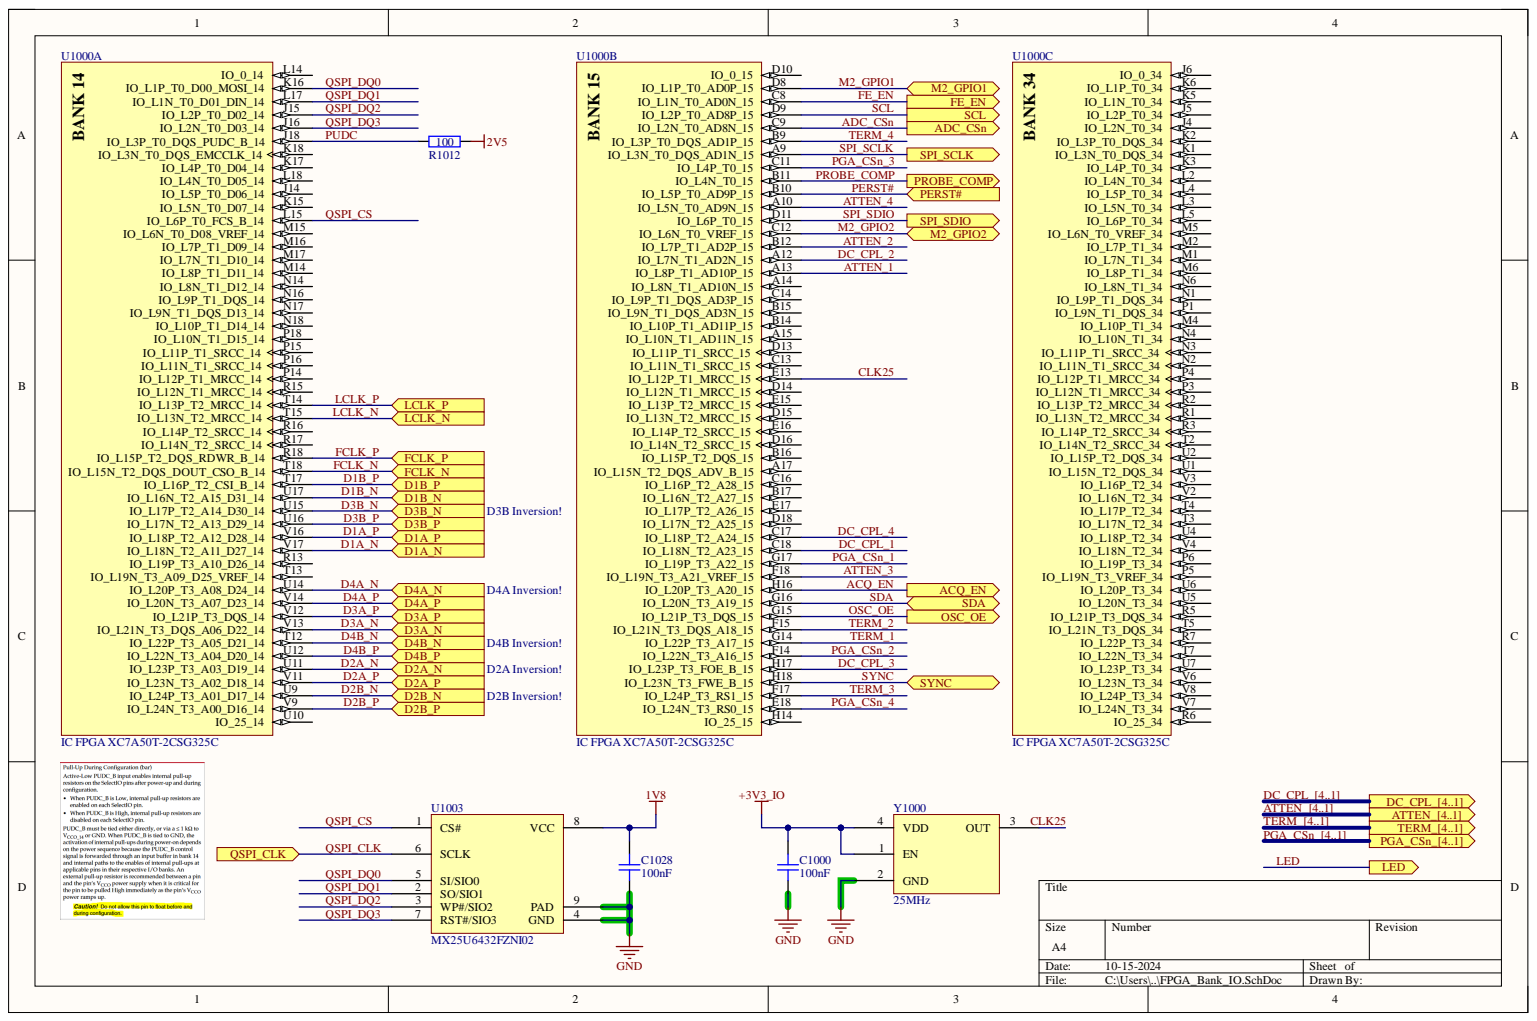
[picture p49: page 8]

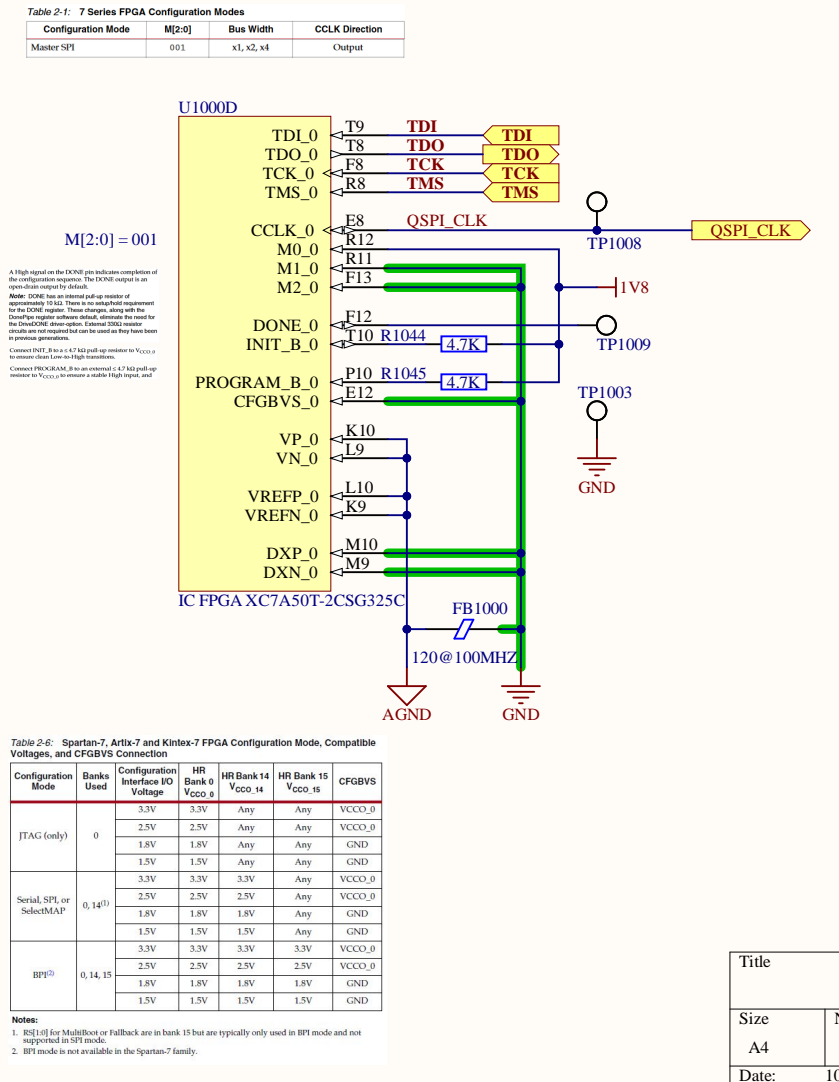
[picture p50: page 9]

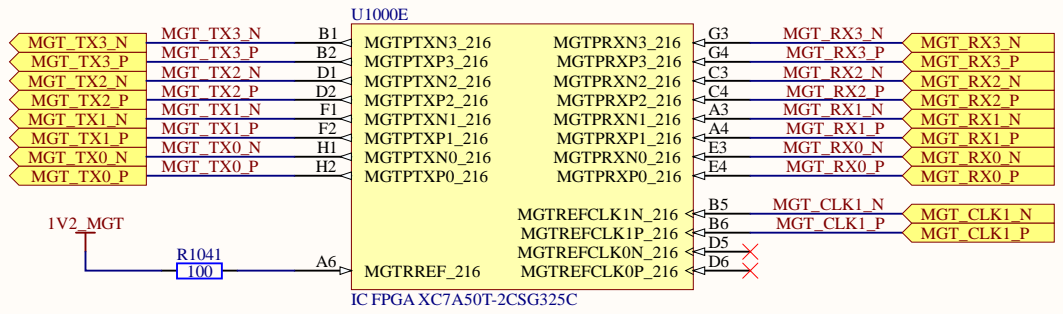
[picture p51: page 10]

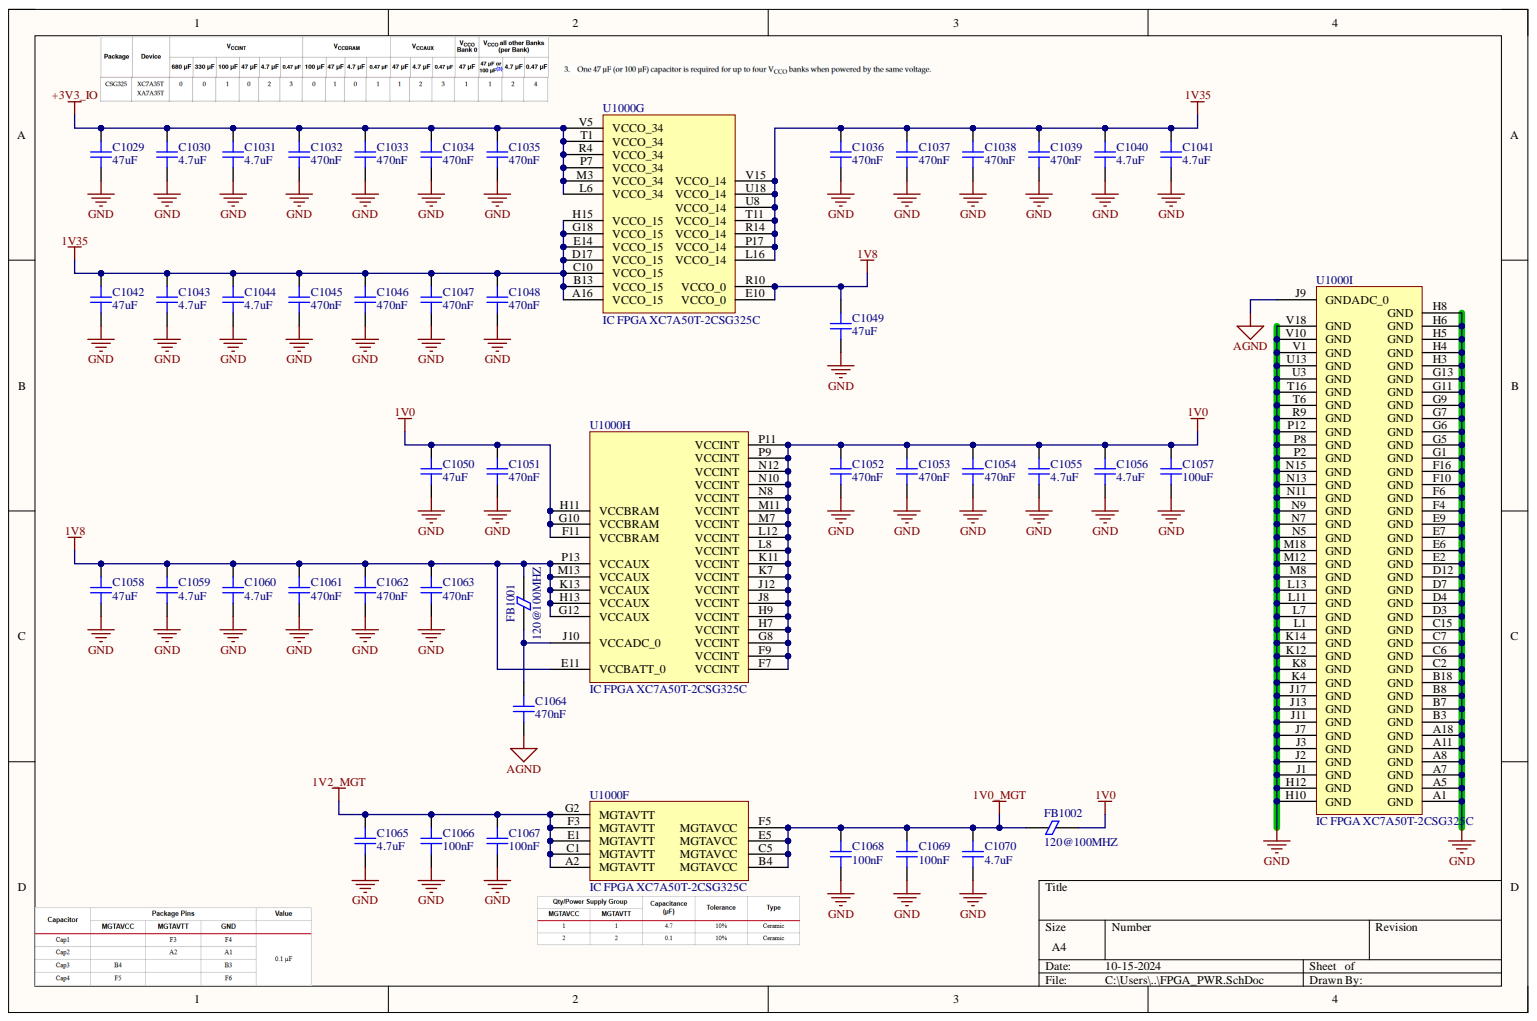
[picture p52: page 11]

K 1 1 | | E 2
K 7 | | D 1 2

H 1 3 | J 8 | L 1 1 | D 4
G 1 2 | H 9 | L 7 | D 3

H 7 | L 1 | 5
G 8 | K 1 4

J 7 | A 1 8
J 3 | A 1 1
J 2 | A 8
J 1 | A 7
H 1 2 | A 5
H 1 0 | A 1

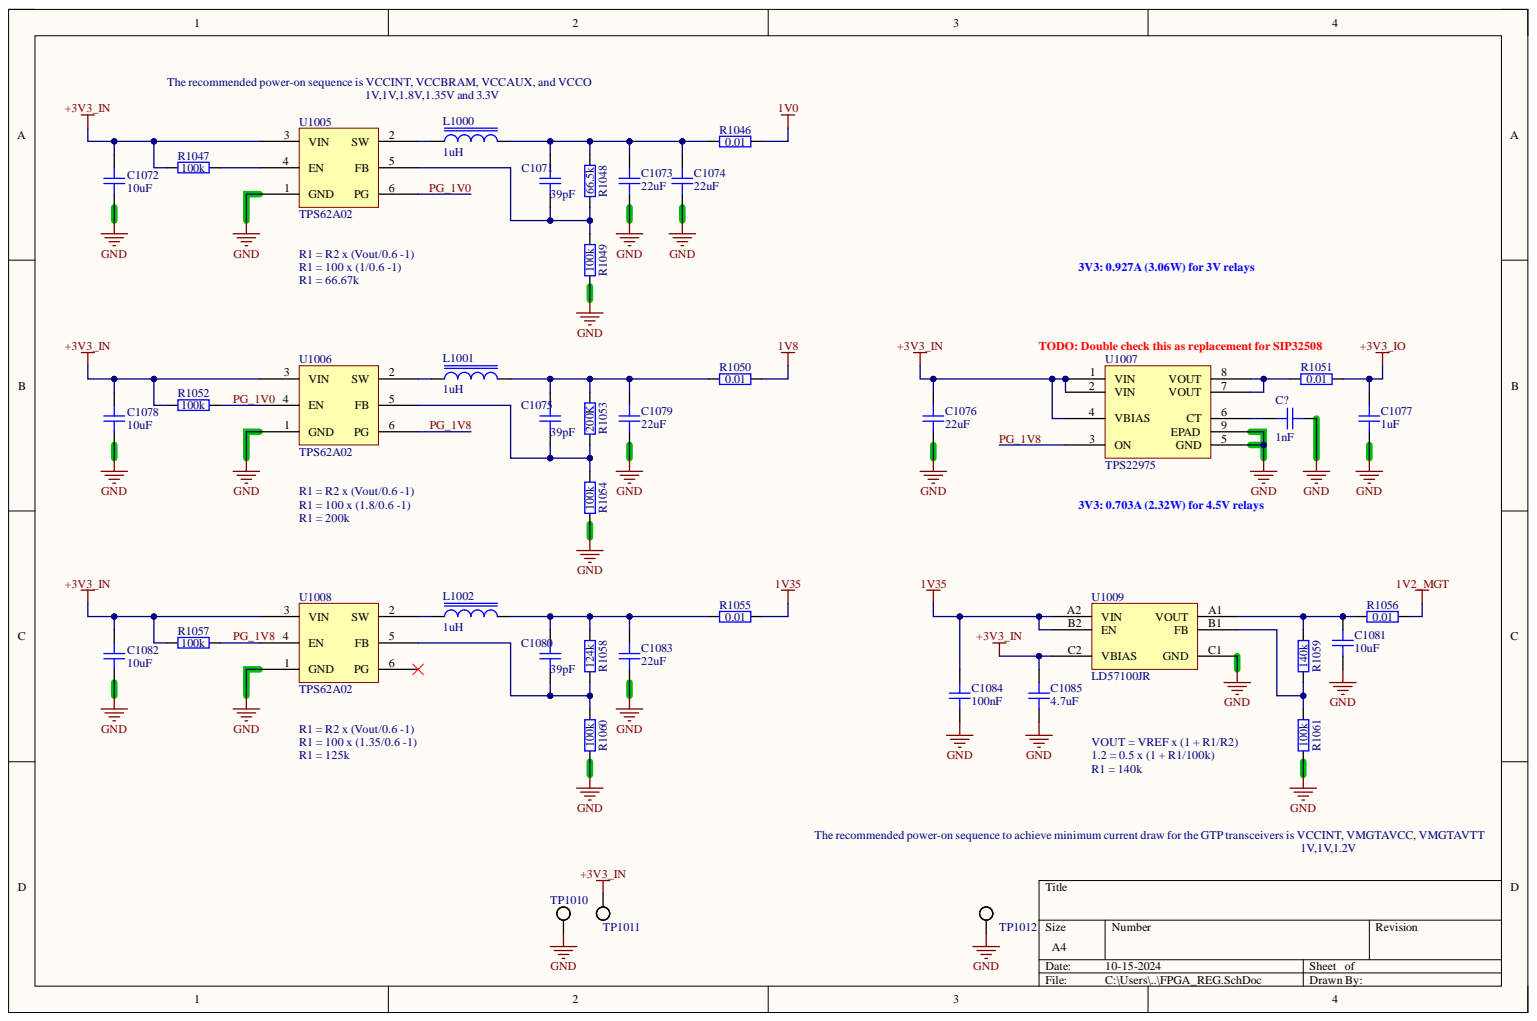
[picture p53: page 12]

The recommended power-on sequence is VCCINT, VCCBRAM, VCCAUX, and VCCO

TODO: Double check this as replacement for SIP32508

The recommended power-on sequence to achieve minimum current draw for the GTP transceiversis VCCINT, VMGTAVCC, VMGTAVTT

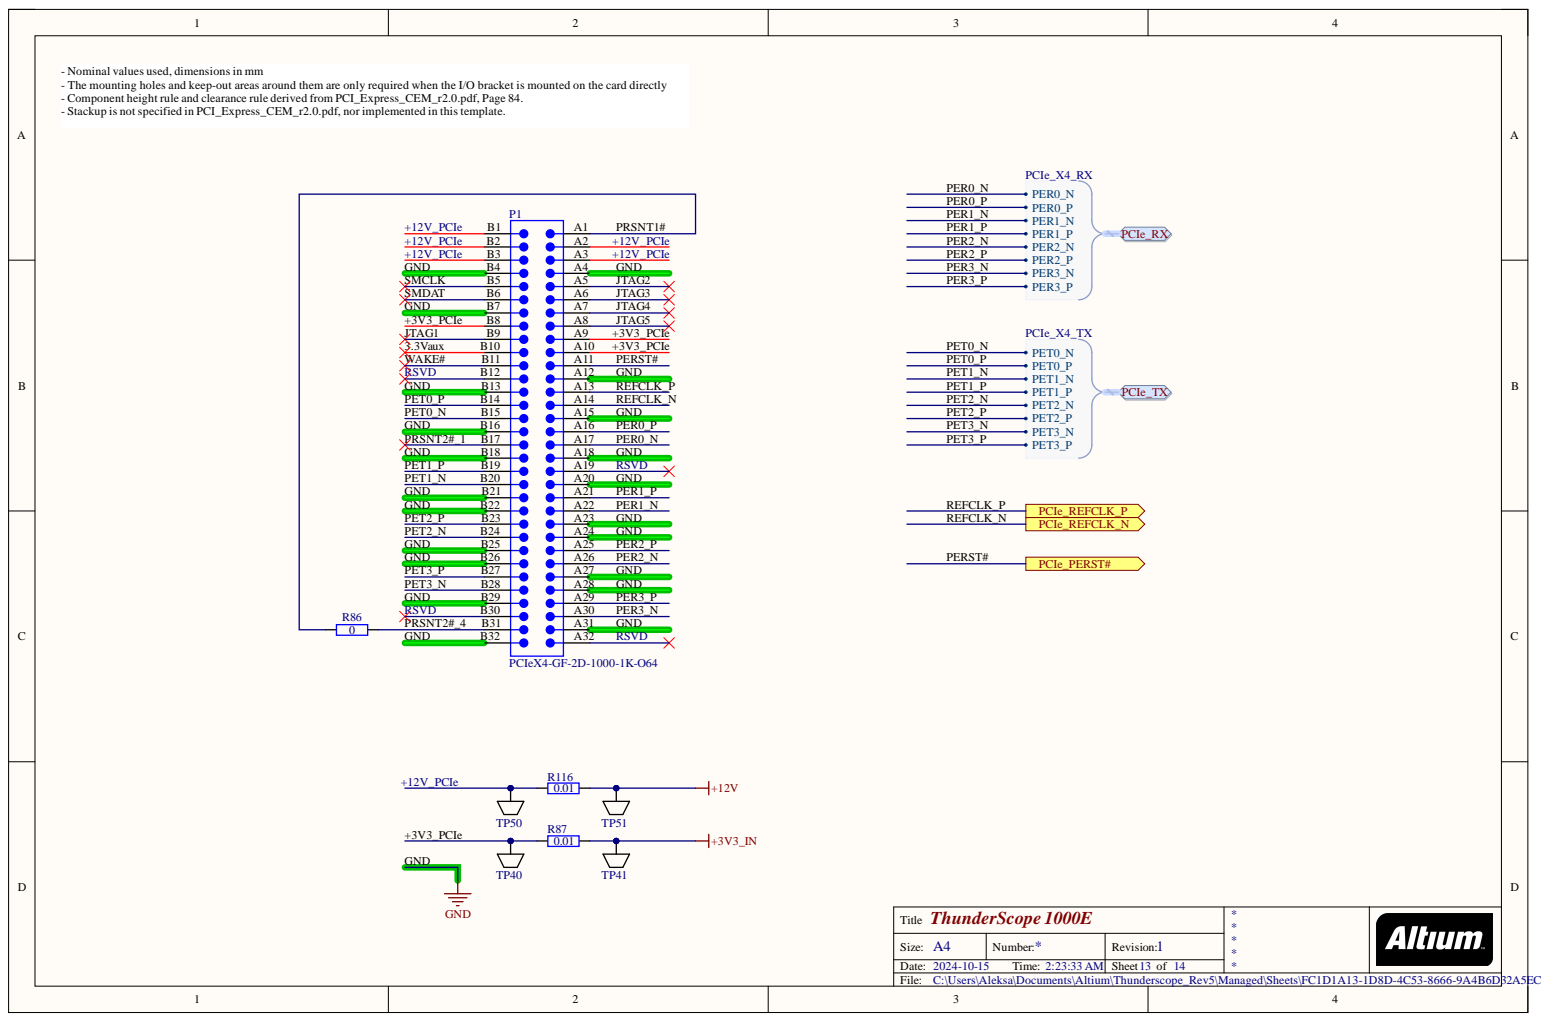
[picture p54: page 13]

- Nominal values used, dimensions in mm
- The mounting holes and keep-out areas around them are only required when the I/O bracket is mounted on the card directly
- Component height rule and clearance rule derived from PCI_Express_CEM_r2.0.pdf, Page 84.
- Stackup is not specified in PCI_Express_CEM_r2.0.pdf, nor implemented in this template.

C:\Users\Aleksa\Documents\Altium\Thunderscope_Rev5\Managed\Sheets\FC1D1A13-1D8D-4C53-8666-9A4B6D32A5EC\CON_PCIe_X4.SchDoc

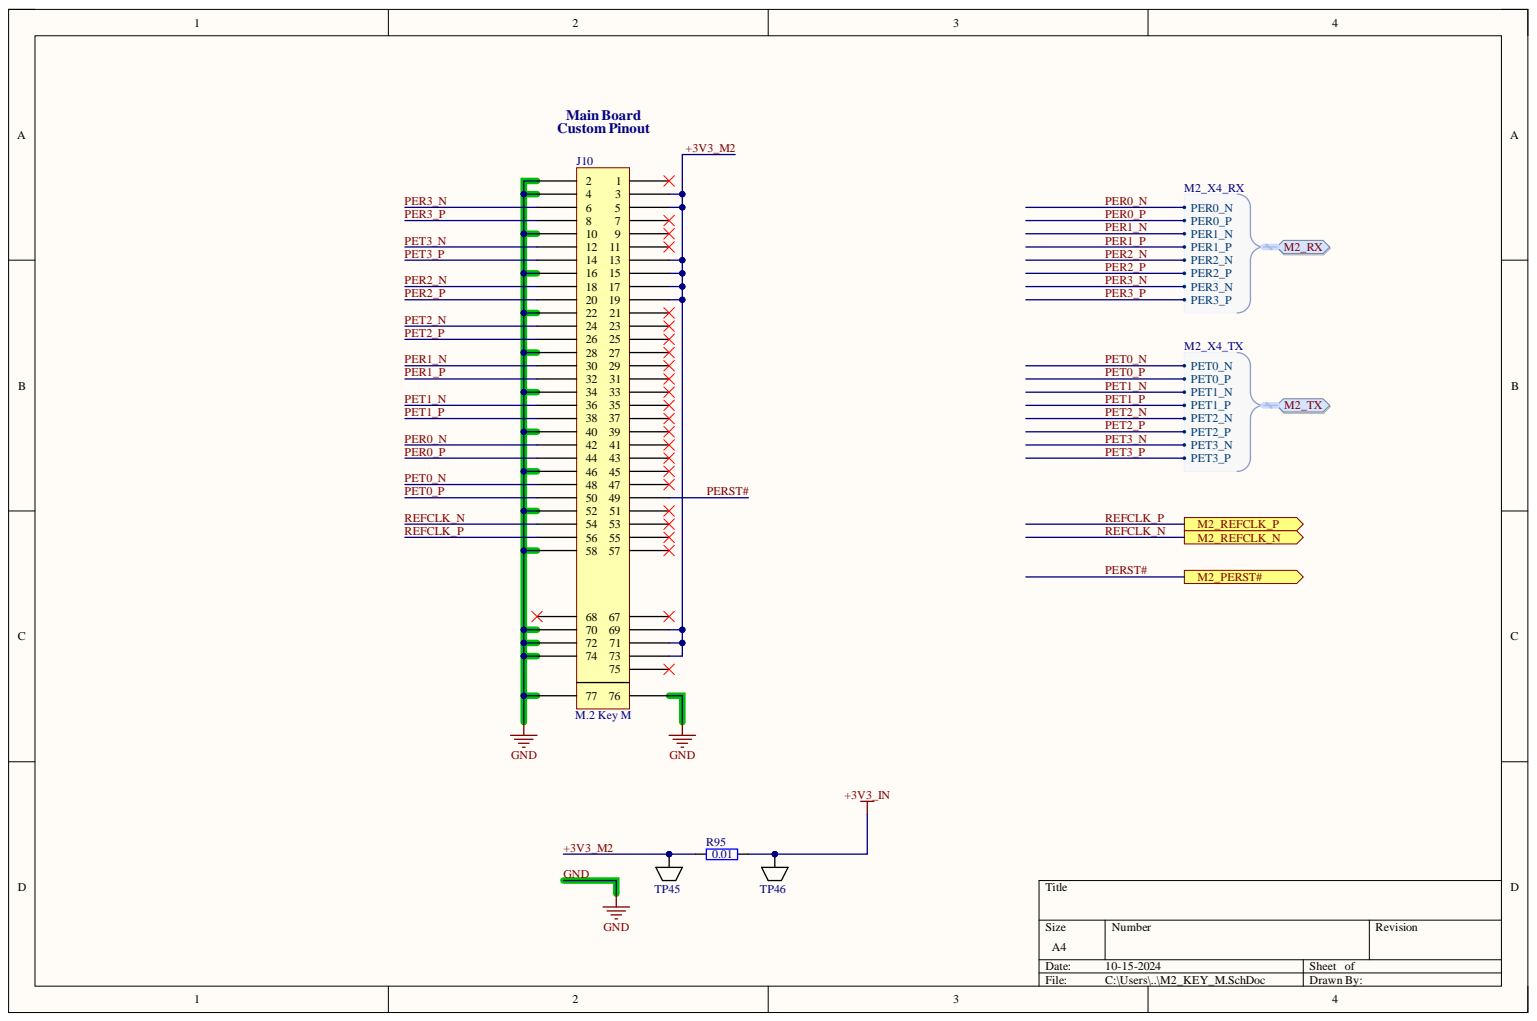
[picture p55: page 14]
