EEVengers/ts_hardware_archive/Altium/Thunderscope_Rev2/Thunderscope_Rev2.pdf

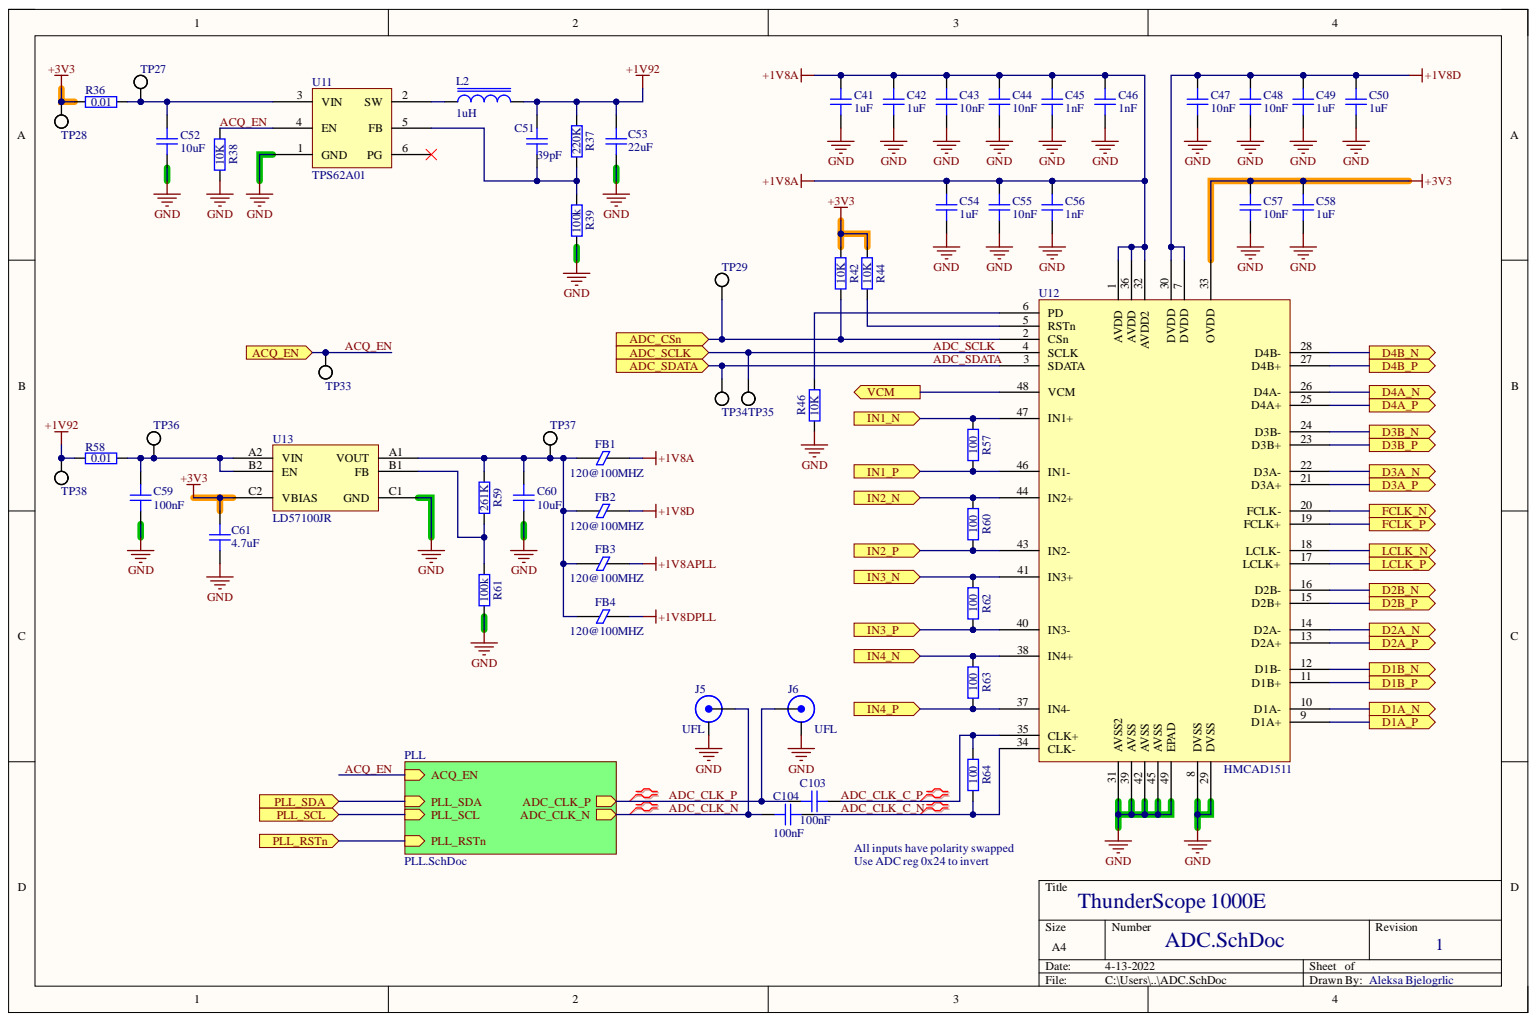
[picture p56: page 1]

A DC_SCL K | 4
A DC_SD ATA | 3

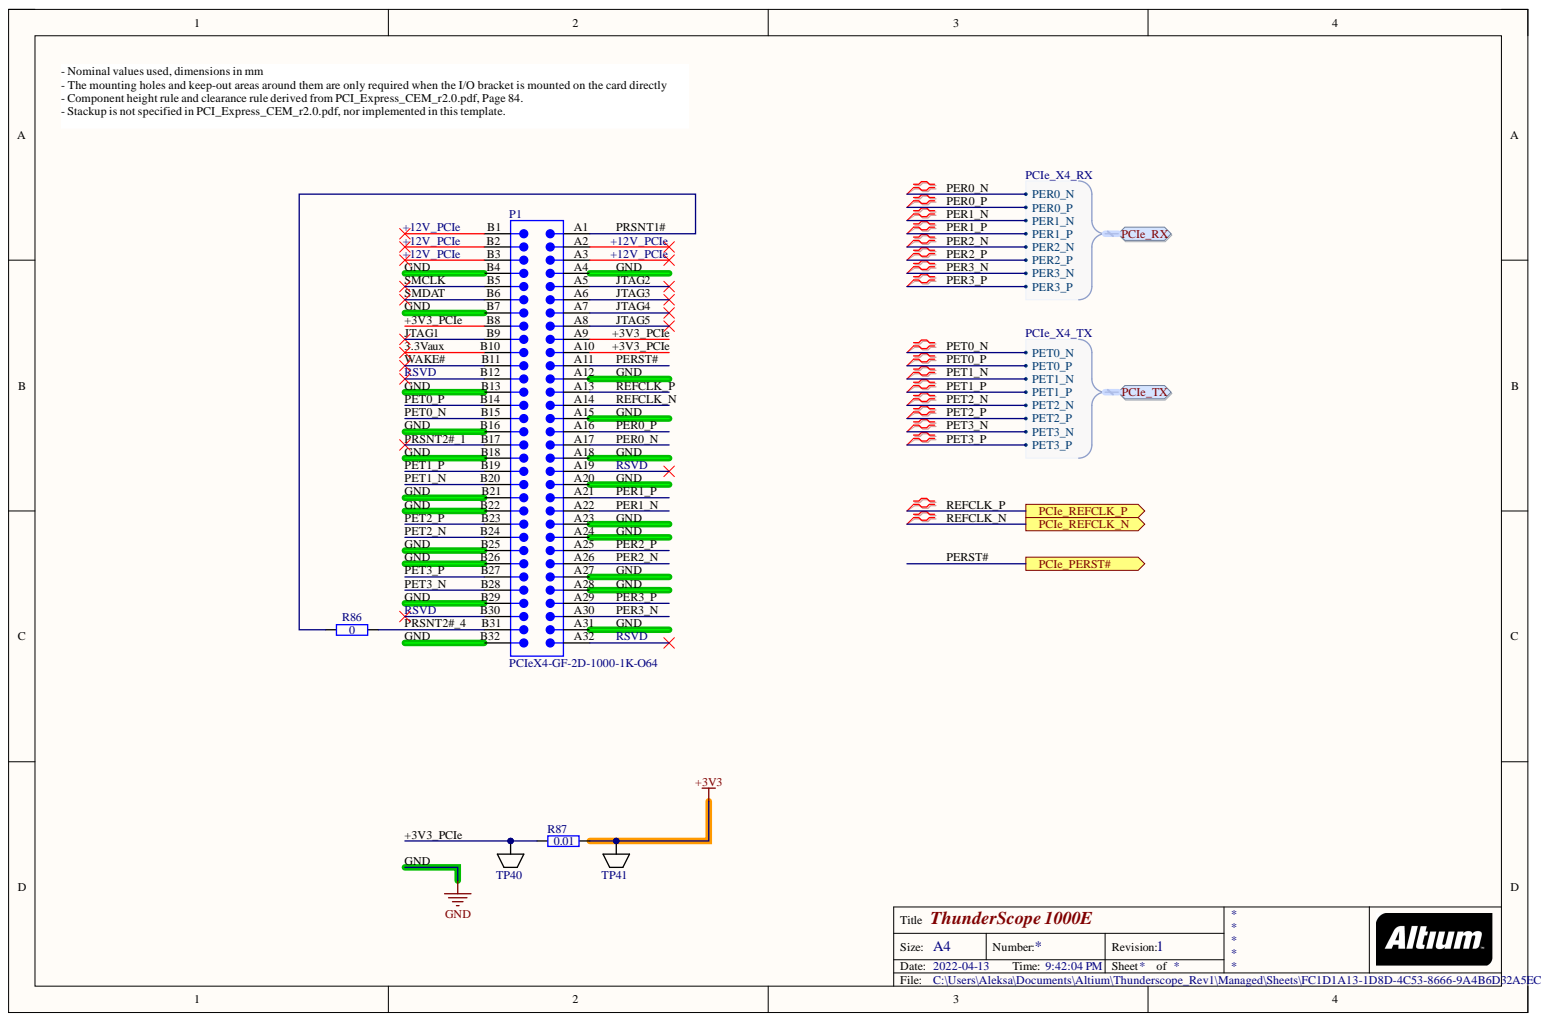
[picture p57: page 2]

- Nominal values used, dimensions in mm
- The mounting holes and keep-out areas around them are only required when the I/O bracket is mounted on the card directly
- Component height rule and clearance rule derived from PCI_Express_CEM_r2.0.pdf, Page 84.
- Stackup is not specified in PCI_Express_CEM_r2.0.pdf, nor implemented in this template.

C:\Users\Aleksa\Documents\Altium\Thunderscope_Rev1\Managed\Sheets\FC1D1A13-1D8D-4C53-8666-9A4B6D32A5EC\CON_PCIe_X4.SchDoc

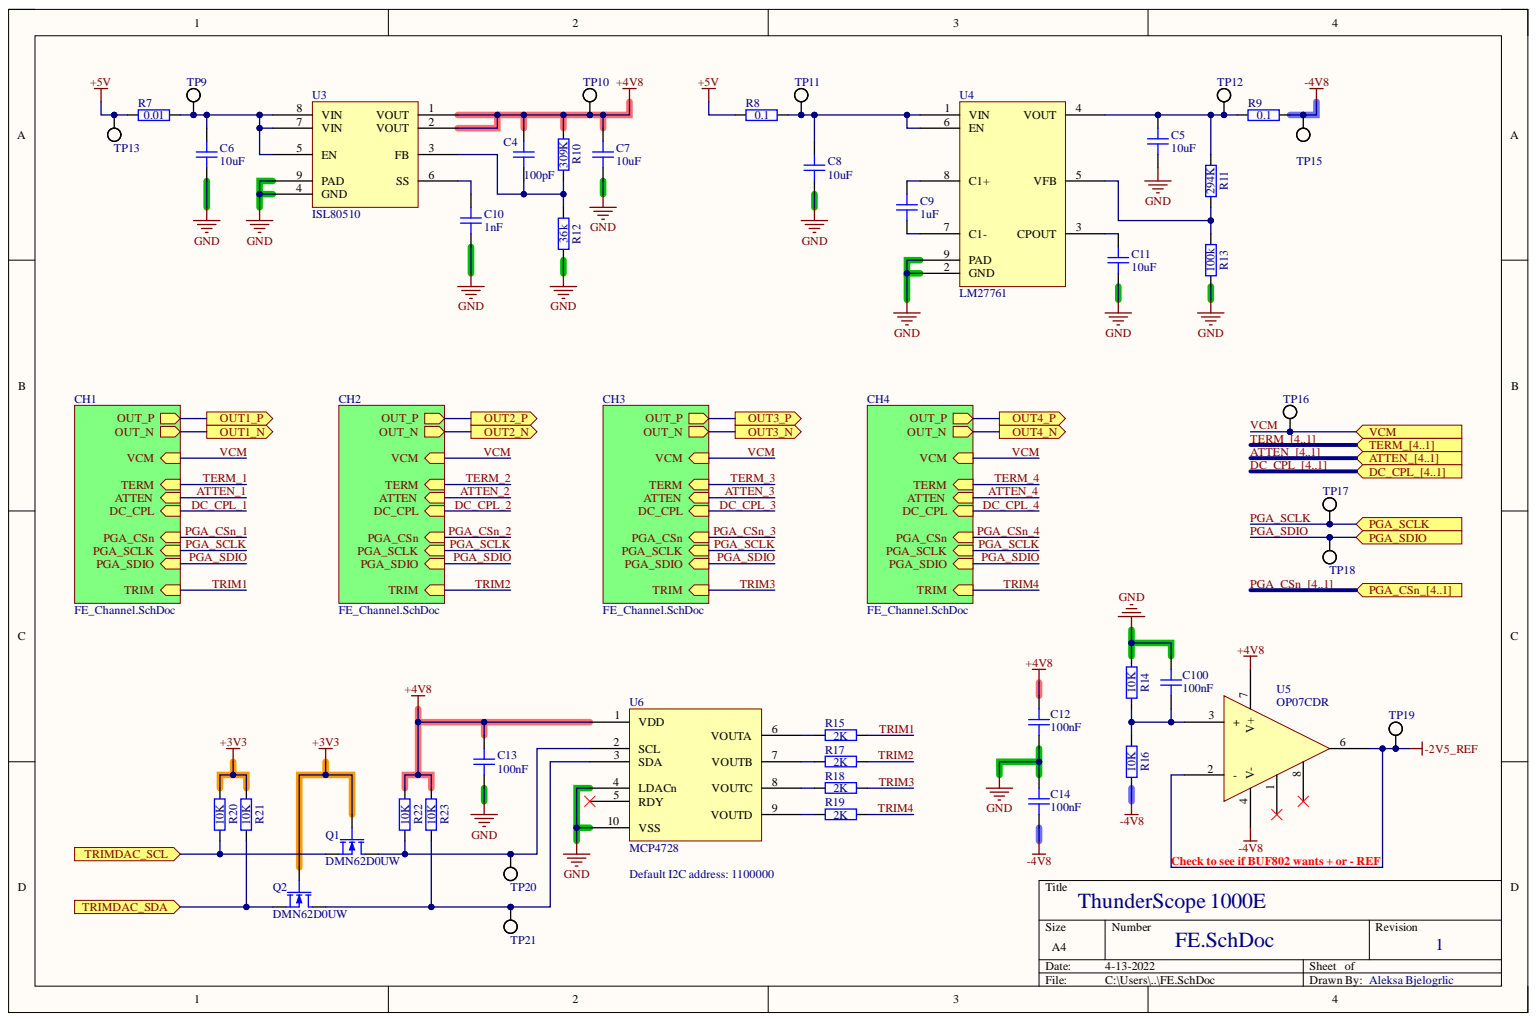
[picture p58: page 3]

SDA 3

RDY 5

Check to see if BUF802 wants + or - REF

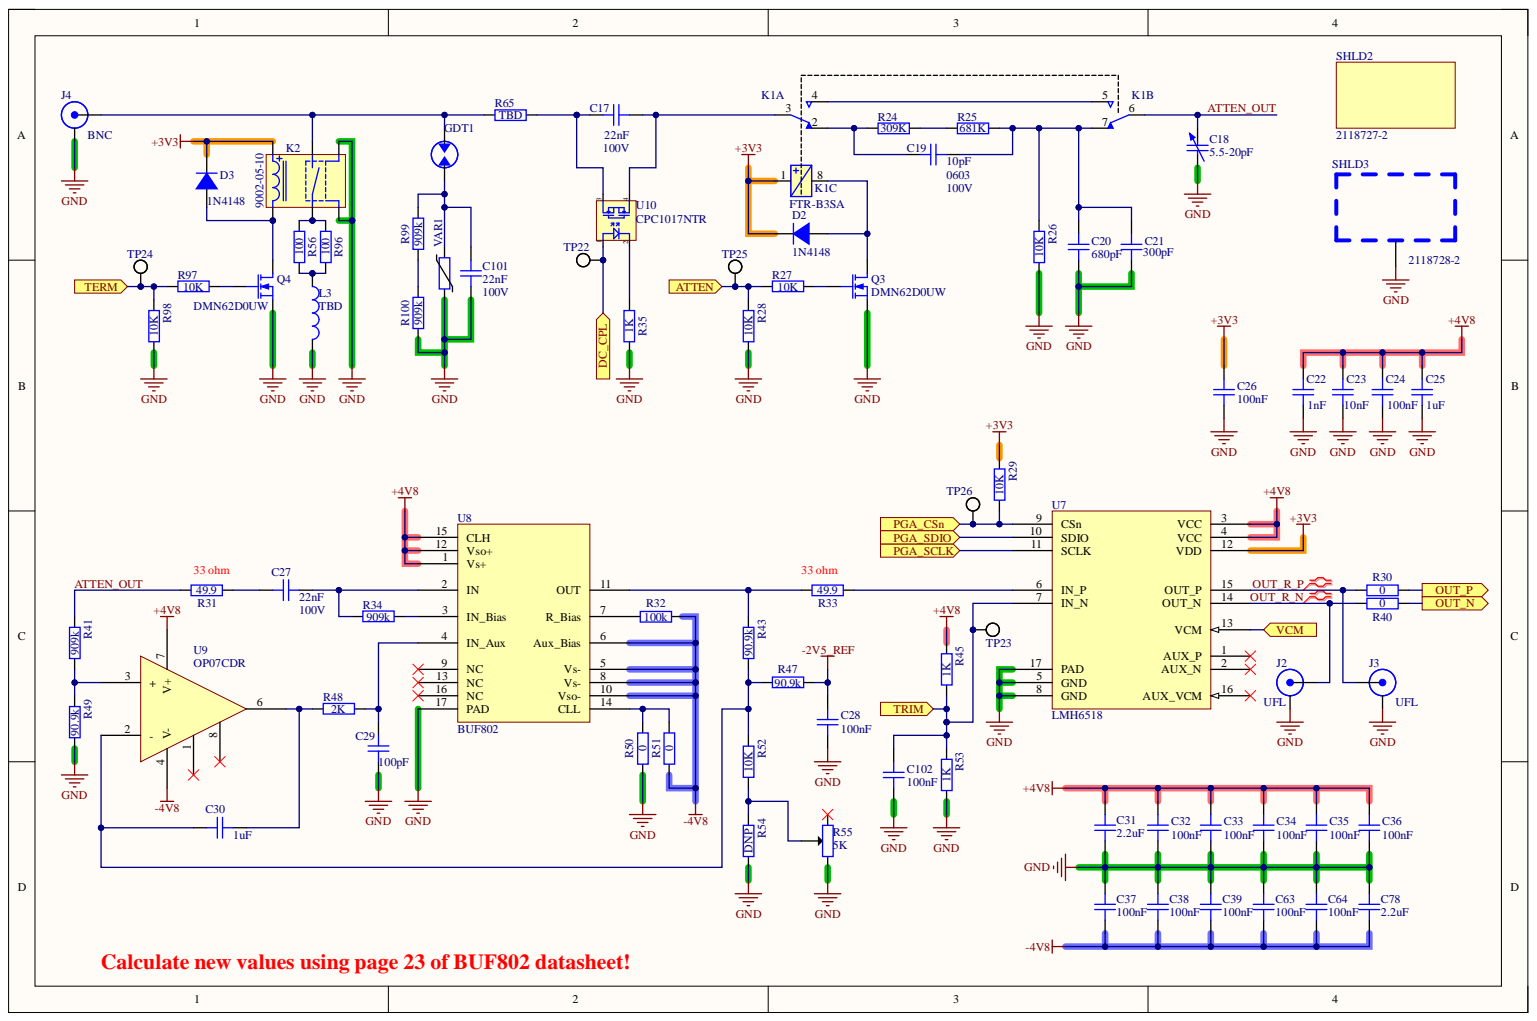
[picture p59: page 4]

Calculate new values using page 23 of BUF802 datasheet!

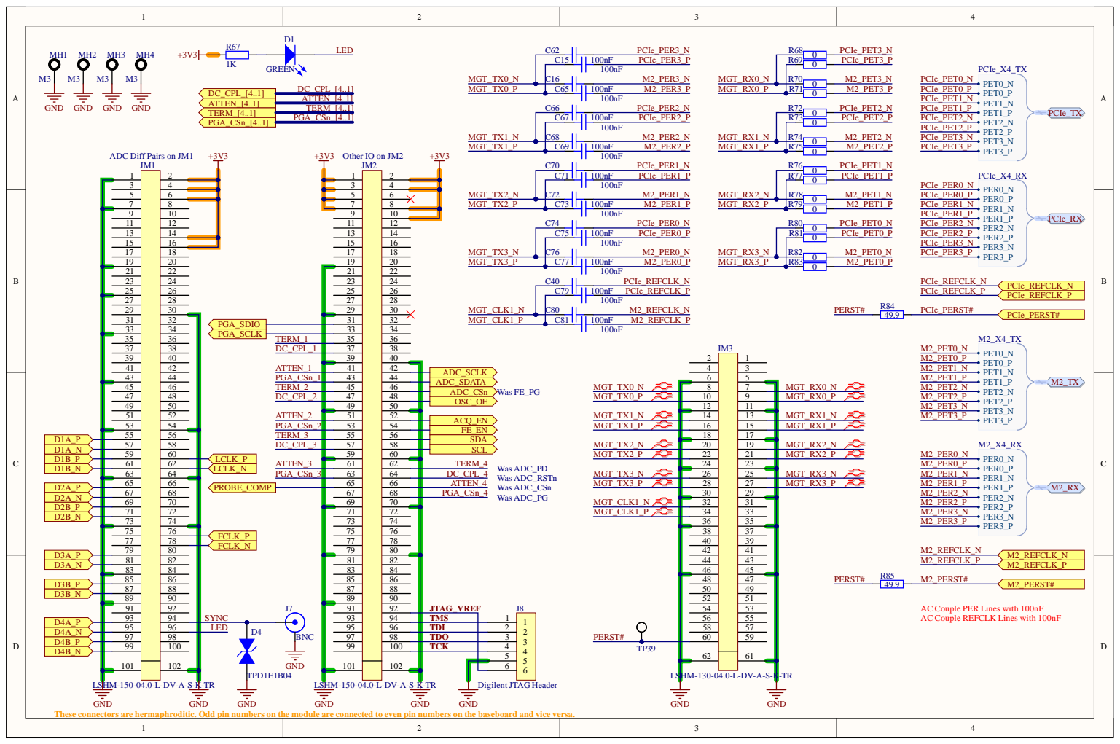
[picture p60: page 5]

C15 | 100nF PCIe_PER3_P

C67 | 100nF PCIe_PER2_P

C69 | | 100nF M2_PER2_P MGT_RX1_P | R74 | 0 R75 0

AC Couple PER Lines with 100nF
AC Couple REFCLK Lines with 100nF

These connectors are hermaphroditic. Odd pin numbers on the module are connected to even pin numbers on the baseboard and vice versa.

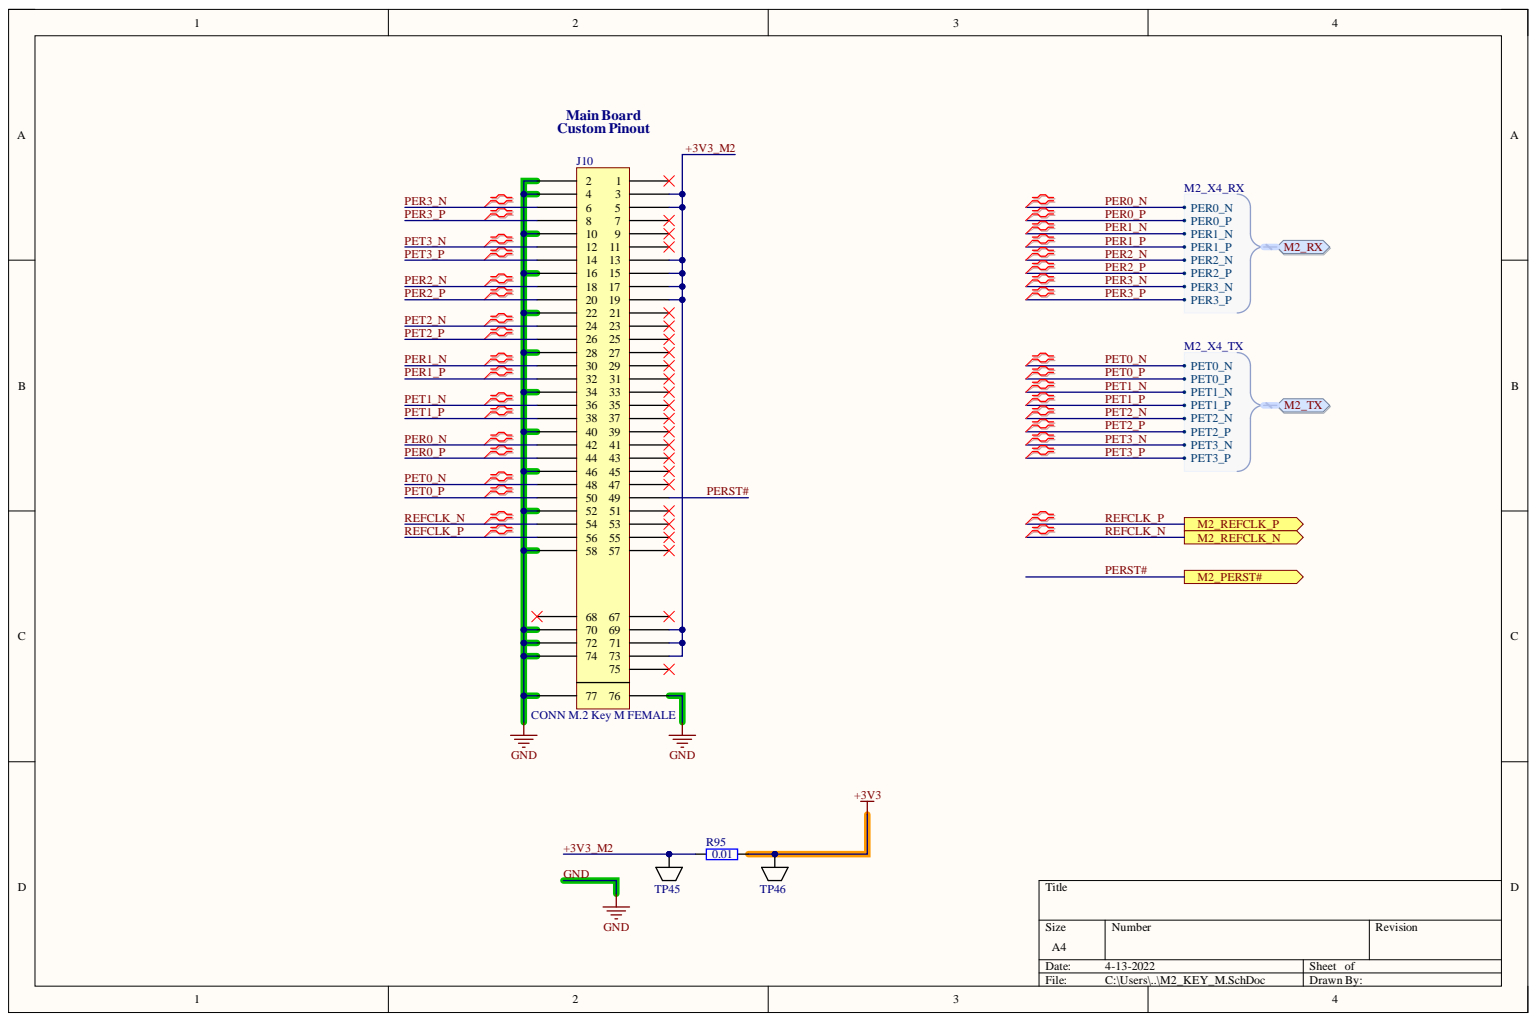
[picture p61: page 6]

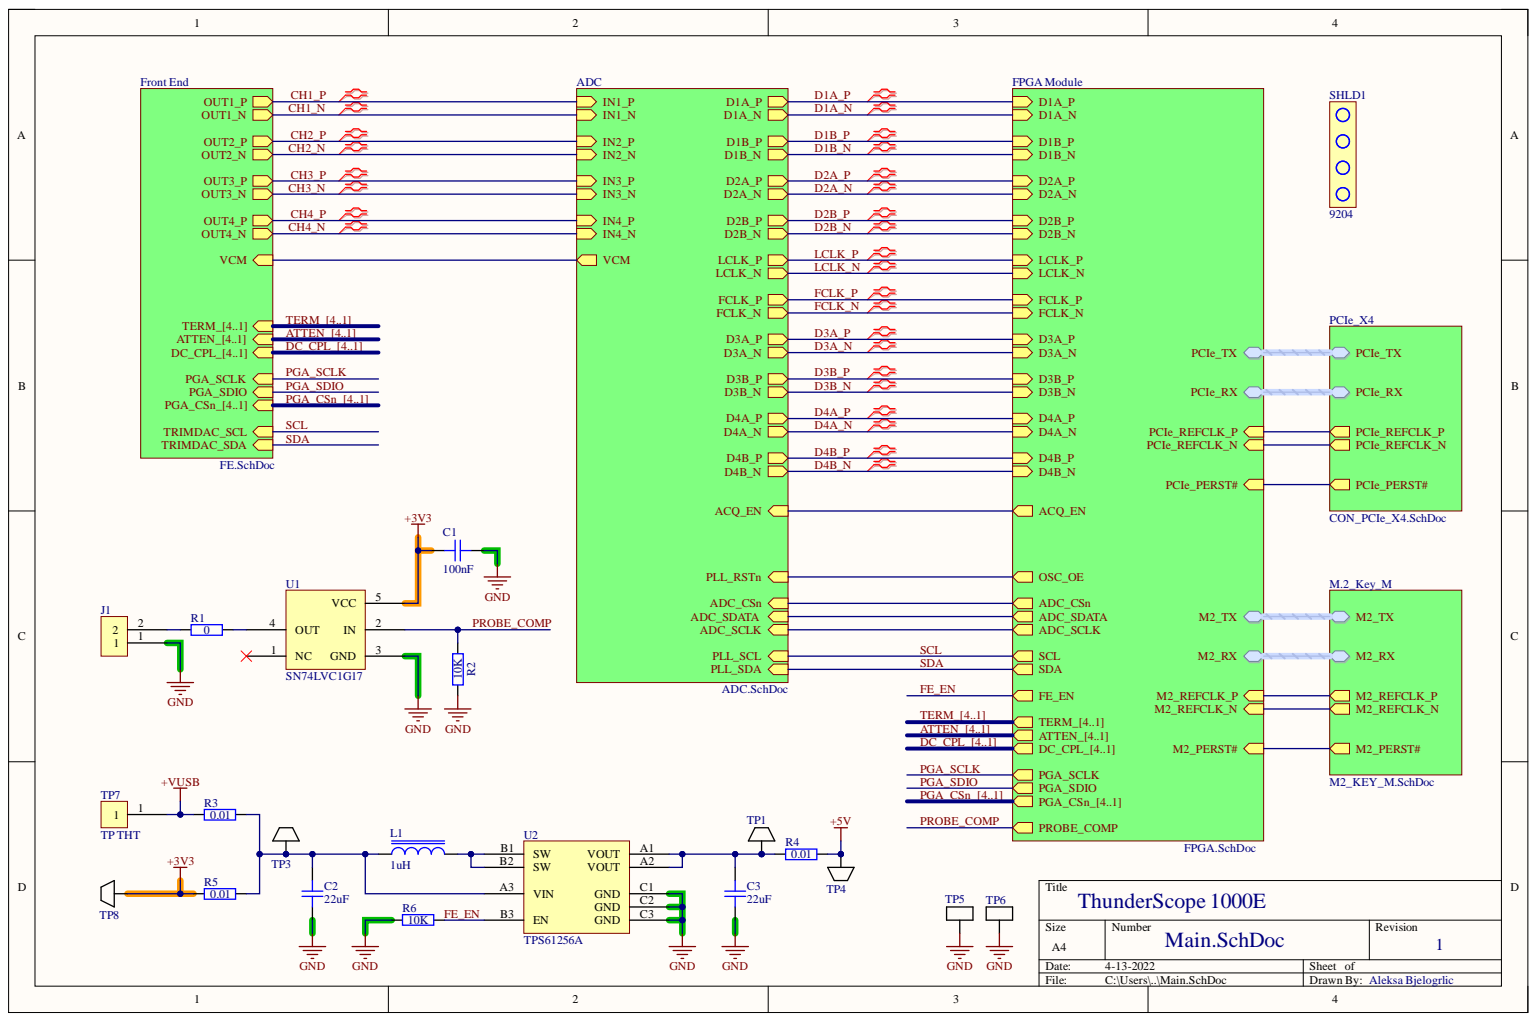
[picture p62: page 7]

CH2_P | D1B_P
CH2_N | D1B_N

CH3_P | D2A_P
CH3_N | D2A_N

CH4_P | D2B_P
CH4_N | D2B_N

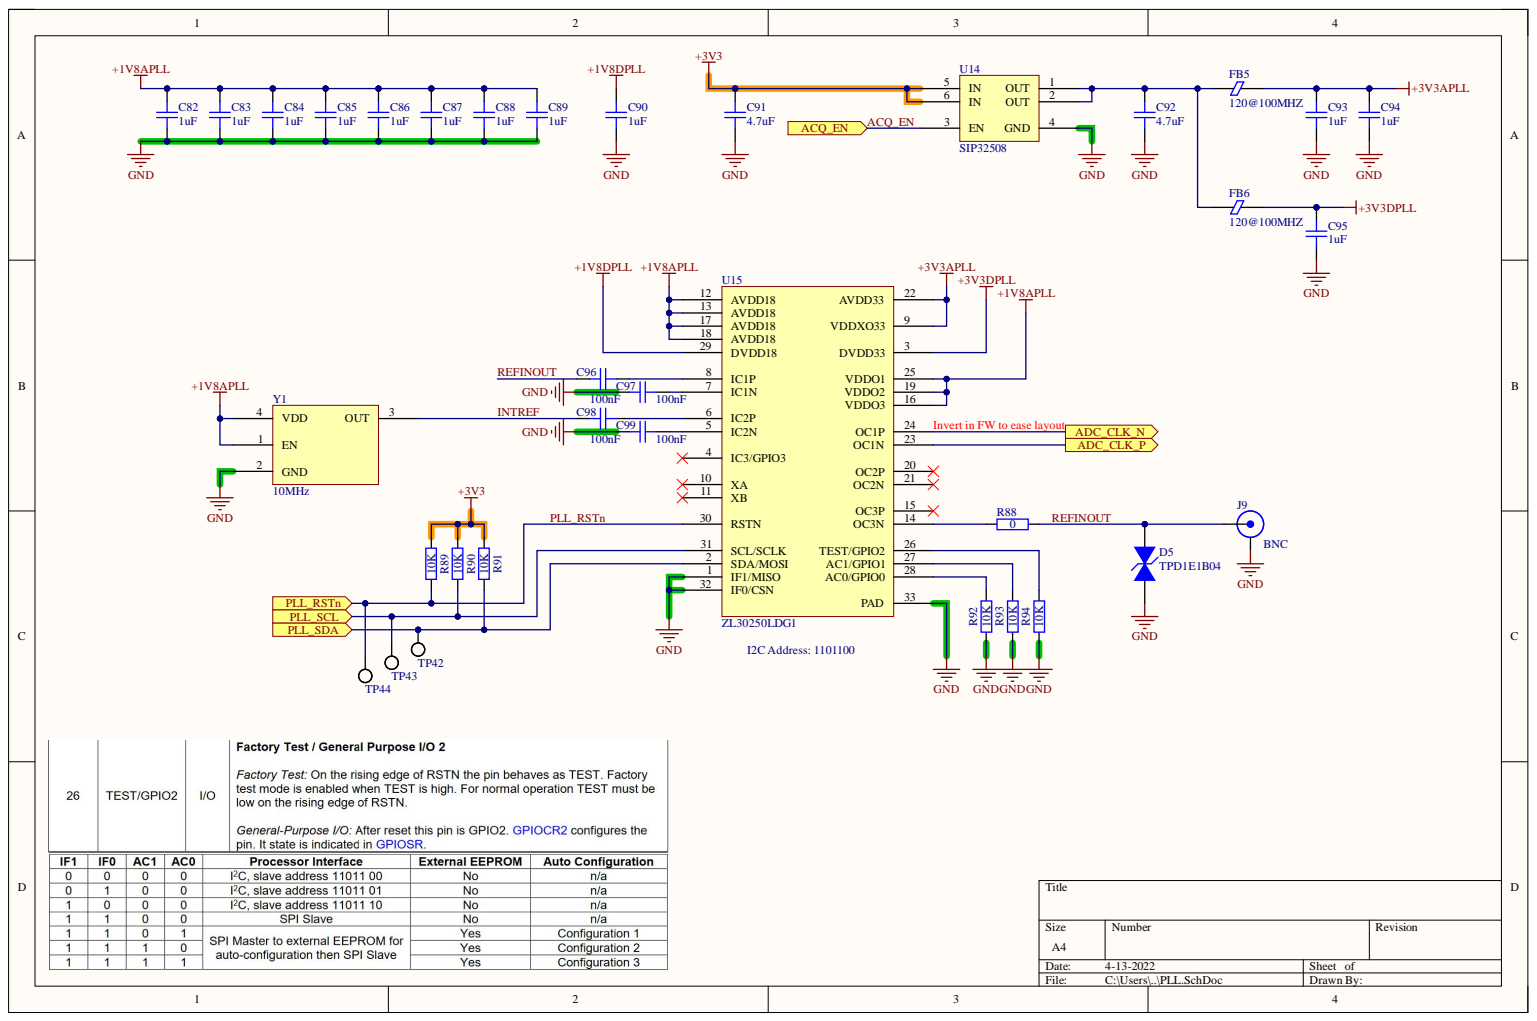
[picture p63: page 8]

AVDD18 13

AVDD18 18

Invert in FW to ease layout

IF1/MISO 1 SDA/MOSI 2

IF0/CSN 32
