EEVengers/ts_hardware_archive/Altium/Thunderscope_Rev3/Thunderscope_Rev3.pdf

# +1V8A 100 R⁵⁷ 100 R⁶⁰ 100 R⁶² 100 R⁶³

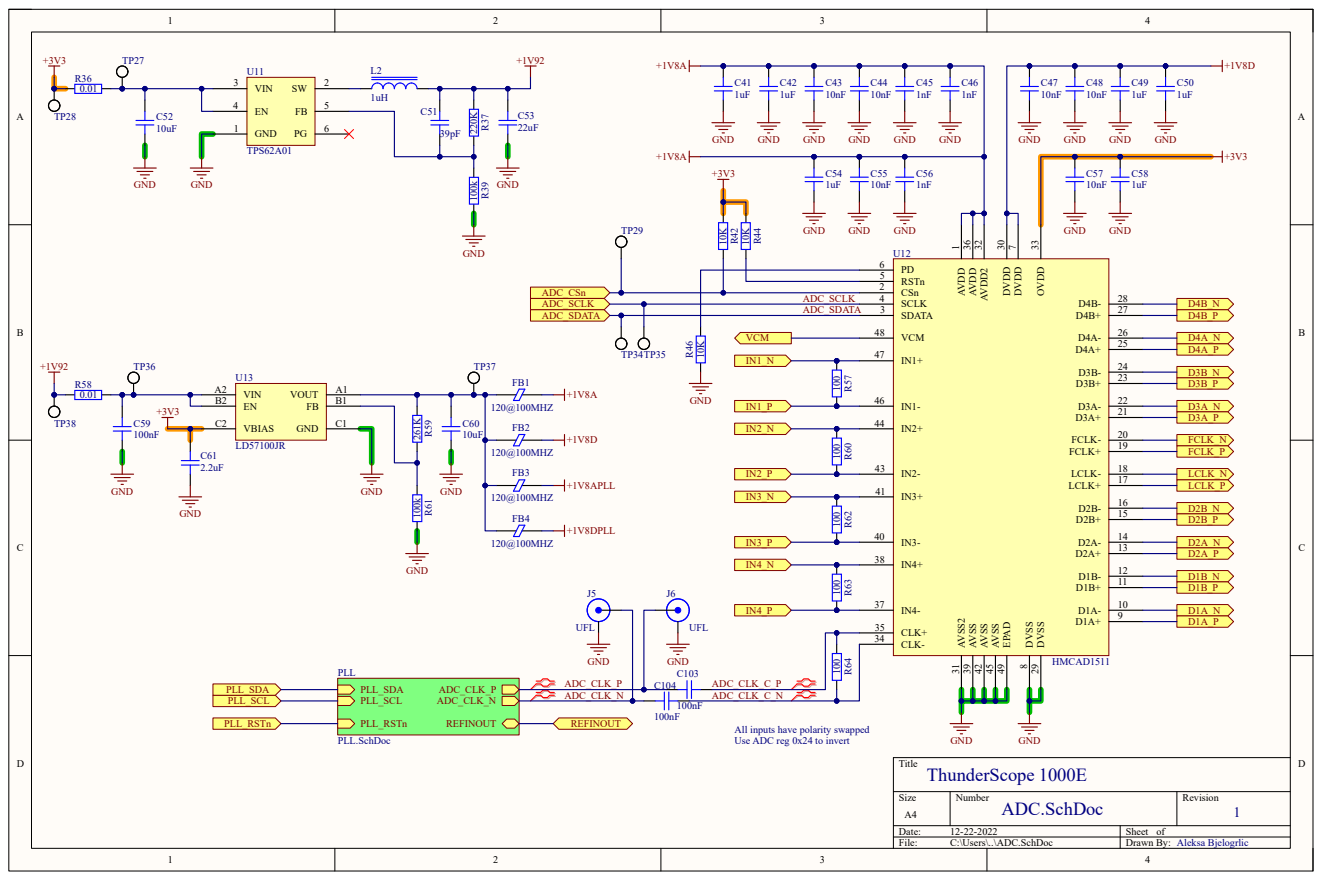
[picture p64: page 1]

All inputs have polarity swapped
Use ADC reg 0x24 to invert

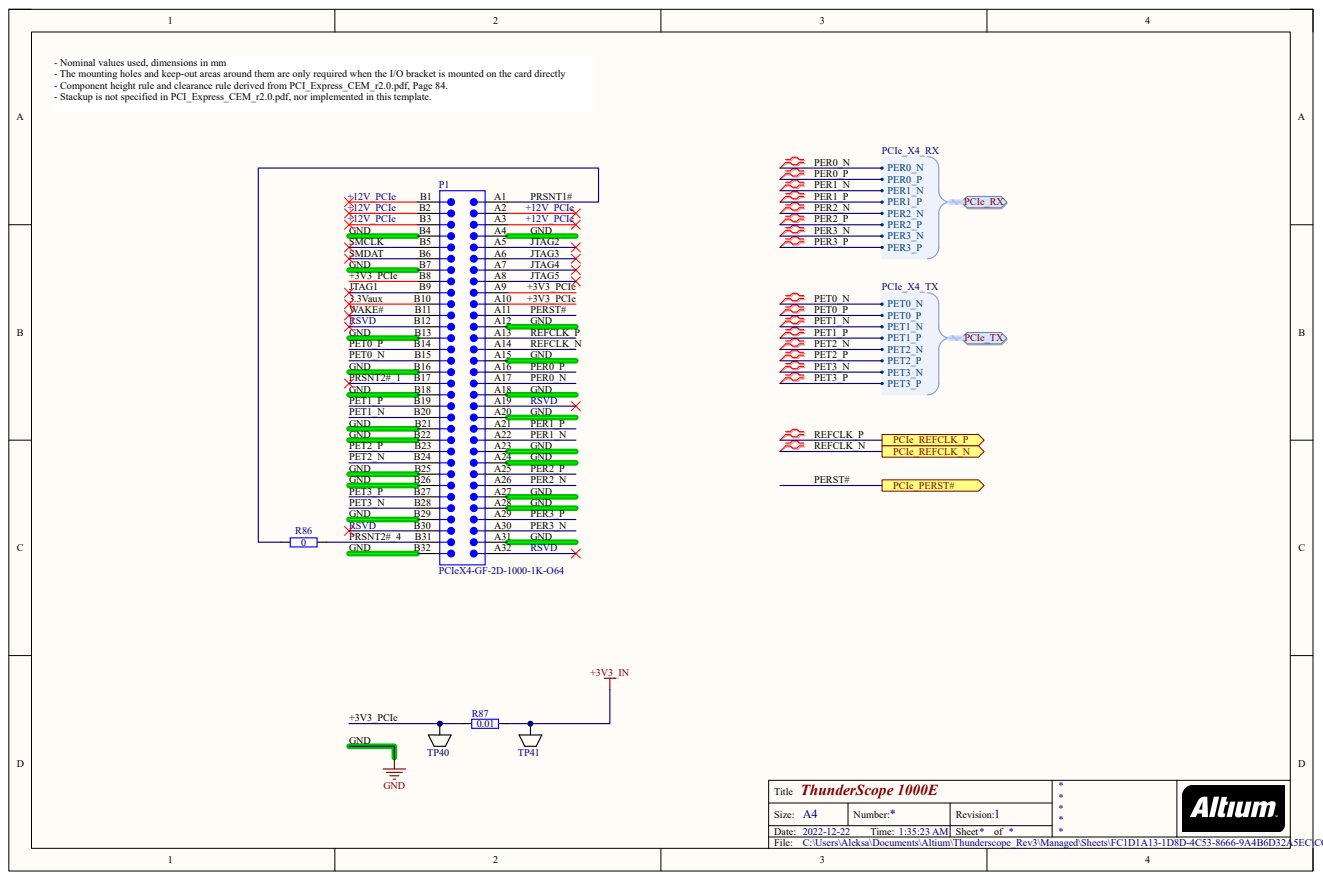
[picture p65: page 2]
Size:; Number:; Date: File:; Revision:; Time:; Sheet; PRSNT1#; GND JTAG2 JTAG3 JTAG4 JTAG5; PERST# GND; GND PER0_P PER0_N GND; GND PER1_P PER1_N GND GND PER2_P PER2_N GND GND PER3_P PER3_N GND; GND SMCLK SMDAT GND; JTAG1 3.3Vaux WAKE#; GND PET0_P PET0_N GND PRSNT2#_1 GND PET1_P PET1_N GND GND PET2_P PET2_N GND GND PET3_P PET3_N GND; PRSNT2#_4 GND; RSVD; PET0_N PET0_P PET1_N PET1_P PET2_N PET2_P PET3_N PET3_P; PER0_N PER0_P PER1_N PER1_P PER2_N PER2_P PER3_N PER3_P; GND; +3V3_PCIe; REFCLK_N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

- Nominal values used, dimensions in mm
- The mounting holes and keep-out areas around them are only required when the I/O bracket is mounted on the card directly
- Component height rule and clearance rule derived from PCI_Express_CEM_r2.0.pdf, Page 84.
- Stackup is not specified in PCI_Express_CEM_r2.0.pdf, nor implemented in this template.

ThunderScope 1000E
Title
C:\Users\Aleksa\Documents\Altium\Thunderscope_Rev3\Managed\Sheets\FC1D1A13-1D8D-4C53-8666-9A4B6D32A5EC\CON_PCIe_X4.SchDoc

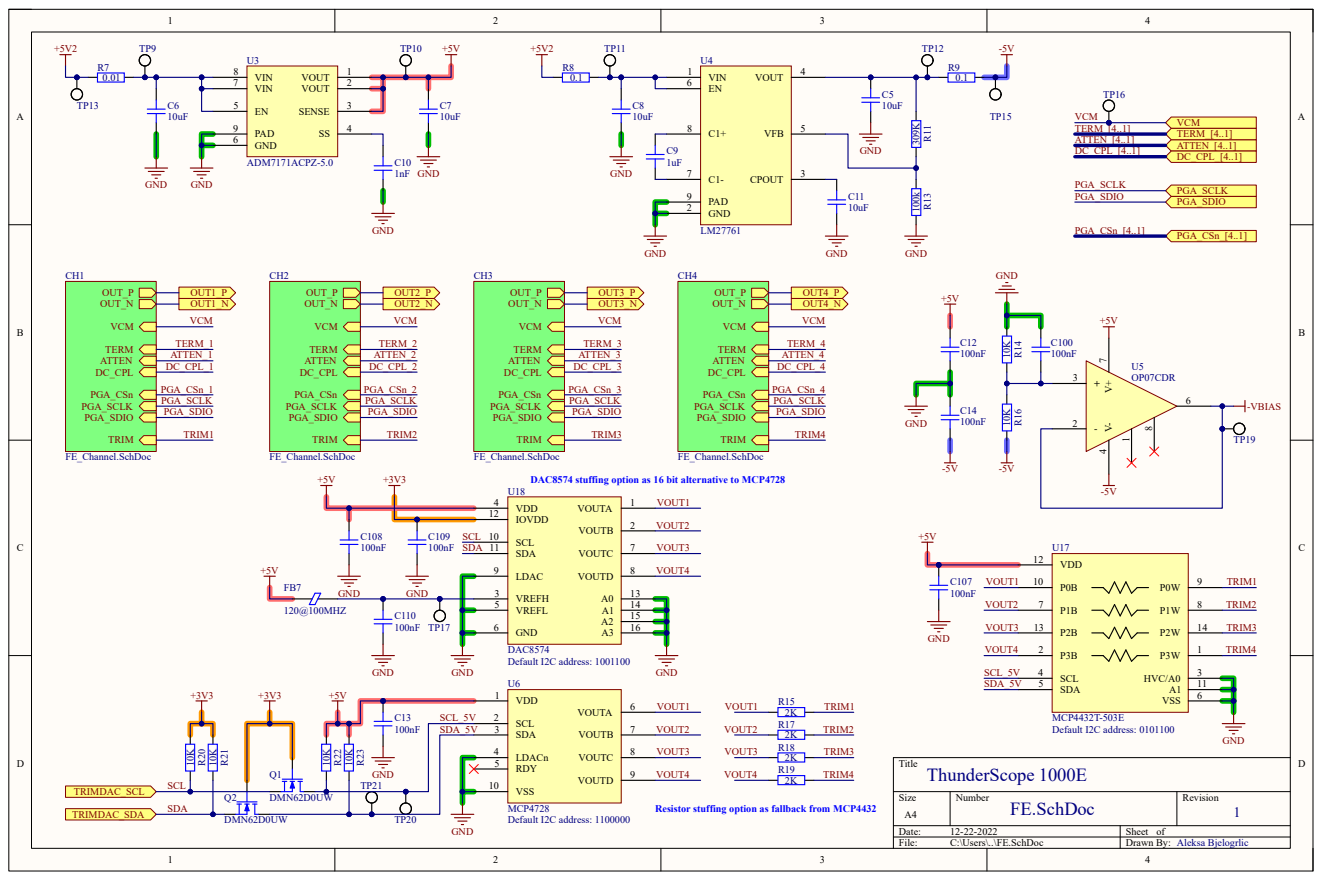
[picture p66: page 3]

DAC8574 stuffing option as 16 bit alternative to MCP4728
VDD 4
IOVDD 12

Resistor stuffing option as fallback from MCP4432

# 22nF 1KR³⁵

# Also try 20 ohm R65 & R45 R⁹⁷ 1K R⁹⁸ 1K

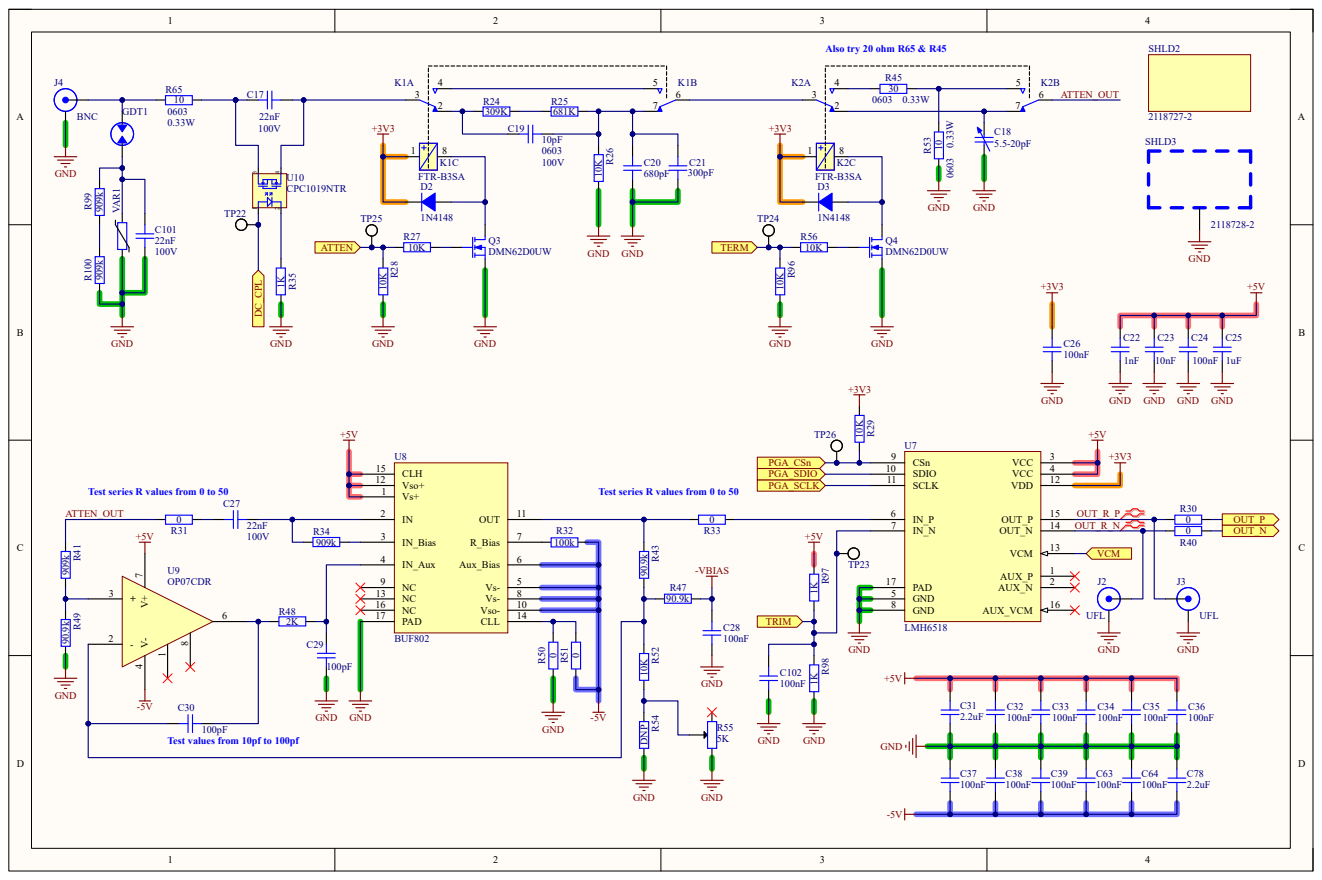
[picture p67: page 4]

GND GND

## DONE: Backwards compatibility with TE0712

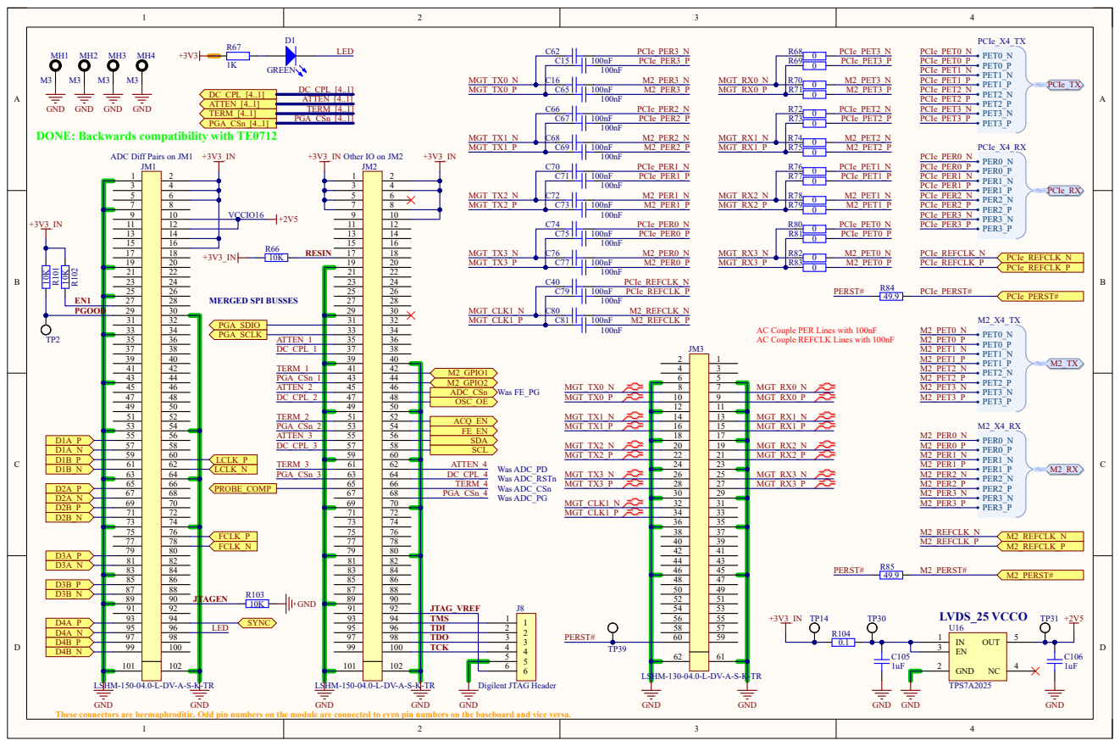
[picture p68: page 5]

GND GND

PGOOD ¹⁰K R¹⁰¹ ¹⁰K R¹⁰²

AC Couple PER Lines with 100nF
AC Couple REFCLK Lines with 100nF

These connectors are hermaphroditic. Odd pin numbers on the module are connected to even pin numbers on the baseboard and vice versa.

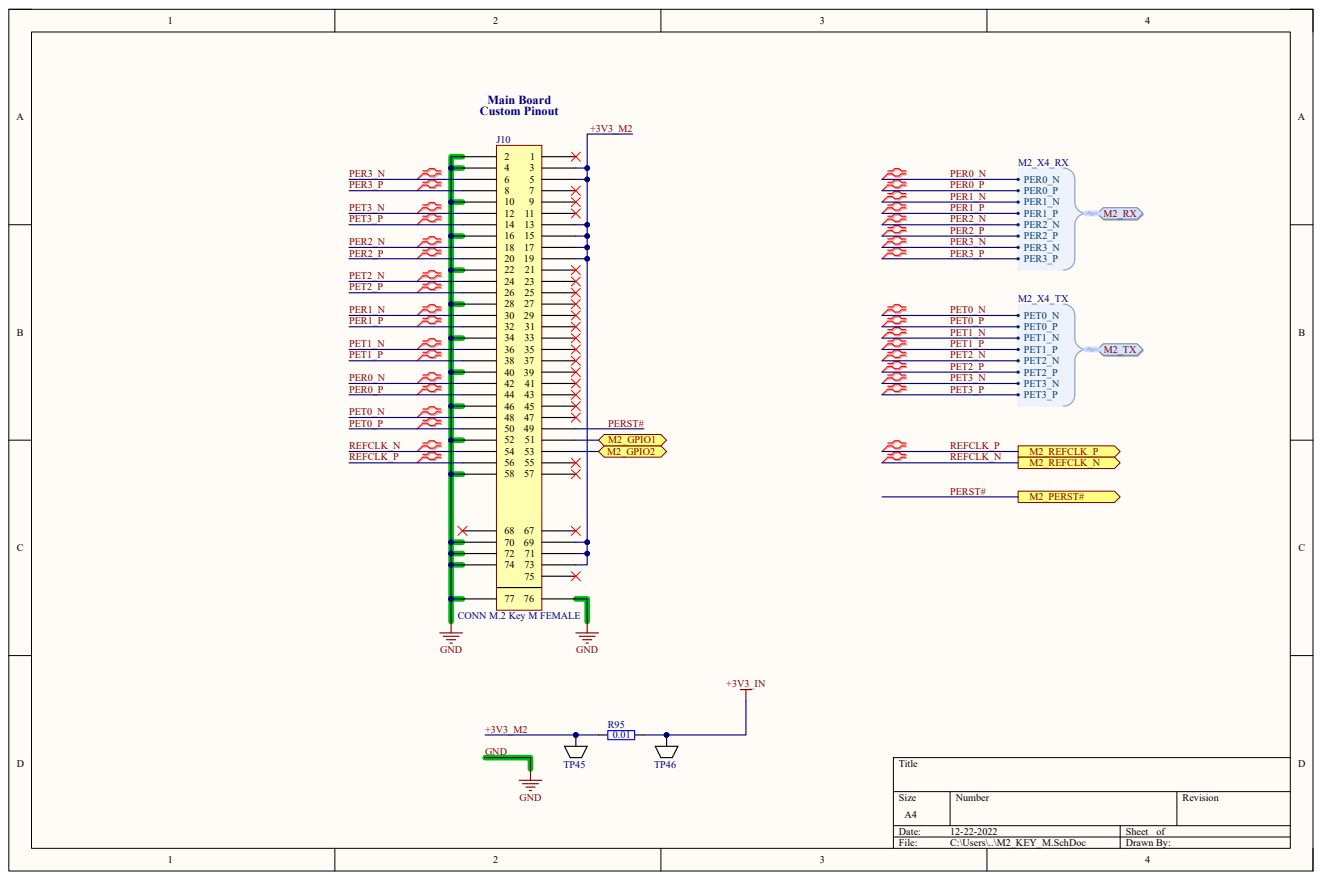
[picture p69: page 6]
Title; Size; Number; Revision; File:; C:\Users\..\M2_KEY_M.SchDoc; Drawn By:; PET0_N PET0_P PET1_N PET1_P PET2_N PET2_P PET3_N PET3_P; PER0_N PER0_P PER1_N PER1_P PER2_N PER2_P PER3_N PER3_P; GND; REFCLK_N; REFCLK_P; PERST#; M2_REFCLK_P M2_REFCLK_N; M2_PERST#; Main Board Custom Pinout; REFCLK_N REFCLK_P; PER3_N PER3_P; PET3_N PET3_P; PER2_N PER2_P; PET2_N PET2_P; PER1_N PER1_P; PET1_N PET1_P; PER0_N PER0_P; PET0_N PET0_P; M2_GPIO2; M2_GPIO1

CONN M.2 Key M FEMALE

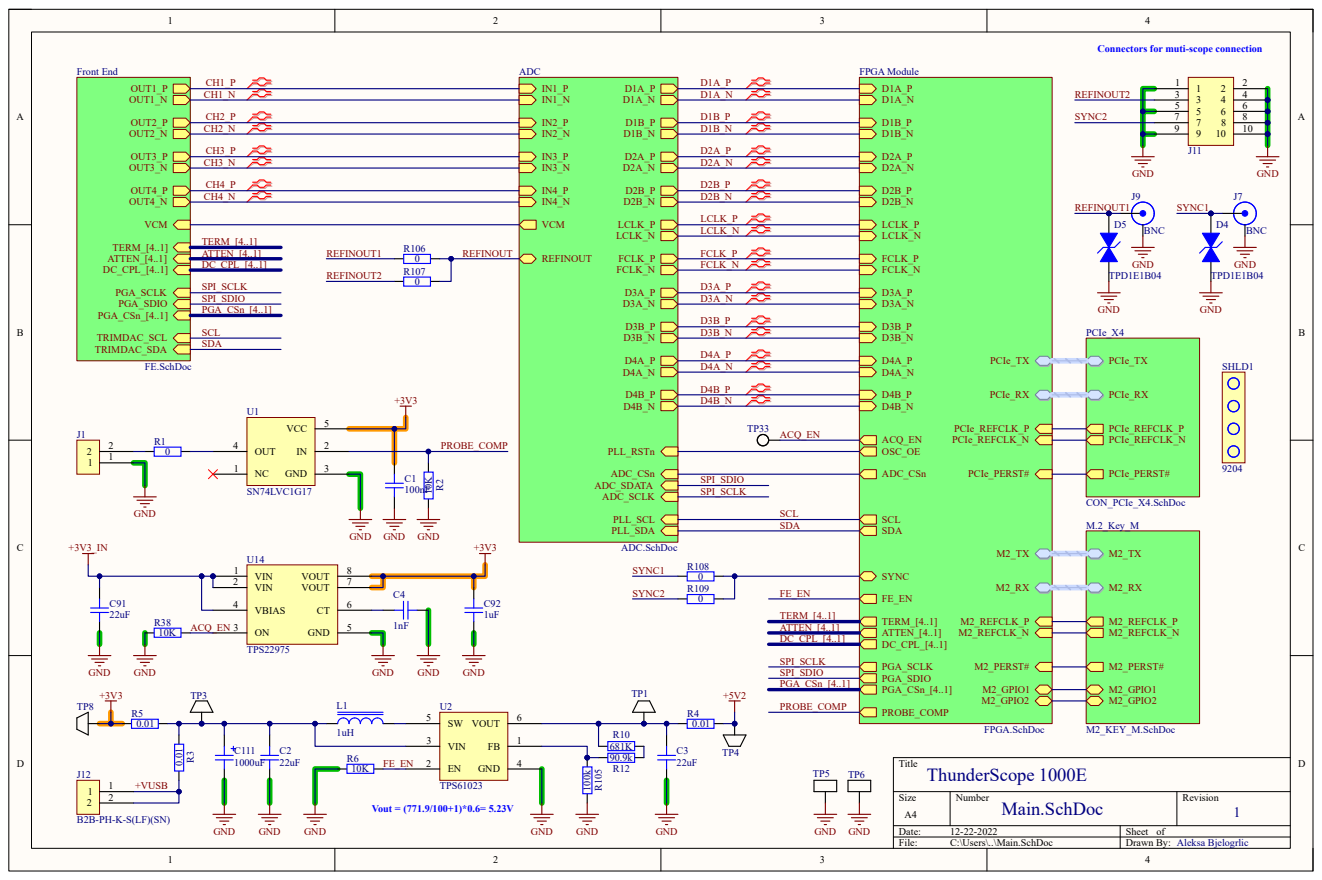
[picture p70: page 7]

Connectors for muti-scope connection

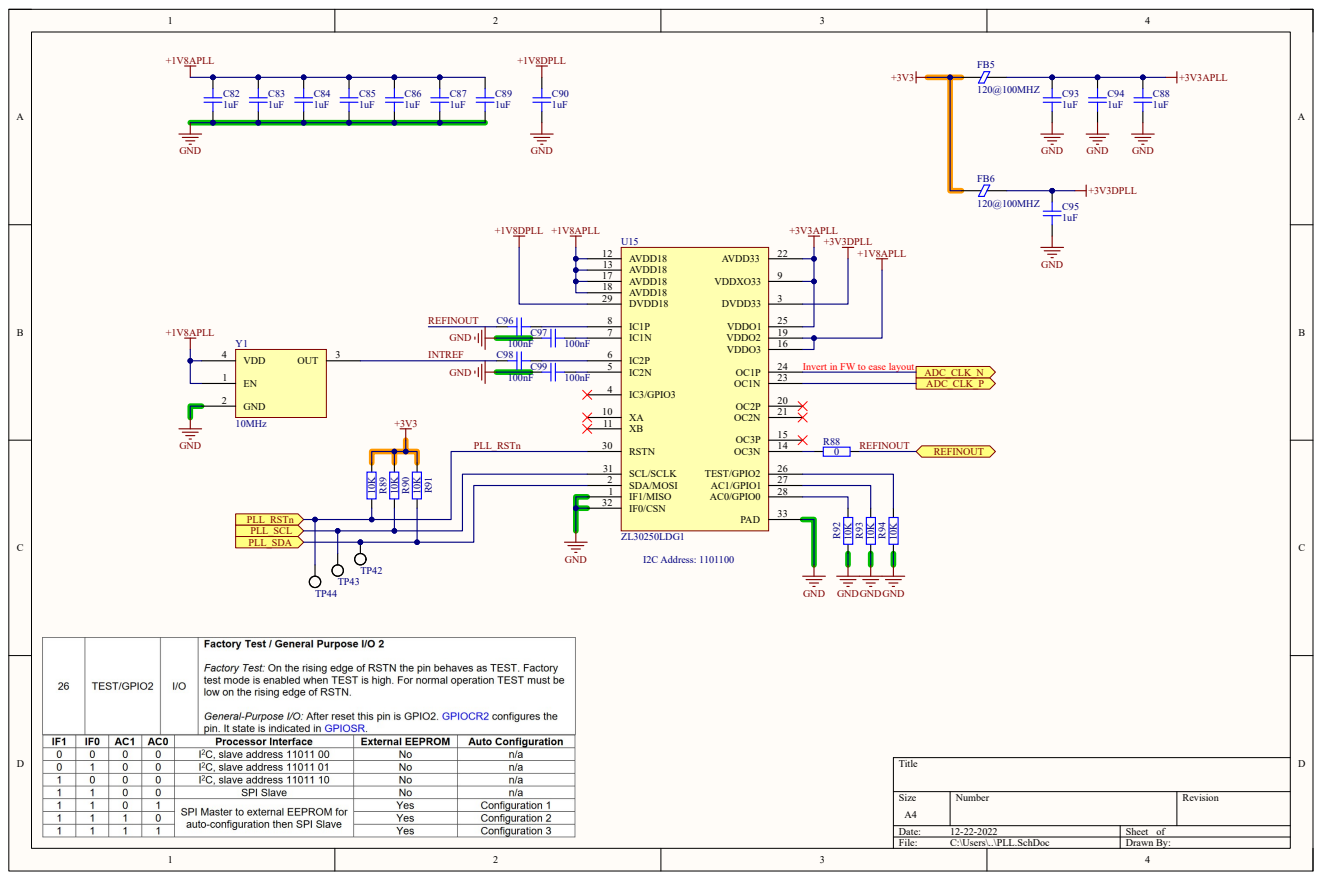
[picture p71: page 8]

Invert in FW to ease layout
