EEVengers/ts_hardware_archive/Altium/Thunderscope_Rev4.1/Thunderscope_Rev4.1.pdf

# +1V8A 100 R⁵⁷ 100 R⁶⁰ 100 R⁶² 100 R⁶³

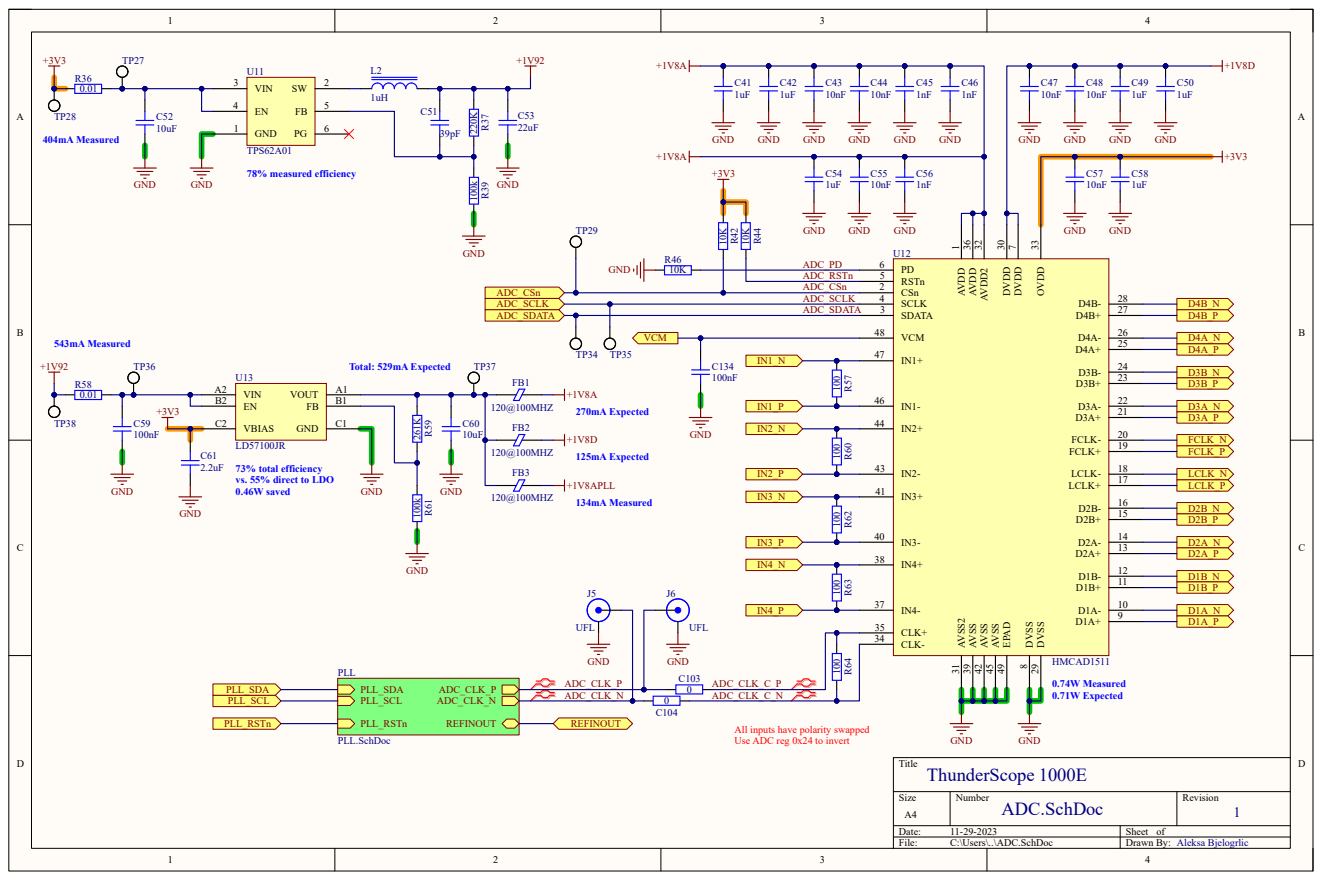
[picture p72: page 1]

73% total efficiency
vs. 55% direct to LDO
0.46W saved

All inputs have polarity swapped
Use ADC reg 0x24 to invert

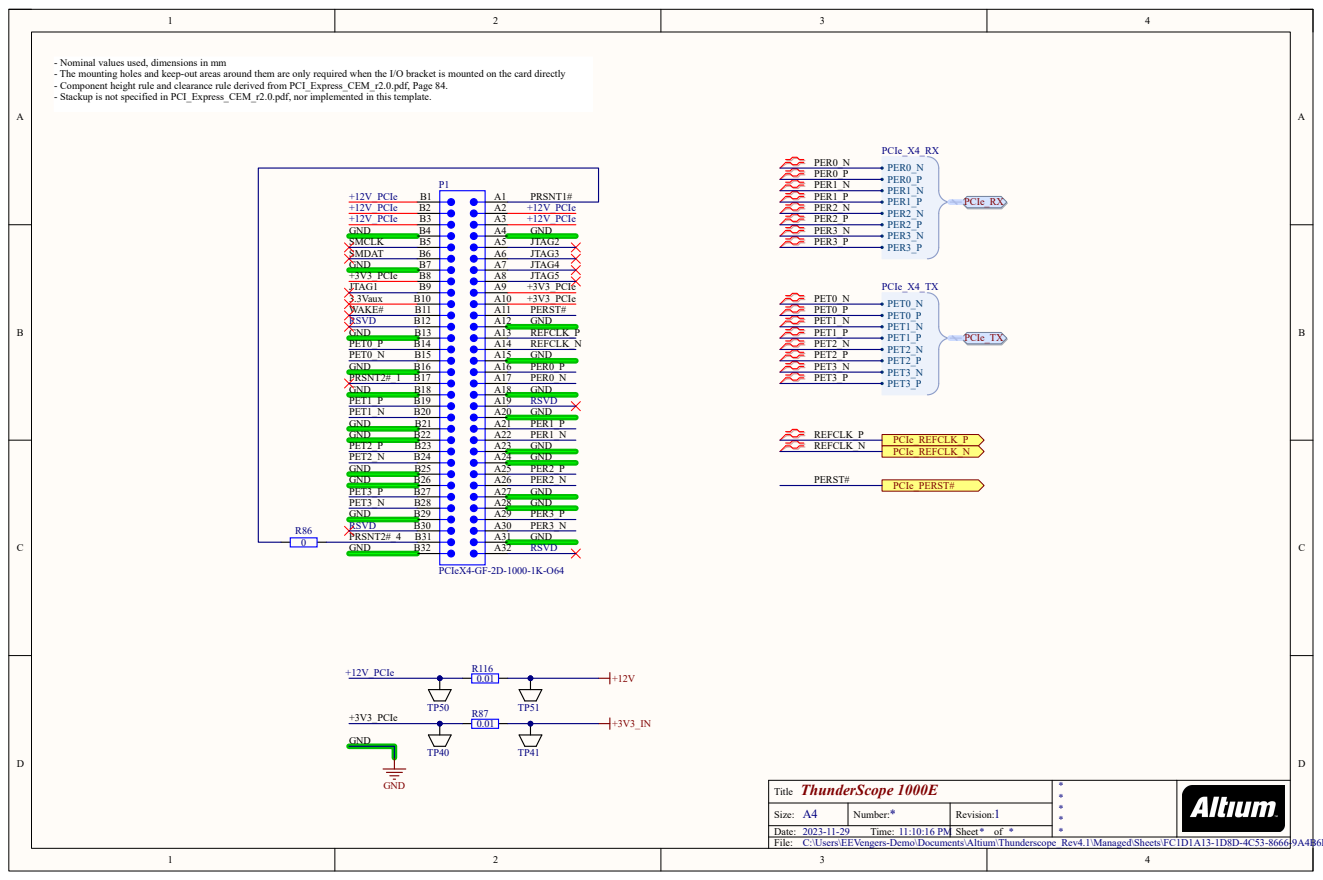
[picture p73: page 2]

- Nominal values used, dimensions in mm
- The mounting holes and keep-out areas around them are only required when the I/O bracket is mounted on the card directly
- Component height rule and clearance rule derived from PCI_Express_CEM_r2.0.pdf, Page 84.
- Stackup is not specified in PCI_Express_CEM_r2.0.pdf, nor implemented in this template.

ThunderScope 1000E
Title
C:\Users\EEVengers-Demo\Documents\Altium\Thunderscope_Rev4.1\Managed\Sheets\FC1D1A13-1D8D-4C53-8666-9A4B6D32A5EC\CON_PCIe_X4.SchDoc

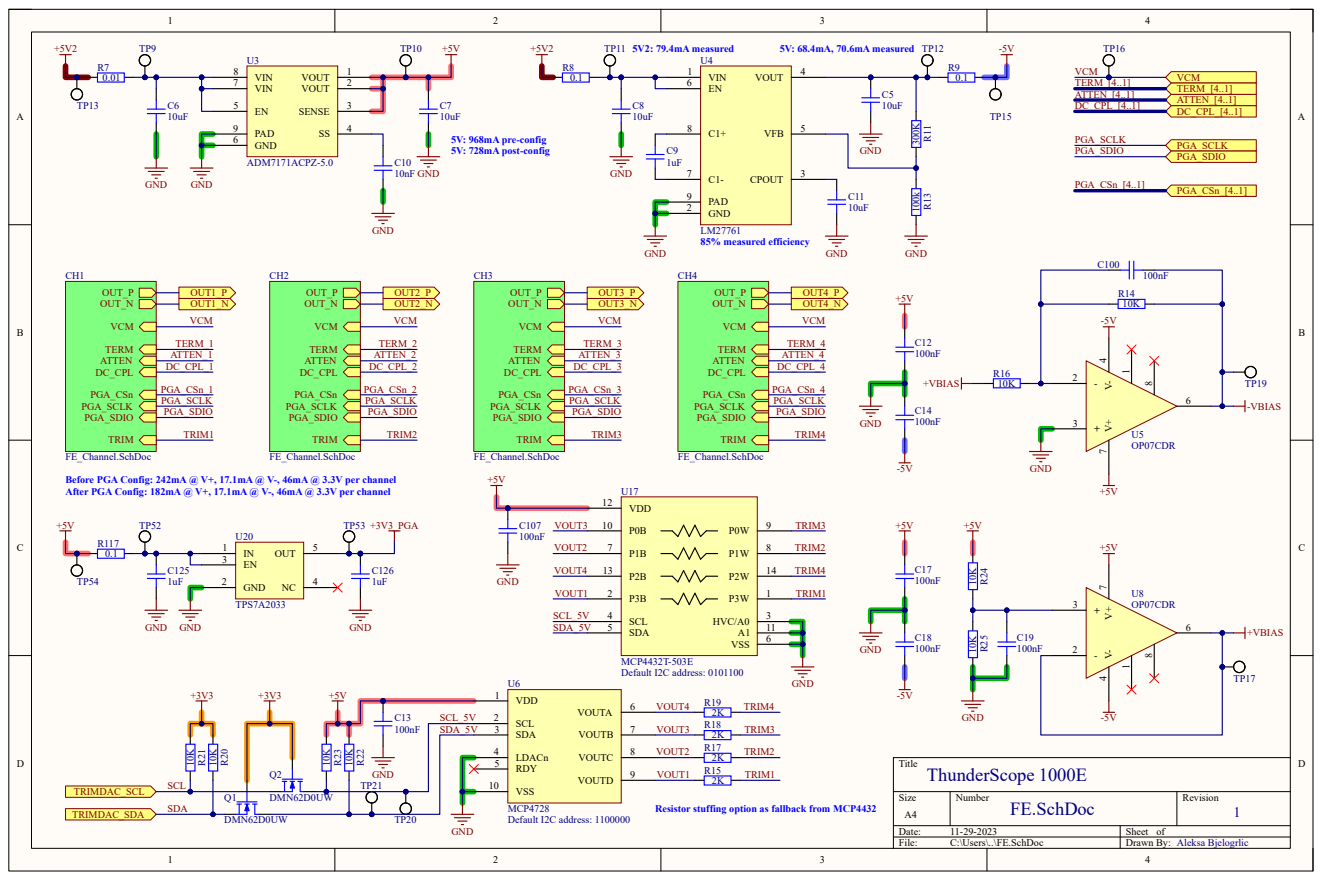
[picture p74: page 3]

Before PGA Config: 242mA @ V+, 17.1mA @ V-, 46mA @ 3.3V per channel
After PGA Config: 182mA @ V+, 17.1mA @ V-, 46mA @ 3.3V per channel

Resistor stuffing option as fallback from MCP4432

# GND C²³ (C²³A, ...) 240pF

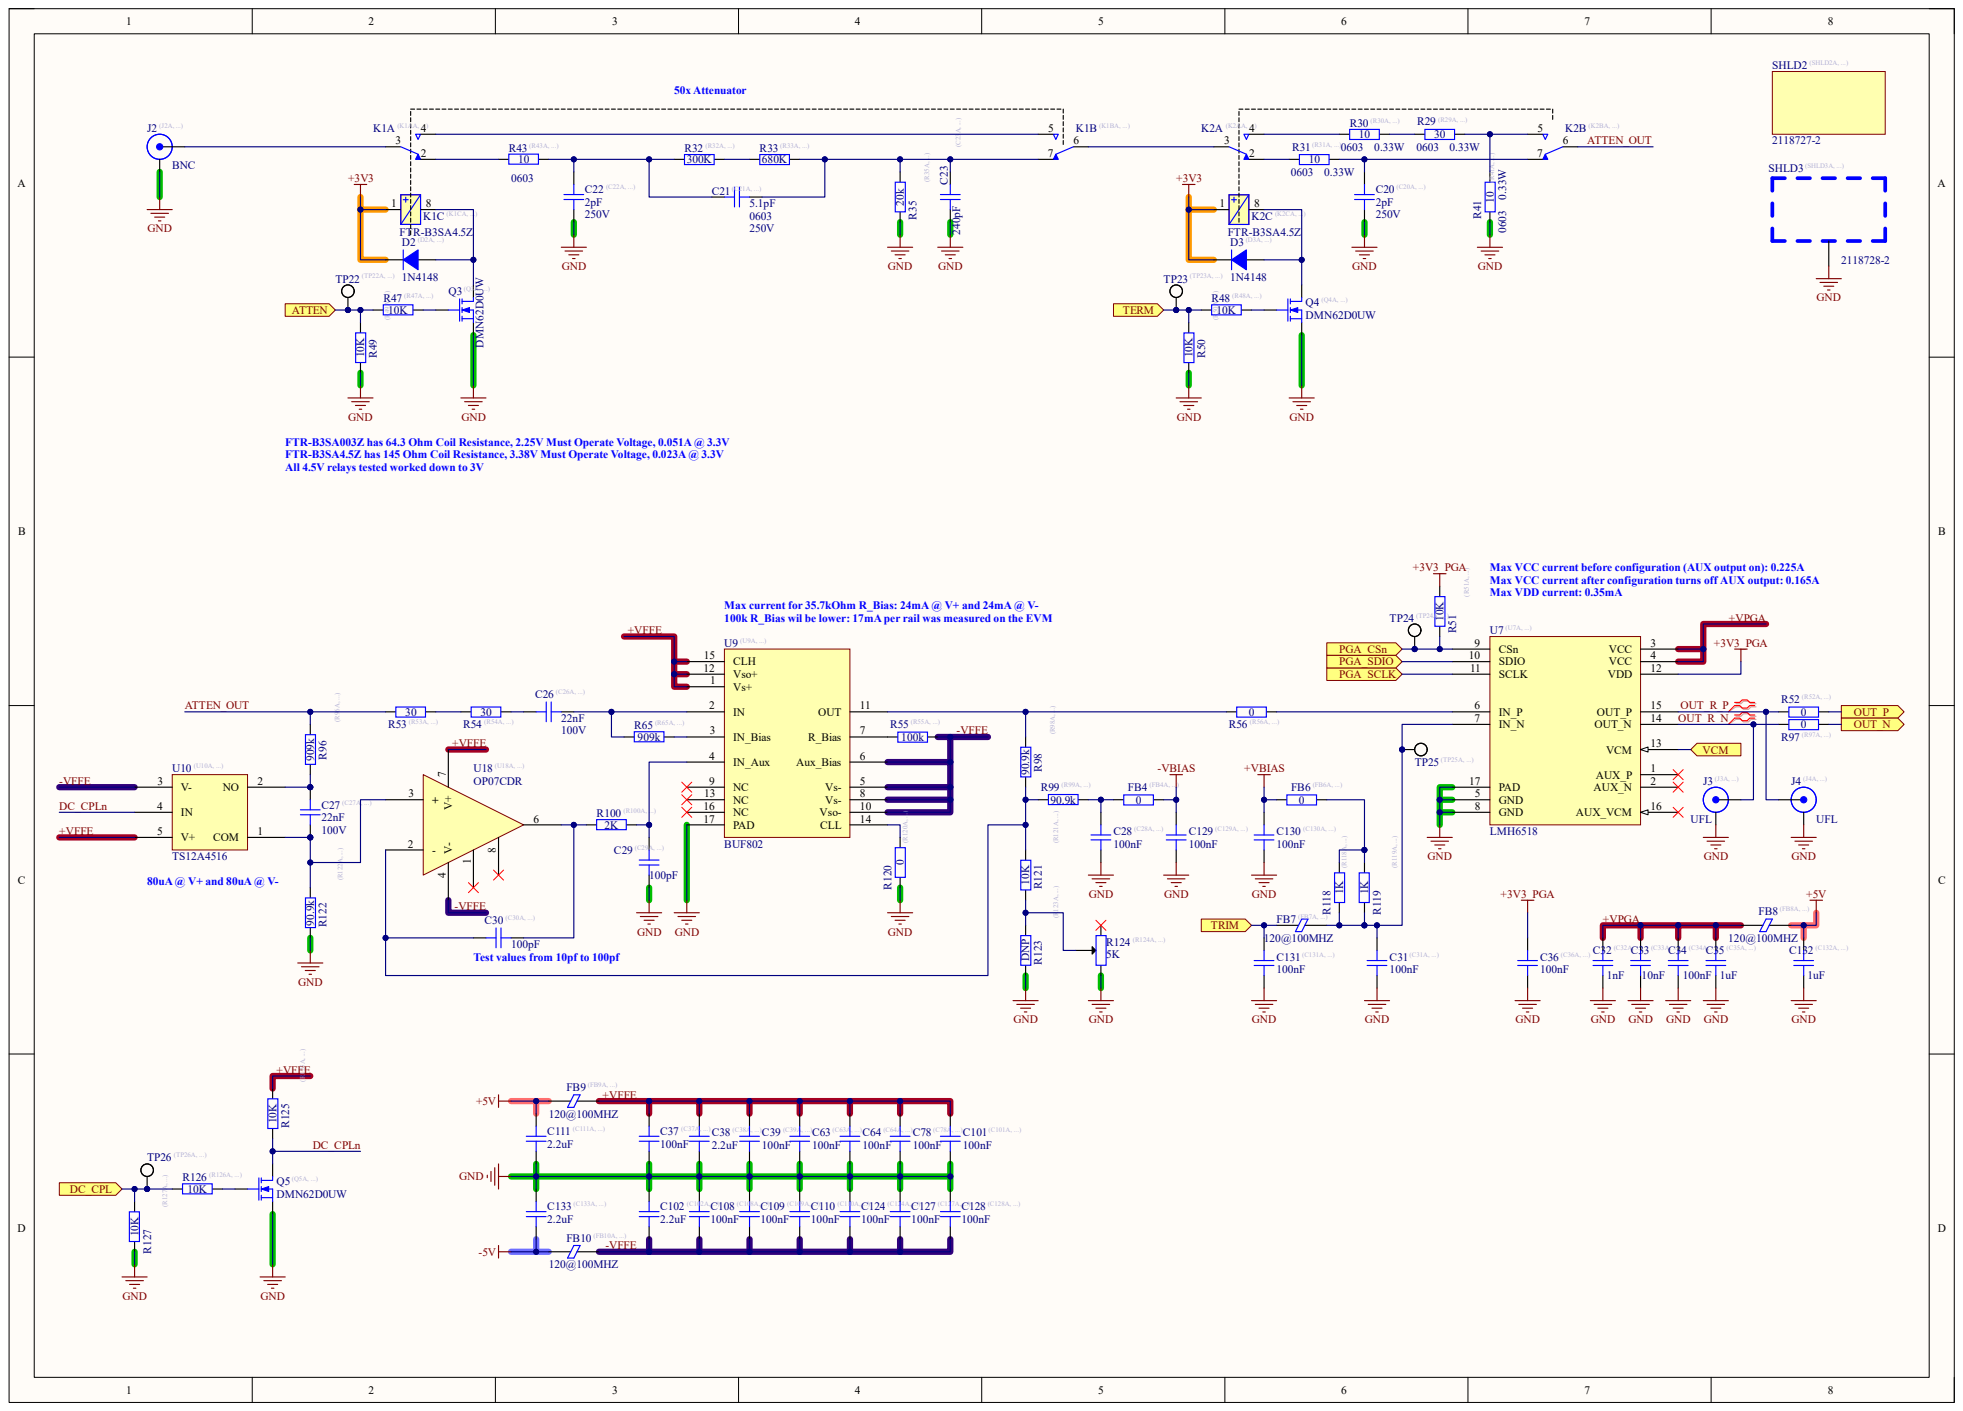
[picture p75: page 4]

FTR-B3SA003Z has 64.3 Ohm Coil Resistance, 2.25V Must Operate Voltage, 0.051A @ 3.3V
FTR-B3SA4.5Z has 145 Ohm Coil Resistance, 3.38V Must Operate Voltage, 0.023A @ 3.3V
All 4.5V relays tested worked down to 3V

Max VCC current before configuration (AUX output on): 0.225A
Max VCC current after configuration turns off AUX output: 0.165A
Max VDD current: 0.35mA

Max current for 35.7kOhm R_Bias: 24mA @ V+ and 24mA @ V-
100k R_Bias wil be lower: 17mA per rail was measured on the EVM

GND R¹²³ (R¹²³A, ...) DNP

Test values from 10pf to 100pf R¹²⁵ (R¹²⁵A, ...) 10K

GND GND

## DONE: Backwards compatibility with TE0712

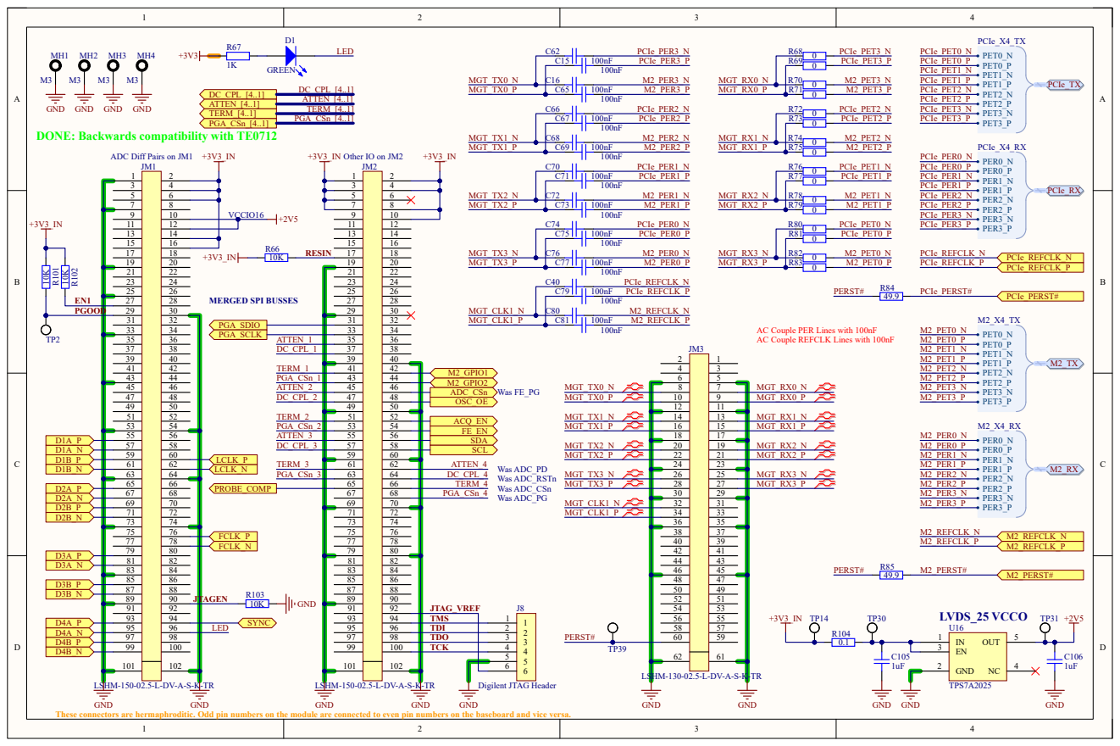
[picture p76: page 5]

GND GND

PGOOD ¹⁰K R¹⁰¹ ¹⁰K R¹⁰²

AC Couple PER Lines with 100nF
AC Couple REFCLK Lines with 100nF

These connectors are hermaphroditic. Odd pin numbers on the module are connected to even pin numbers on the baseboard and vice versa.

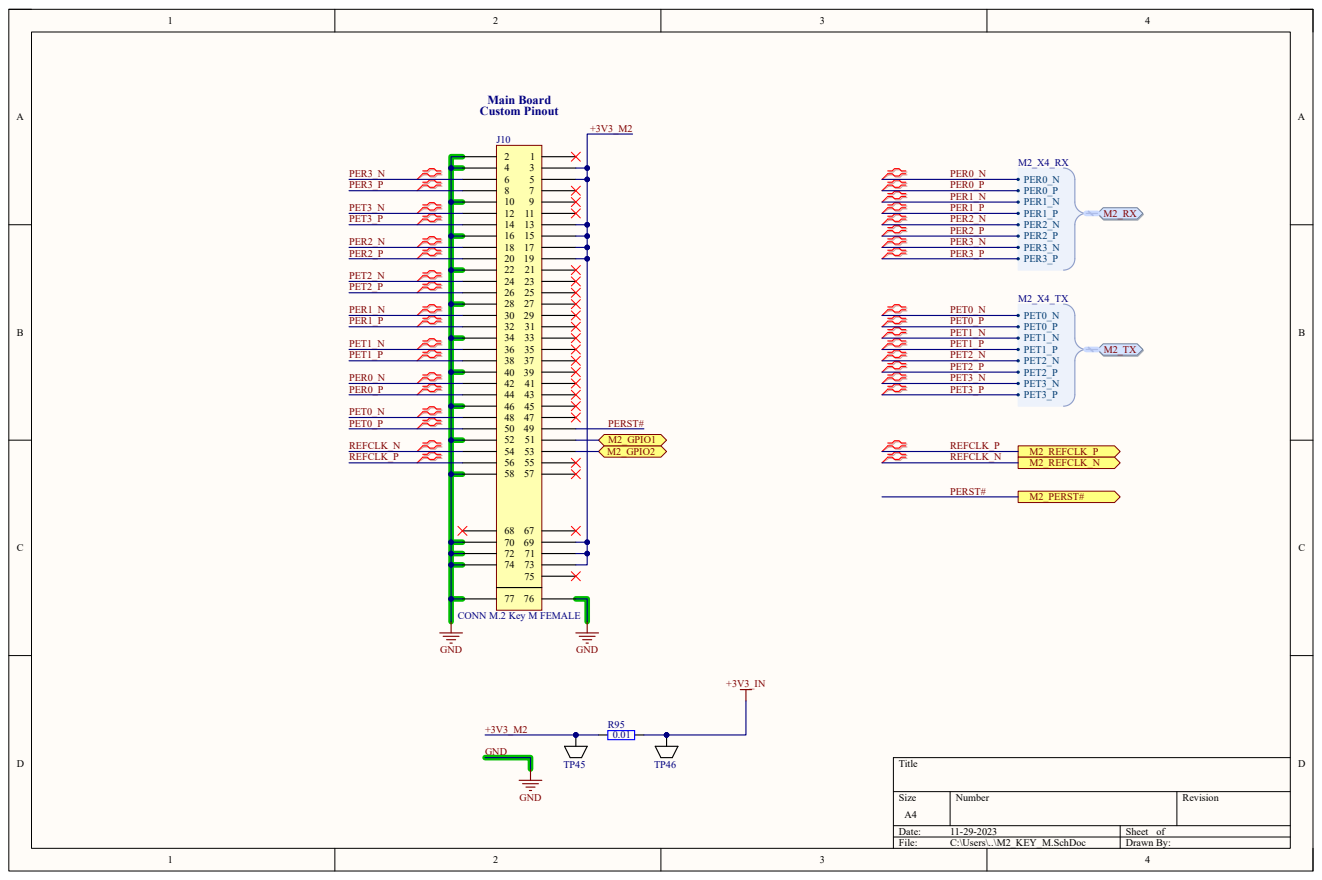
[picture p77: page 6]
Title; Size; Number; Revision; File:; C:\Users\..\M2_KEY_M.SchDoc; Drawn By:; PET0_N PET0_P PET1_N PET1_P PET2_N PET2_P PET3_N PET3_P; PER0_N PER0_P PER1_N PER1_P PER2_N PER2_P PER3_N PER3_P; GND; REFCLK_N; REFCLK_P; PERST#; M2_REFCLK_P M2_REFCLK_N; M2_PERST#; Main Board Custom Pinout; REFCLK_N REFCLK_P; PER3_N PER3_P; PET3_N PET3_P; PER2_N PER2_P; PET2_N PET2_P; PER1_N PER1_P; PET1_N PET1_P; PER0_N PER0_P; PET0_N PET0_P; M2_GPIO2; M2_GPIO1

CONN M.2 Key M FEMALE

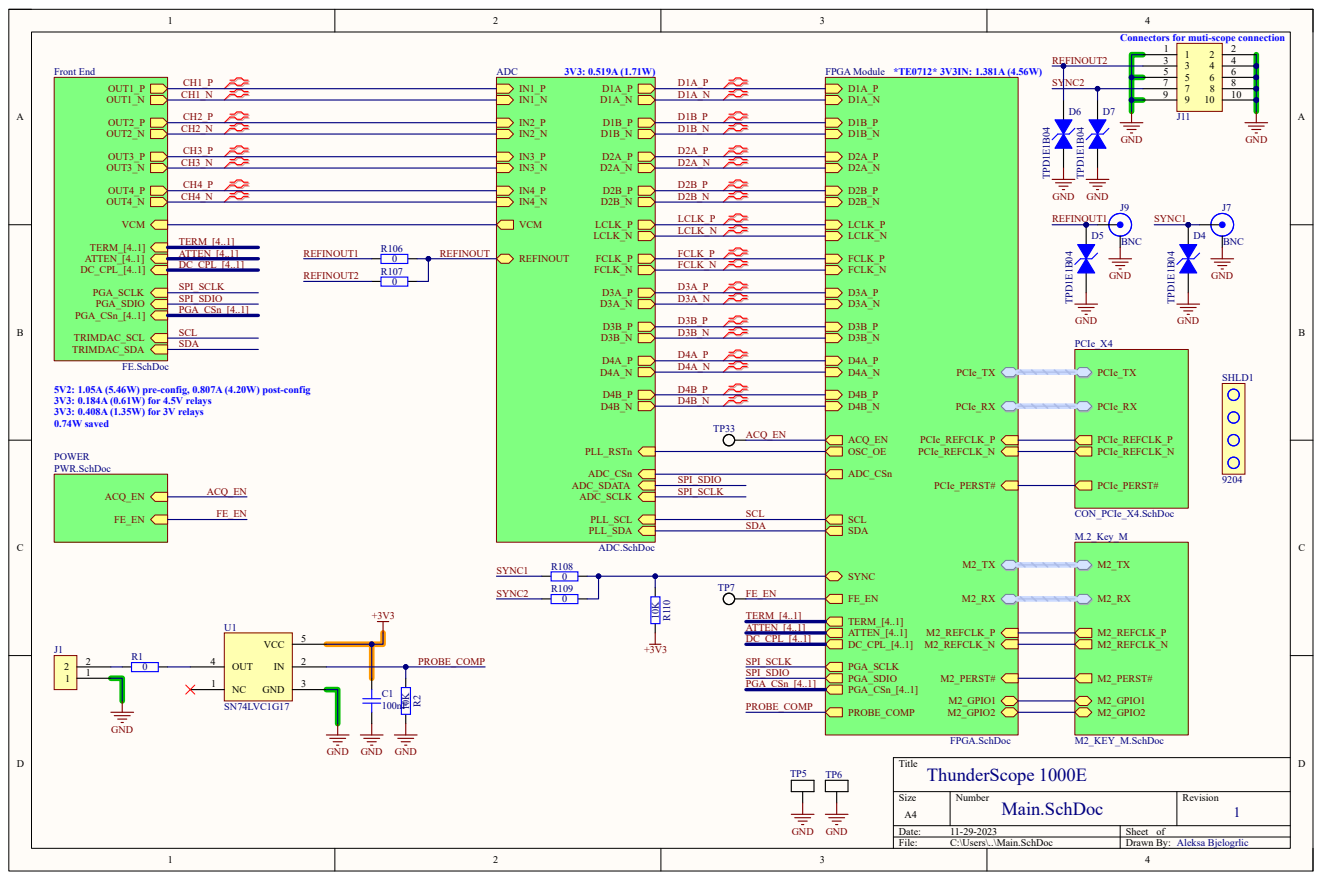
[picture p78: page 7]

Connectors for muti-scope connection

5V2: 1.05A (5.46W) pre-config, 0.807A (4.20W) post-config
3V3: 0.184A (0.61W) for 4.5V relays
3V3: 0.408A (1.35W) for 3V relays
0.74W saved

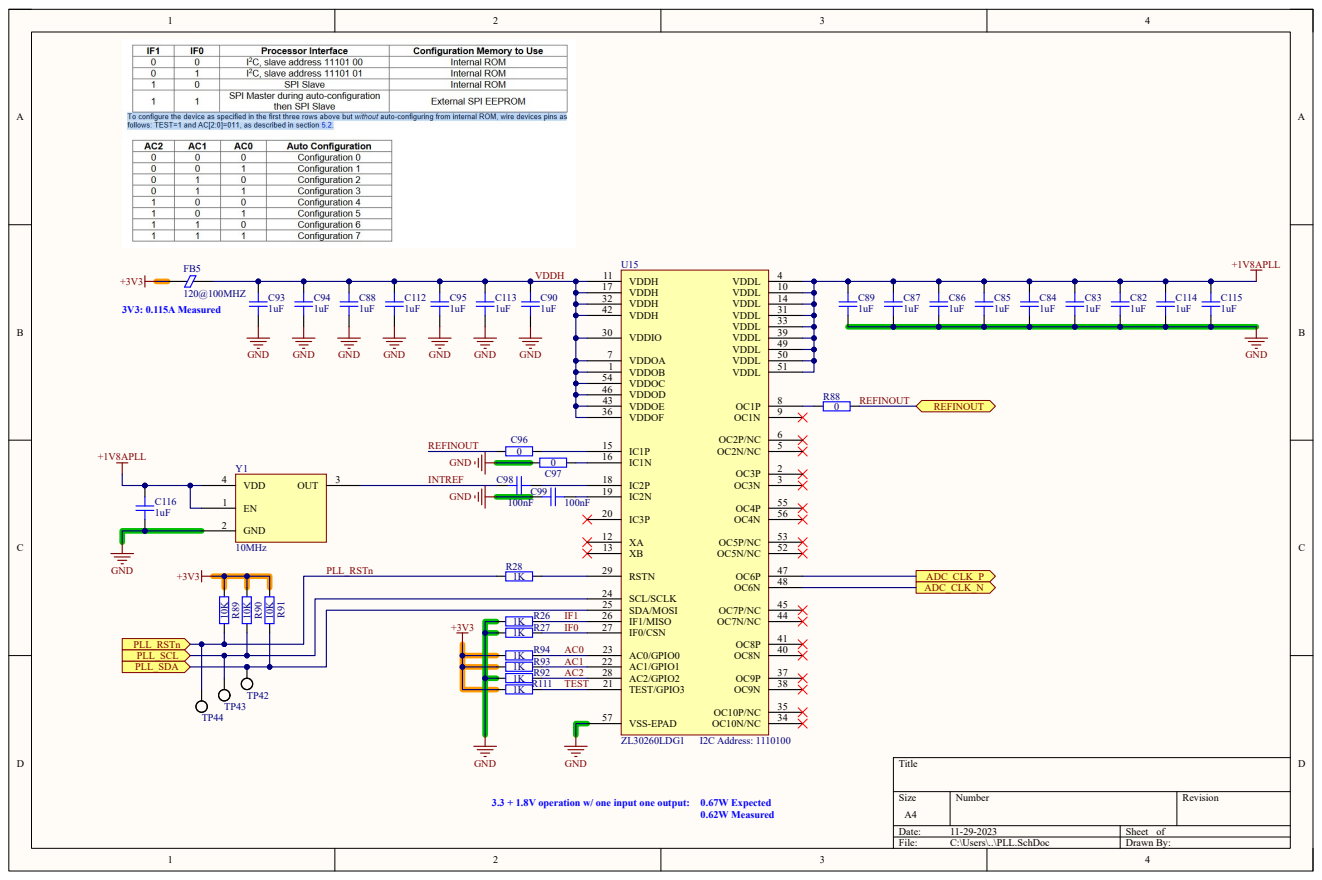
[picture p79: page 8]

3.3 + 1.8V operation w/ one input one output:

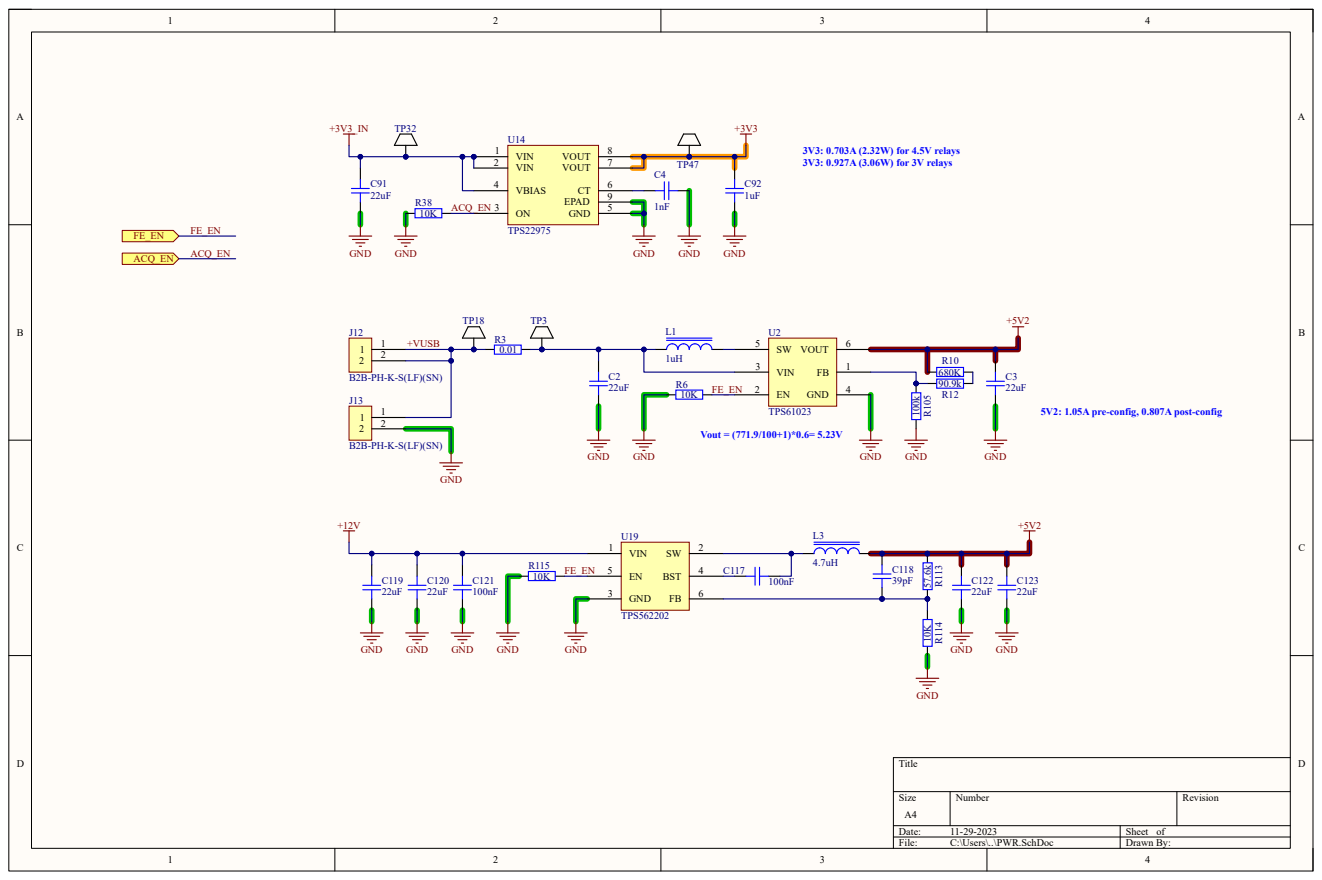
[picture p80: page 9]

5V2: 1.05A pre-config, 0.807A post-config
