EEVengers/ts_hardware_archive/Altium/Thunderscope_Rev4/Thunderscope_Rev4.pdf

# +1V8A 100 R⁵⁷ 100 R⁶⁰ 100 R⁶² 100 R⁶³

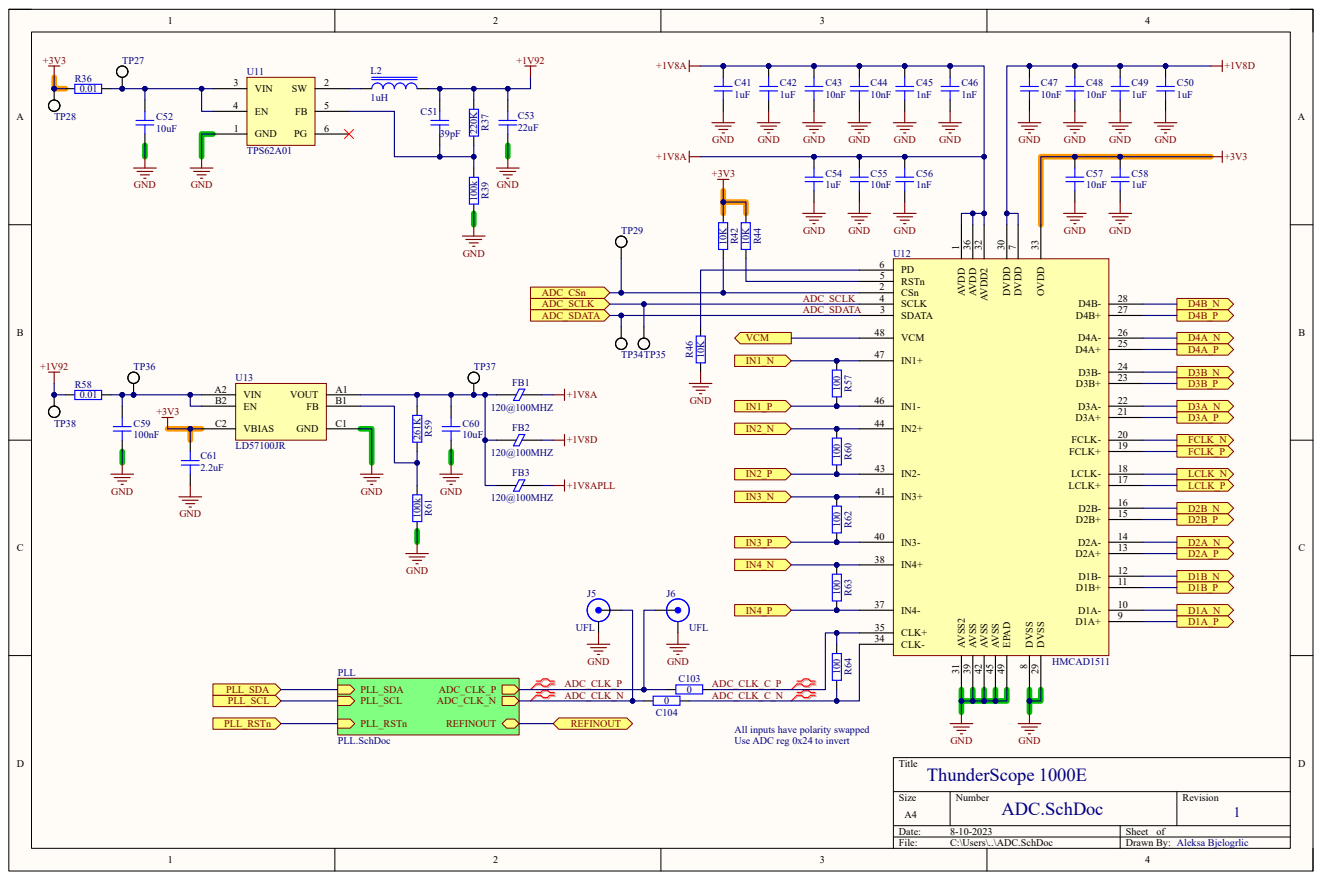
[picture p81: page 1]

All inputs have polarity swapped
Use ADC reg 0x24 to invert

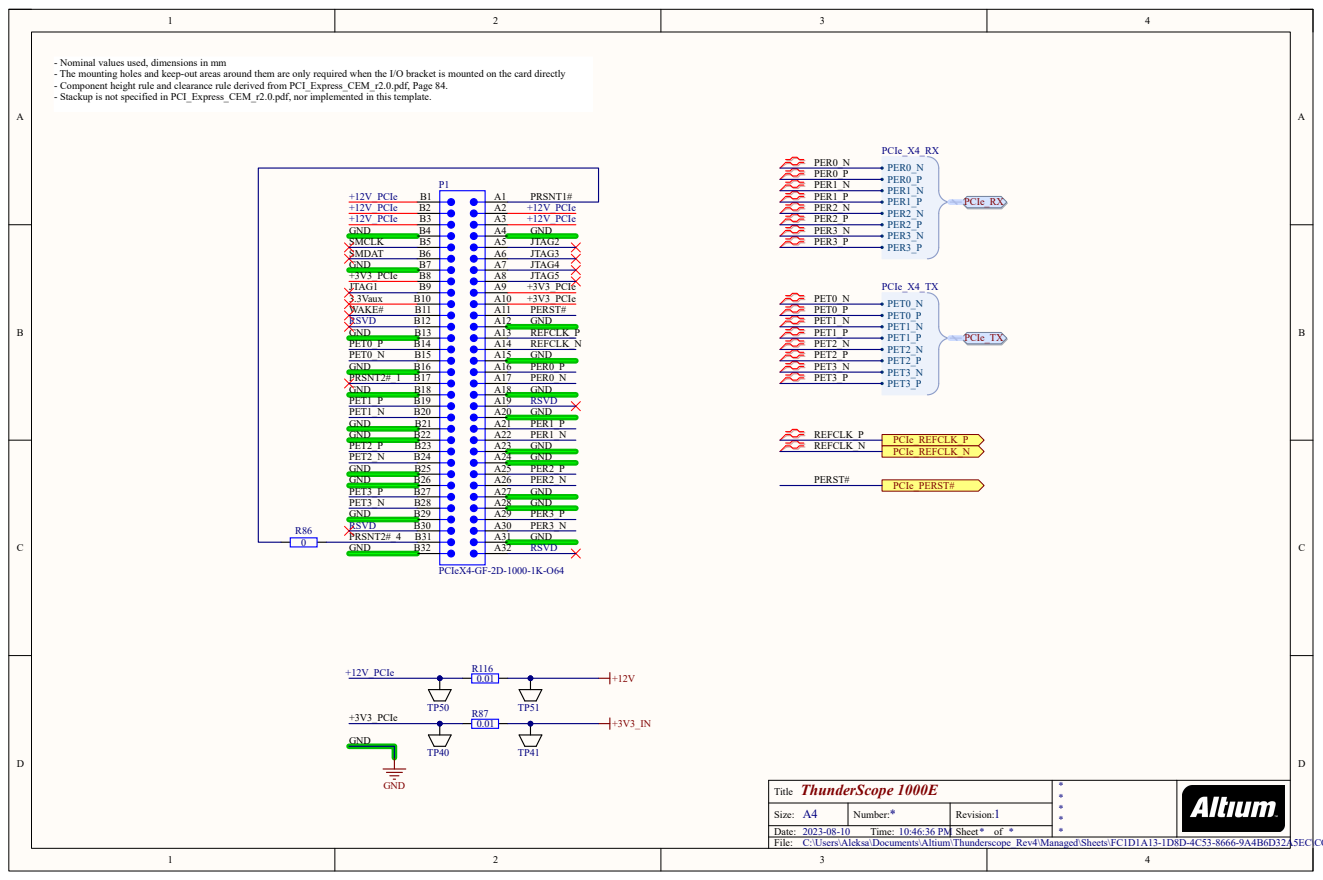
[picture p82: page 2]

- Nominal values used, dimensions in mm
- The mounting holes and keep-out areas around them are only required when the I/O bracket is mounted on the card directly
- Component height rule and clearance rule derived from PCI_Express_CEM_r2.0.pdf, Page 84.
- Stackup is not specified in PCI_Express_CEM_r2.0.pdf, nor implemented in this template.

ThunderScope 1000E
Title
C:\Users\Aleksa\Documents\Altium\Thunderscope_Rev4\Managed\Sheets\FC1D1A13-1D8D-4C53-8666-9A4B6D32A5EC\CON_PCIe_X4.SchDoc

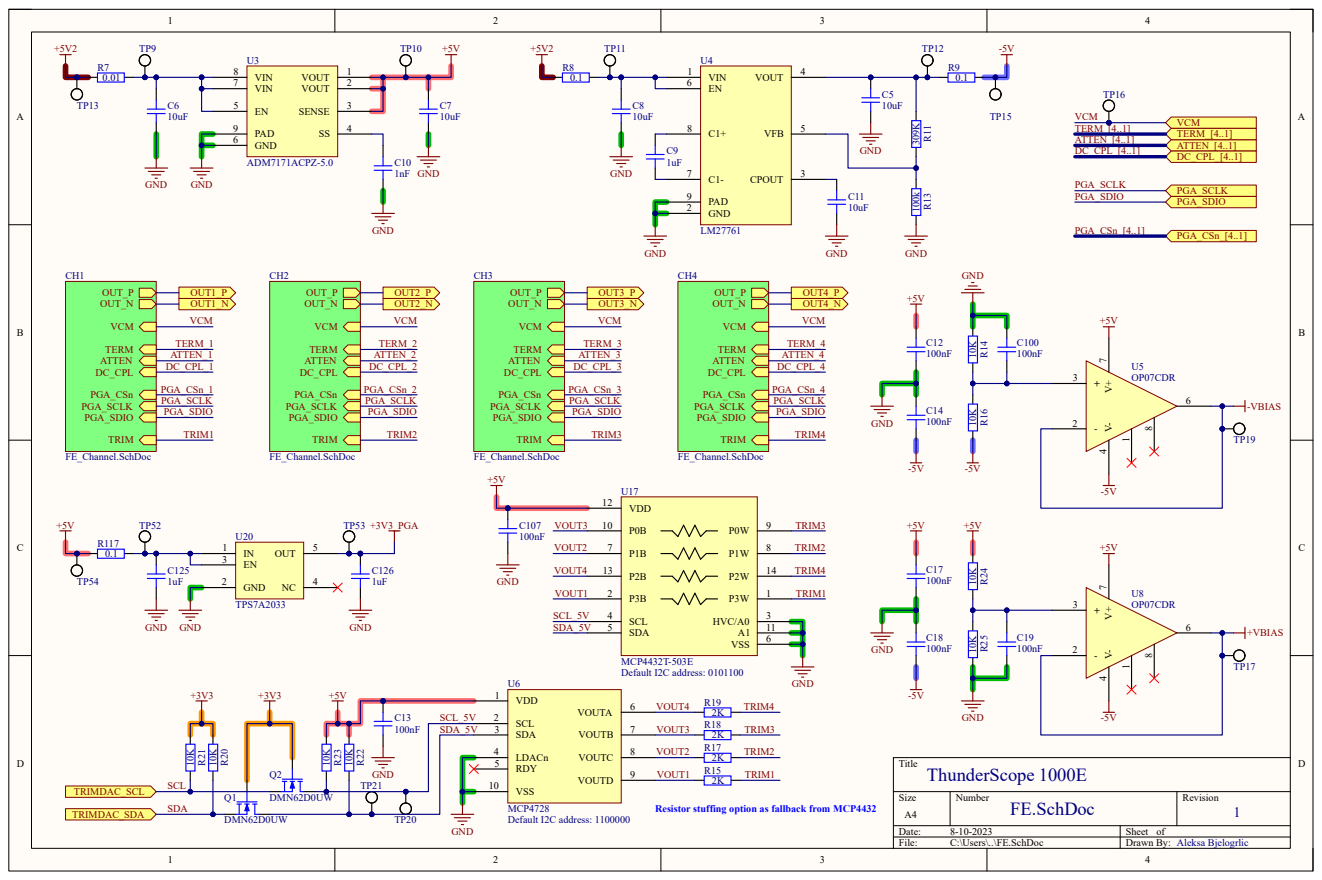
[picture p83: page 3]

Resistor stuffing option as fallback from MCP4432

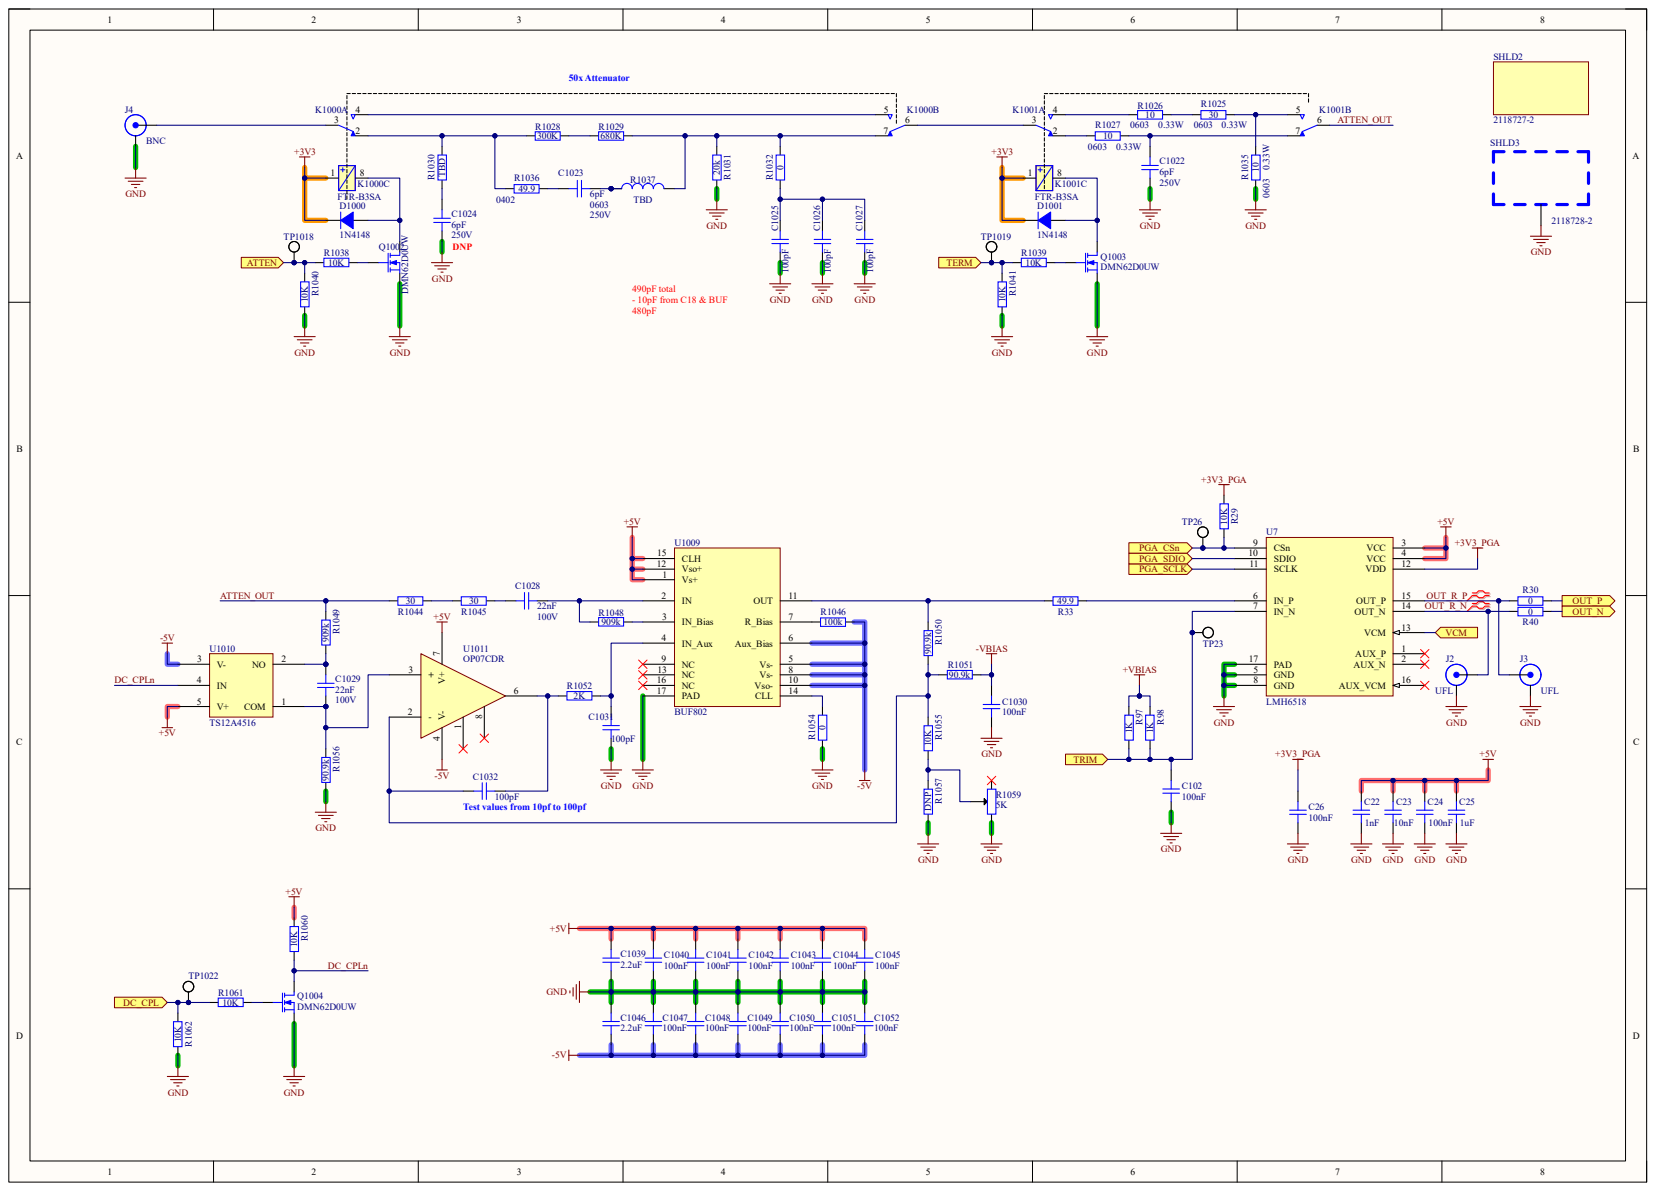
[picture p84: page 4]

Test values from 10pf to 100pf R¹⁰⁶⁰ 10K

GND GND

## DONE: Backwards compatibility with TE0712

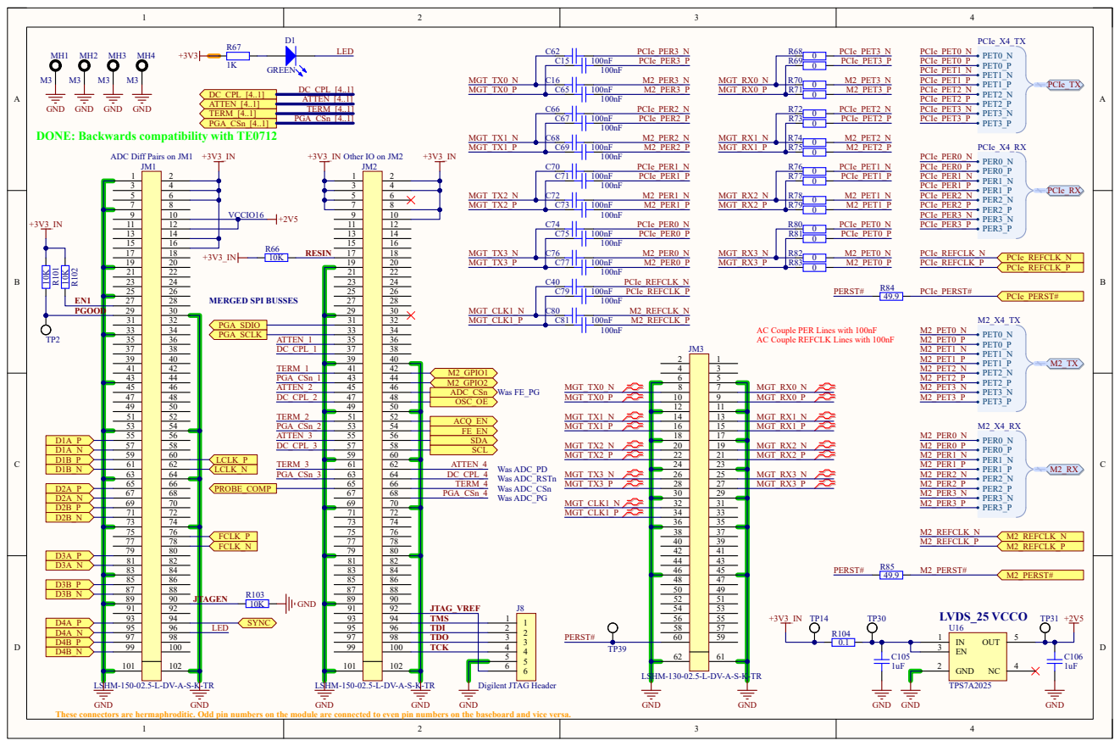
[picture p85: page 5]

GND GND

PGOOD ¹⁰K R¹⁰¹ ¹⁰K R¹⁰²

AC Couple PER Lines with 100nF
AC Couple REFCLK Lines with 100nF

These connectors are hermaphroditic. Odd pin numbers on the module are connected to even pin numbers on the baseboard and vice versa.

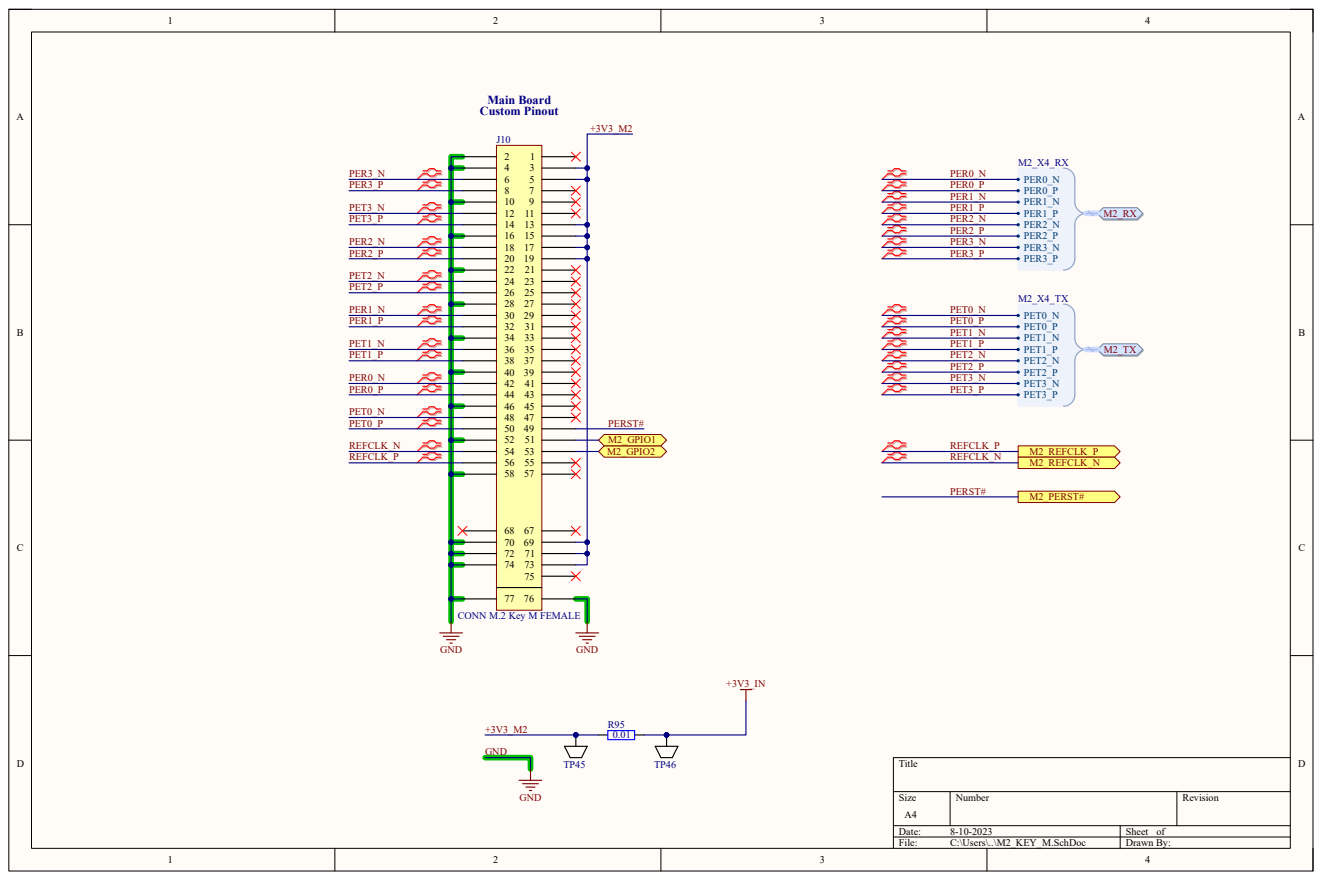
[picture p86: page 6]
Title; Size; Number; Revision; File:; C:\Users\..\M2_KEY_M.SchDoc; Drawn By:; PET0_N PET0_P PET1_N PET1_P PET2_N PET2_P PET3_N PET3_P; PER0_N PER0_P PER1_N PER1_P PER2_N PER2_P PER3_N PER3_P; GND; REFCLK_N; REFCLK_P; PERST#; M2_REFCLK_P M2_REFCLK_N; M2_PERST#; Main Board Custom Pinout; REFCLK_N REFCLK_P; PER3_N PER3_P; PET3_N PET3_P; PER2_N PER2_P; PET2_N PET2_P; PER1_N PER1_P; PET1_N PET1_P; PER0_N PER0_P; PET0_N PET0_P; M2_GPIO2; M2_GPIO1

CONN M.2 Key M FEMALE

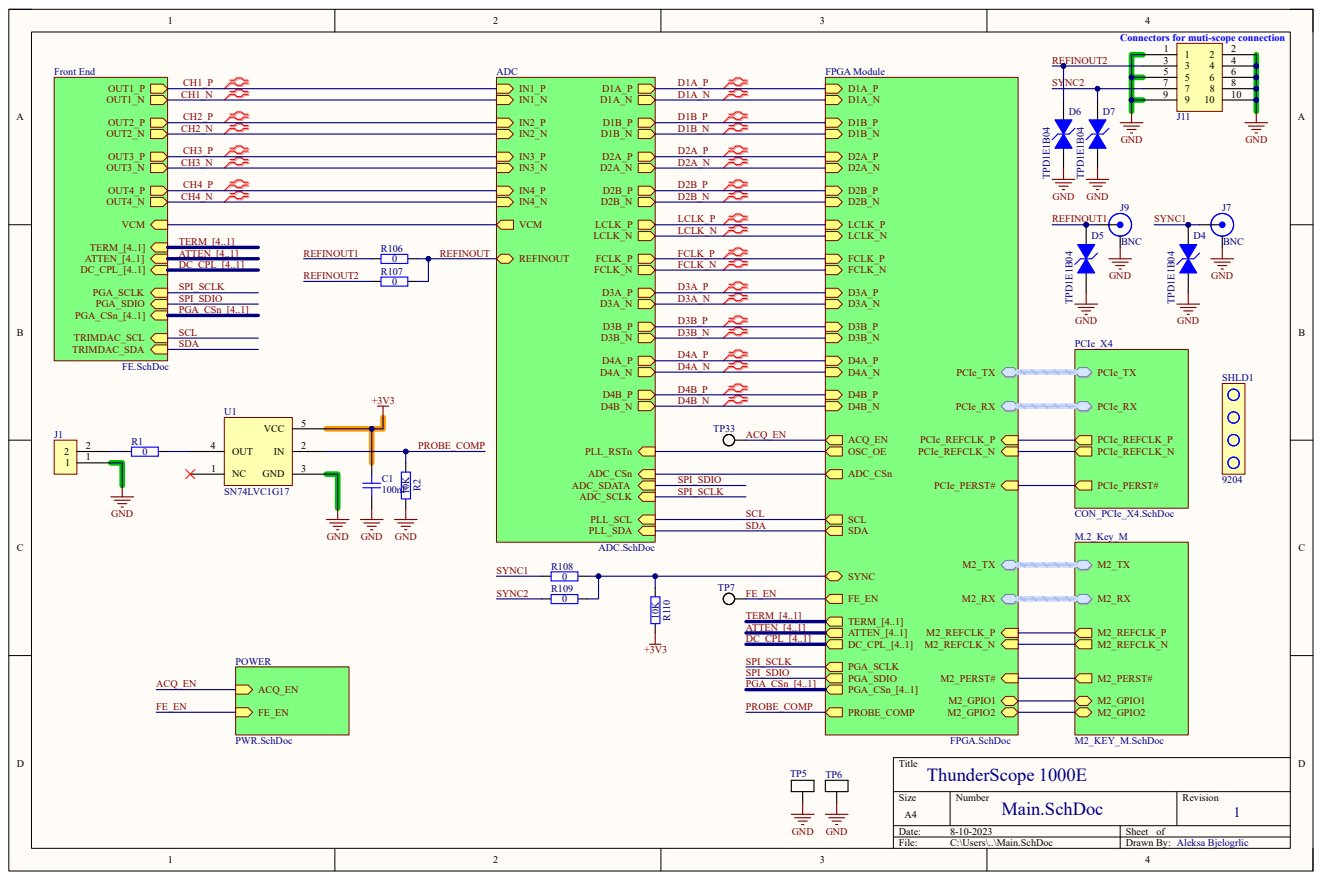
[picture p87: page 7]

Connectors for muti-scope connection

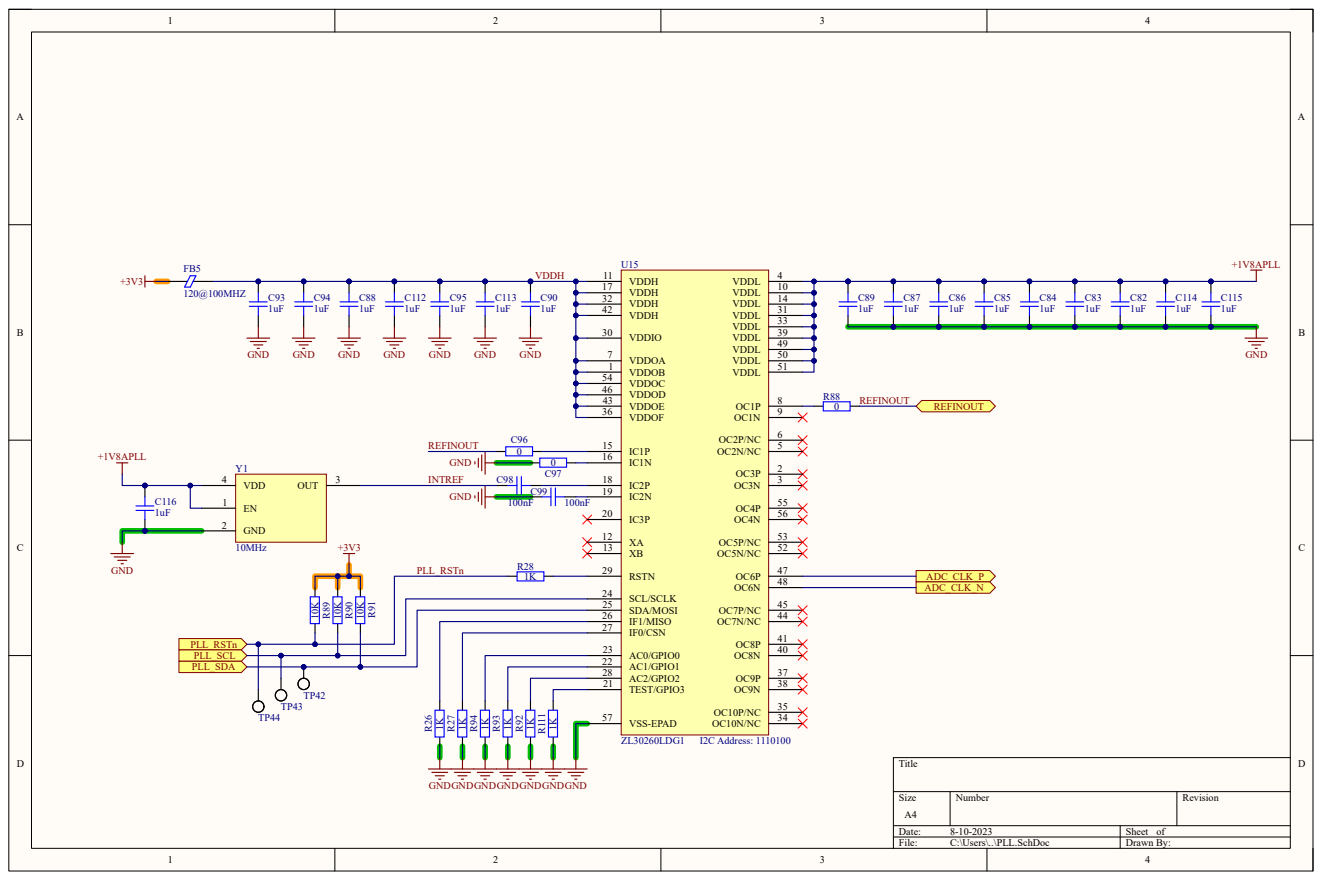
[picture p88: page 8]

0 REFINOUT REFINOUT R²⁶ ¹KR²⁷ ¹K

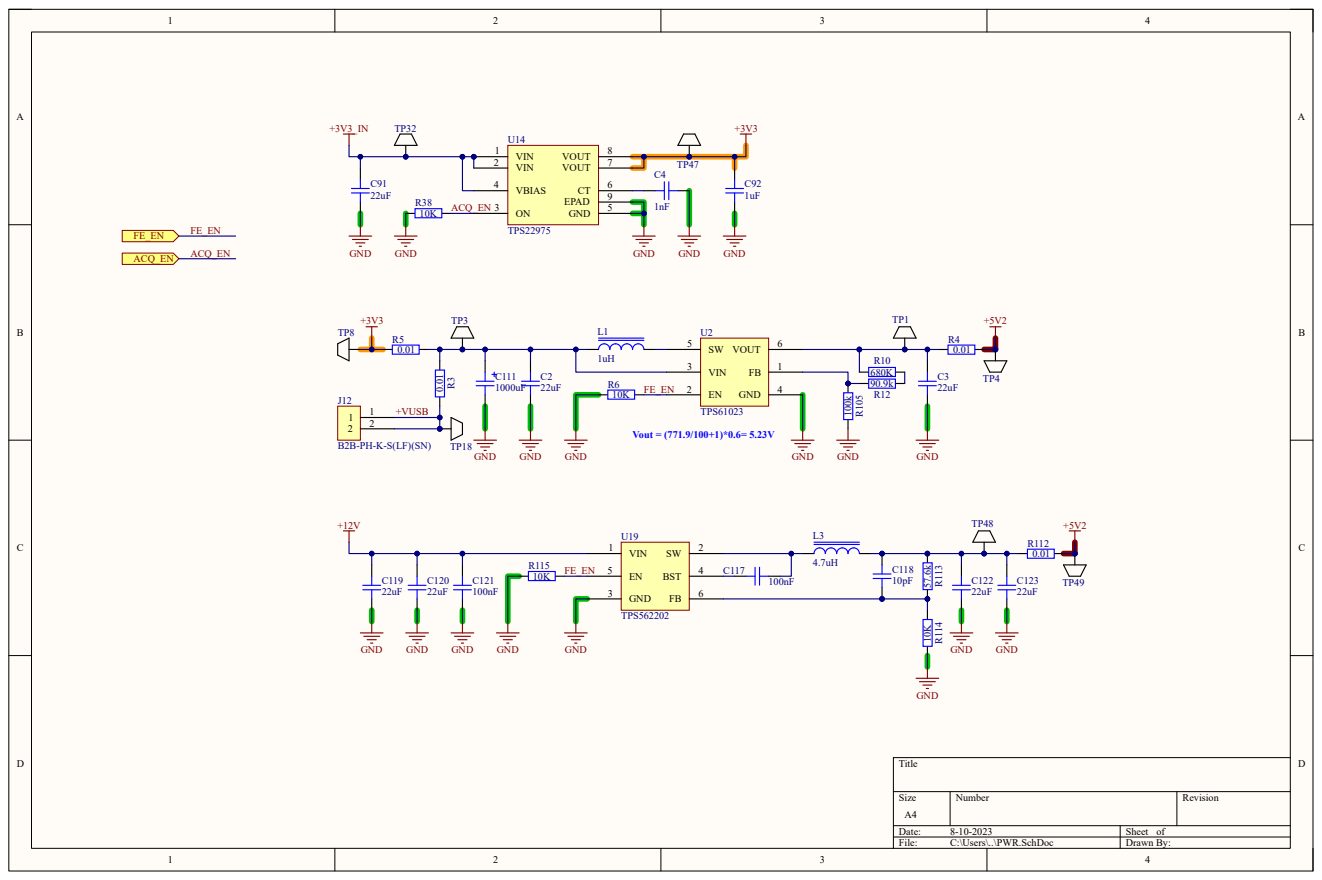
[picture p89: page 9]
