EEVengers/ts_hardware_archive/(list of files, drawings)

Other design files:
Altium/3V3_Load_Switch_Bodge/3V3_Load_Switch_Bodge.PcbDoc
Altium/3V3_Load_Switch_Bodge/3V3_Load_Switch_Bodge.PrjPcb
Altium/3V3_Load_Switch_Bodge/Main.SchDoc
Altium/DSO.SchLib
Altium/End_Caps/Back.PcbDoc
Altium/End_Caps/End_Caps.PrjPcb
Altium/End_Caps/Front.PcbDoc
Altium/FPGA_Module/Connectors.SchDoc
Altium/FPGA_Module/DDR3L.SchDoc
Altium/FPGA_Module/FPGA_Bank_IO.SchDoc
Altium/FPGA_Module/FPGA_Banks_DDR3.SchDoc
Altium/FPGA_Module/FPGA_CFG.SchDoc
Altium/FPGA_Module/FPGA_MGT.SchDoc
Altium/FPGA_Module/FPGA_Module.PrjPcb
Altium/FPGA_Module/FPGA_PWR.SchDoc
Altium/FPGA_Module/PWR.SchDoc
Altium/FPGA_Module_Rev2/Connectors.SchDoc
Altium/FPGA_Module_Rev2/DDR3L.SchDoc
Altium/FPGA_Module_Rev2/FPGA_Bank_IO.SchDoc
Altium/FPGA_Module_Rev2/FPGA_Banks_DDR3.SchDoc
Altium/FPGA_Module_Rev2/FPGA_CFG.SchDoc
Altium/FPGA_Module_Rev2/FPGA_MGT.SchDoc
Altium/FPGA_Module_Rev2/FPGA_Module.PrjPcb
Altium/FPGA_Module_Rev2/FPGA_Module_Panel.PcbDoc
Altium/FPGA_Module_Rev2/FPGA_PWR.SchDoc
Altium/FPGA_Module_Rev2/PWR.SchDoc
Altium/M.2_Interposer/Adaptor_Board.PcbDoc
Altium/M.2_Interposer/Adaptor_Board.PrjPcb
Altium/M.2_Interposer/Main.SchDoc
Altium/Rev4_FE_Test/FE.SchDoc
Altium/Rev4_FE_Test/FE_Channel.SchDoc
Altium/Rev4_FE_Test/Rev4_FE_Test.PCBDOC
Altium/Rev4_FE_Test/Rev4_FE_Test.PrjPCB
Altium/Rev5_FE_Test/FE.SchDoc
Altium/Rev5_FE_Test/FE_Channel.SchDoc
Altium/Rev5_FE_Test/Rev5_FE_Test.PrjPCB
Altium/Rev5_FE_Test_Latched/FE.SchDoc
Altium/Rev5_FE_Test_Latched/FE_Channel.SchDoc
Altium/Rev5_FE_Test_Latched/Rev5_FE_Test_Latched.PrjPCB
Altium/Rev5_FE_Test_V2/FE.SchDoc
Altium/Rev5_FE_Test_V2/FE_Channel.SchDoc
Altium/Rev5_FE_Test_V2/Rev5_FE_Test_V2.PrjPCB
Altium/Thunderscope_E/ADC.SchDoc
Altium/Thunderscope_E/Buffer.SchDoc
Altium/Thunderscope_E/FE.SchDoc
Altium/Thunderscope_E/FE_Channel.SchDoc
Altium/Thunderscope_E/FPGA.SchDoc
Altium/Thunderscope_E/Input.SchDoc
Altium/Thunderscope_E/LEDs.SchDoc
Altium/Thunderscope_E/Main.SchDoc
Altium/Thunderscope_E/Managed/Sheets/FC1D1A13-1D8D-4C53-8666-9A4B6D32A5EC/CON_PCIe_X4.SchDoc
Altium/Thunderscope_E/PGA.SchDoc
Altium/Thunderscope_E/PLL.SchDoc
Altium/Thunderscope_E/Thunderscope-E.PrjPCB
Altium/Thunderscope_Rev2/ADC.SchDoc
Altium/Thunderscope_Rev2/Buffer.SchDoc
Altium/Thunderscope_Rev2/FE.SchDoc
Altium/Thunderscope_Rev2/FE_Channel.SchDoc
Altium/Thunderscope_Rev2/FPGA.SchDoc
Altium/Thunderscope_Rev2/Input.SchDoc
Altium/Thunderscope_Rev2/M2_KEY_M.SchDoc
Altium/Thunderscope_Rev2/Main.SchDoc
Altium/Thunderscope_Rev2/Managed/Sheets/FC1D1A13-1D8D-4C53-8666-9A4B6D32A5EC/CON_PCIe_X4.SchDoc
Altium/Thunderscope_Rev2/PGA.SchDoc
Altium/Thunderscope_Rev2/PLL.SchDoc
Altium/Thunderscope_Rev2/Thunderscope_Rev2.PrjPCB
Altium/Thunderscope_Rev3/ADC.SchDoc
Altium/Thunderscope_Rev3/FE.SchDoc
Altium/Thunderscope_Rev3/FE_Channel.SchDoc
Altium/Thunderscope_Rev3/FPGA.SchDoc
Altium/Thunderscope_Rev3/M2_KEY_M.SchDoc
Altium/Thunderscope_Rev3/Main.SchDoc
Altium/Thunderscope_Rev3/Managed/Sheets/FC1D1A13-1D8D-4C53-8666-9A4B6D32A5EC/CON_PCIe_X4.SchDoc
Altium/Thunderscope_Rev3/PLL.SchDoc
Altium/Thunderscope_Rev3/Thunderscope_Rev3.PrjPCB
Altium/Thunderscope_Rev4.1/ADC.SchDoc
Altium/Thunderscope_Rev4.1/FE.SchDoc
Altium/Thunderscope_Rev4.1/FE_Channel.SchDoc
Altium/Thunderscope_Rev4.1/FPGA.SchDoc
Altium/Thunderscope_Rev4.1/M2_KEY_M.SchDoc
Altium/Thunderscope_Rev4.1/Main.SchDoc
Altium/Thunderscope_Rev4.1/Managed/Sheets/FC1D1A13-1D8D-4C53-8666-9A4B6D32A5EC/CON_PCIe_X4.SchDoc
Altium/Thunderscope_Rev4.1/PLL.SchDoc
Altium/Thunderscope_Rev4.1/PWR.SchDoc
Altium/Thunderscope_Rev4.1/Thunderscope_Rev4.1.PrjPCB
Altium/Thunderscope_Rev4/ADC.SchDoc
Altium/Thunderscope_Rev4/FE.SchDoc
Altium/Thunderscope_Rev4/FE_Channel.SchDoc
Altium/Thunderscope_Rev4/FPGA.SchDoc
Altium/Thunderscope_Rev4/M2_KEY_M.SchDoc
Altium/Thunderscope_Rev4/Main.SchDoc
Altium/Thunderscope_Rev4/Managed/Sheets/FC1D1A13-1D8D-4C53-8666-9A4B6D32A5EC/CON_PCIe_X4.SchDoc
Altium/Thunderscope_Rev4/PLL.SchDoc
Altium/Thunderscope_Rev4/PWR.SchDoc
Altium/Thunderscope_Rev4/Thunderscope_Rev4.PrjPCB
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
