EEVengers/ts_hardware_archive/KiCad/Thunderscope_Rev5_Mech_Model/Thunderscope_Rev5_Mech_Model.kicad_pcb

## KiCad design KiCad/Thunderscope_Rev5_Mech_Model/Thunderscope_Rev5_Mech_Model.kicad_pcb (2026-06-19)

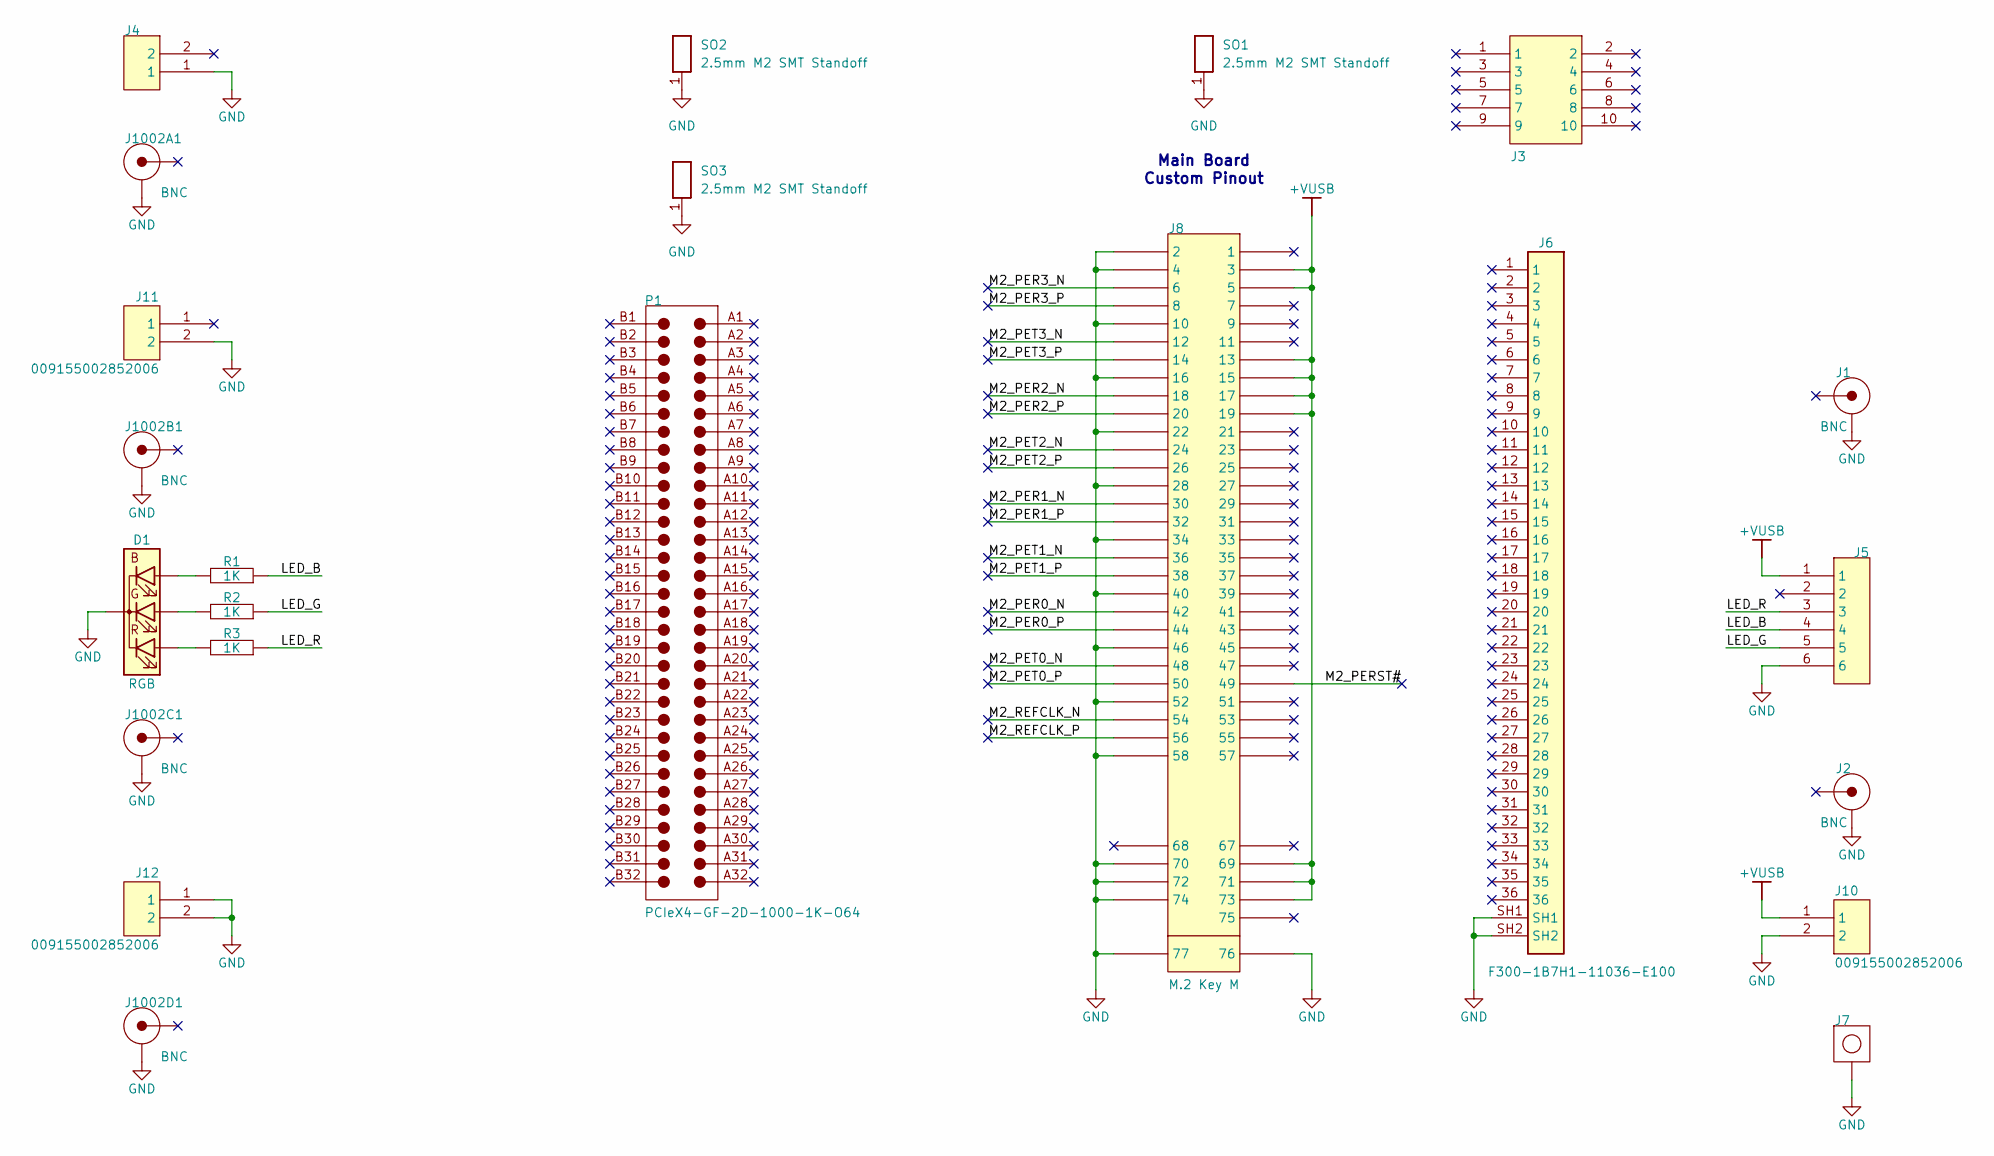
[picture p90: schematic Thunderscope_Rev5_Mech_Model.kicad_sch, ThunderScope]

Parts:
D1: RGB; LED_Kingbright_APFA3010_3x1.5mm_Horizontal; MANUFACTURER PART NUMBER APFA3010LSEKJ3ZGKQBC
J1, J2, J1002A1, J1002B1, J1002C1, J1002D1: BNC; MOL_0731000105; MANUFACTURER PART NUMBER 73100-0105
J3: 1.27mm 6 Pin TH; GEN_1.27mm_2x5_Pin_TH_RA; MANUFACTURER PART NUMBER 3220-10-0200-00
J4: TSW-101-16-G-Q-RA; GEN_5.08mm_1x2_Pin_TH_RA; MANUFACTURER PART NUMBER TSW-101-16-G-Q-RA
J5: 2.54mm 6 Pin TH; GEN_2.54MM_6_PIN_TH_RA; MANUFACTURER PART NUMBER 61300611021
J6: F300-1B7H1-11036-E100; AMPHENOL_F300-1B7H1-11036-E100; MANUFACTURER PART NUMBER F300-1B7H1-11036-E100
J7: 7792; KEY_7792; MANUFACTURER PART NUMBER 7792
J8: M.2 Key M; TE_M2_KEYM_2199230; MANUFACTURER PART NUMBER 1-2199230-5
J10, J11, J12: 009155002852006; KYO_009155002852006; MANUFACTURER PART NUMBER 009155002852006
P1: PCIeX4-GF-2D-1000-1K-O64
R1, R2, R3: 1K; GEN_R_0402; TOLERANCE 1%; MANUFACTURER PART NUMBER RC0402FR-071KL
SO1, SO2, SO3: 2.5mm M2 SMT Standoff; M2_SMT_Standoff_9774025243R; MANUFACTURER PART NUMBER 9774025243R

Connections:
+VUSB: J5.1, J8.3, J8.5, J8.13, J8.15, J8.17, J8.19, J8.69, J8.71, J8.73, J10.1
/LED_B: J5.4, R1.1
/LED_G: J5.5, R2.1
/LED_R: J5.3, R3.1
/M2_PER0_N: J8.42
/M2_PER0_P: J8.44
/M2_PER1_N: J8.30
/M2_PER1_P: J8.32
/M2_PER2_N: J8.18
/M2_PER2_P: J8.20
/M2_PER3_N: J8.6
/M2_PER3_P: J8.8
/M2_PERST#: J8.49
/M2_PET0_N: J8.48
/M2_PET0_P: J8.50
/M2_PET1_N: J8.36
/M2_PET1_P: J8.38
/M2_PET2_N: J8.24
/M2_PET2_P: J8.26
/M2_PET3_N: J8.12
/M2_PET3_P: J8.14
/M2_REFCLK_N: J8.54
/M2_REFCLK_P: J8.56
GND: D1.2 (A), J1.2 (SHIELD), J2.2 (SHIELD), J4.1, J5.6, J6.SH1, J6.SH2, J7.1, J8.2, J8.4, J8.10, J8.16, J8.22, J8.28, J8.34, J8.40, J8.46, J8.52, J8.58, J8.70, J8.72, J8.74, J8.76, J8.77, J10.2, J11.2, J12.1, J12.2, J1002A1.2 (SHIELD), J1002B1.2 (SHIELD), J1002C1.2 (SHIELD), J1002D1.2 (SHIELD), SO1.1, SO2.1, SO3.1
unnamed: D1.4 (B), R1.2
unnamed: D1.3 (G), R2.2
unnamed: D1.1 (R), R3.2

Notes on the sheet:
Main Board
Custom Pinout

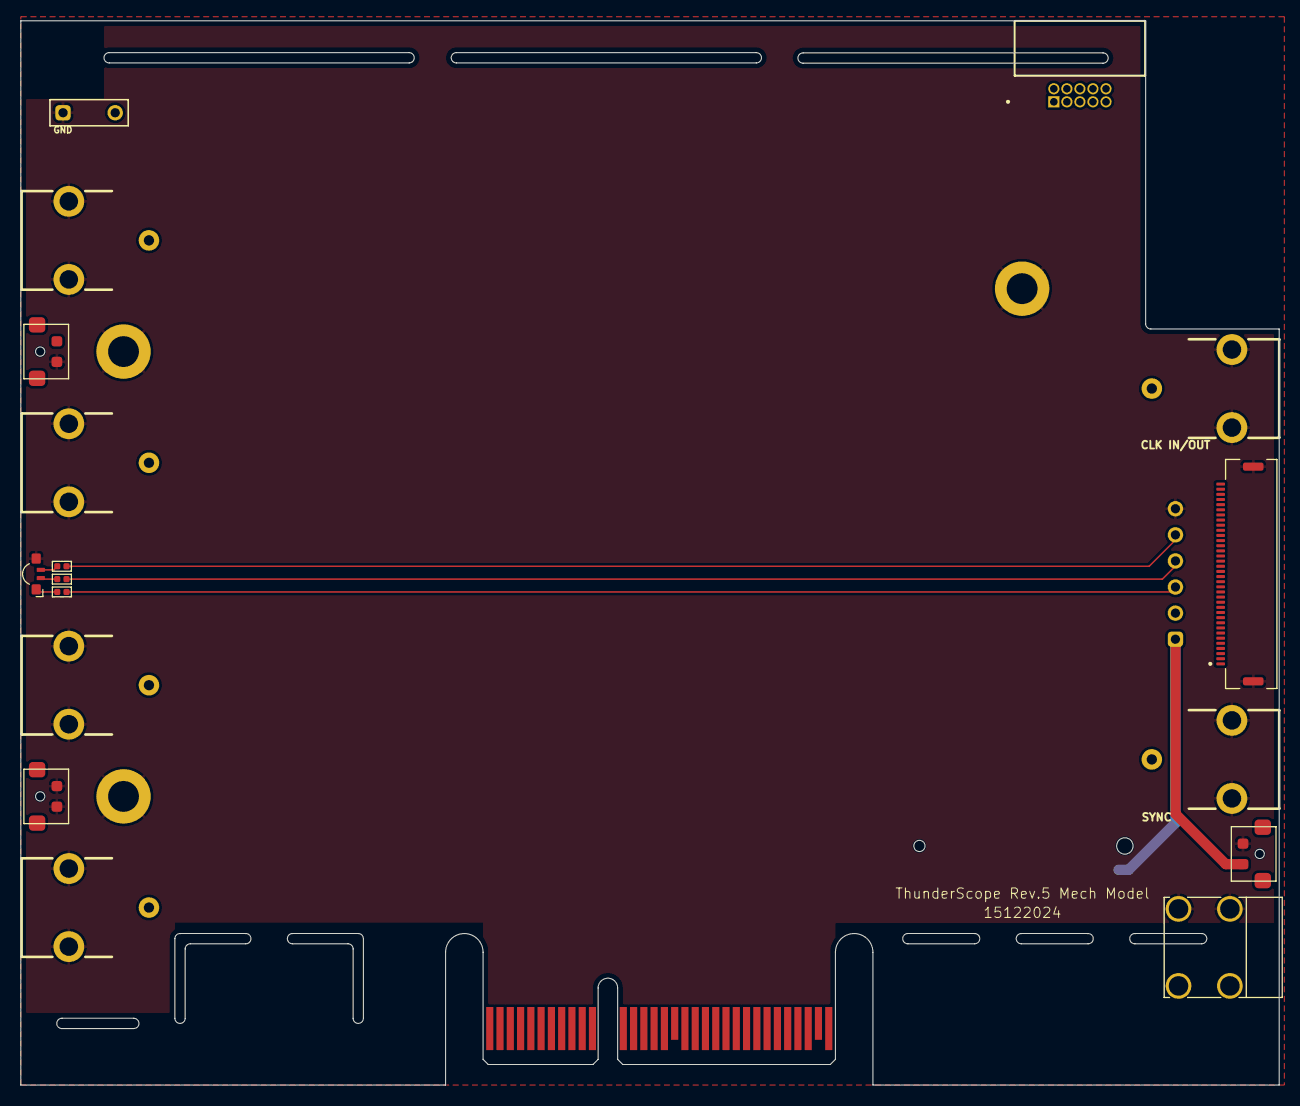
[picture p91: board Thunderscope_Rev5_Mech_Model.kicad_pcb from above]

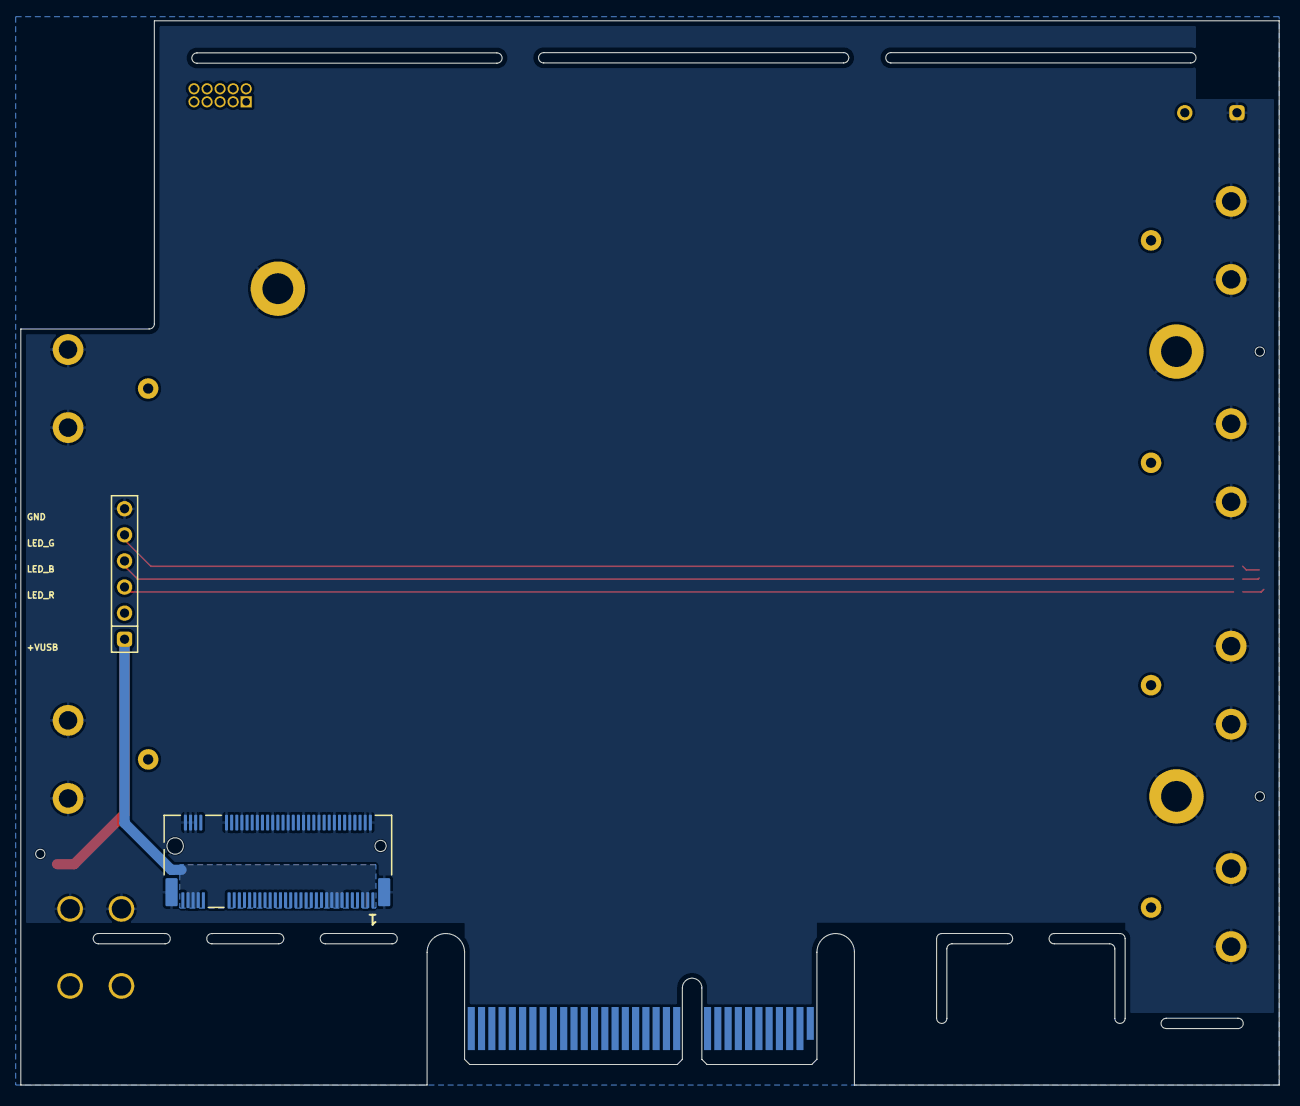
[picture p92: board Thunderscope_Rev5_Mech_Model.kicad_pcb from below]

Board: 2 copper layers, 122.5 x 103.6 mm, 23 parts (5 on the bottom side), 8 nets.
